nxvxr14/control-celda-fts-mecatronica-UNAB/Electronica/Imagenes/frontalView.png

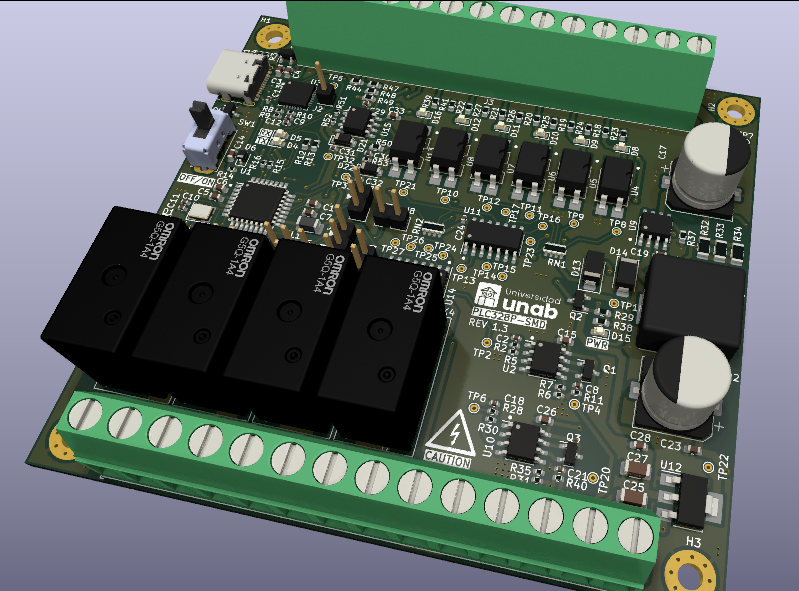
Electronica/Imagenes/frontalView.png
