nxvxr14/control-celda-fts-mecatronica-UNAB/Electronica/README.txt

*3D: Archivos .STL de componentes electrónicos no incluidos en las librerías de KiCad.
*Datasheets: Documentos en formato .pdf de las especificaciones de los distintos componentes utilizados en las tarjetas.
*Esquemáticos de referencia: Documentos .pdf con los esquemáticos de algunas tarjetas Arduino.
*Esquemáticos finales PDF: Documentos .pdf con los esquemáticos definitivos de las tarjetas del proyecto.
*Huellas y símbolos: Archivos de componentes necesarios que no se encuentran en las librerías nativas de KiCad.
*Imágenes: Archivos .PNG con las vistas 3D de las tarjetas.
*PCB Designs: Incluye los cuatro diseños electrónicos, con sus respectivos esquemáticos, símbolos, ruteados y referencias de componentes para su fabricación en JLCPCB, se abre con Kicad 7.0 o más:

-schematicFisher: Tarjeta para la adecuación de señales, convirtiendo voltajes de 9V a 24V y viceversa.
-schematicPLC: Tarjeta principal del PLC.
-schematicPowerSourcePLC: Tarjeta de alimentación para el PLC, con las fuentes de voltaje necesarias.
-schematicShieldPLC: Tarjeta diseñada para conectar un Arduino Mega al PLC.

*plcIMG.pretty: Archivo generado automáticamente por KiCad.
*Recortes de placa: No utilizado en el proyecto.
*Simulaciones: Simulaciones de los distintos circuitos implementados, realizadas en Proteus.
