nxvxr14/control-celda-fts-mecatronica-UNAB/Laboratorios/LAB1_INTRODUCCION_ILYZAELLE_CASTRO_DELGADO.pdf

Laboratorio 1: Introducción a Ilyzaelle

### LABORATORIO 1: INTRODUCCIÓN A ILYZAELLE

### 1. Introducción:

En este laboratorio, se aprenderá a configurar y emplear la plataforma Ilyzaelle. A lo largo de las actividades, se familiariza al estudiante con su entorno y sus funcionalidades, y se llevarán a cabo ejemplos prácticos en los que se conectarán dos placas Arduino para establecer una comunicación efectiva entre ellas.

### 2. Objetivos:

1. Instalar y configurar la plataforma Ilyzaelle en un entorno de desarrollo local.
2. Crear un proyecto en la plataforma Ilyzaelle y asociar los controladores.
3. Verificar la comunicación bidireccional entre los Arduinos y la plataforma a través del Gateway.
4. Elaborar la topología de red que describa la interacción entre la plataforma, el Gateway y los controladores.

### 3. Requisitos

### 3.1 Requisitos Software:

1. Node.js (versión 20.x.x)
2. Arduino IDE (versión 1.18.x.x)
3. Python (versión 3.10.x.x)
4. Microsoft C++ Build Tools
5. ilyzaelleGatewayManager_0.1.bat

### 3.2 Requisitos Hardware:

1. 2x Arduino Uno/MEGA

2. 1x Computadora Windows 11

### 4. Marco Teorico:

### 4.1 Definiciones claves:

Gateway IoT: Dispositivo o software que actúa como intermediario entre los nodos finales (sensores y actuadores) y la nube, gestionando protocolos, seguridad y enrutamiento de datos para garantizar la comunicación eficiente en sistemas de Internet de las Cosas (Stallings, 2013).

Plataforma IoT: Entorno integrado de hardware, software y servicios en la nube que permite el registro, la gestión, el almacenamiento y el análisis de datos generados por dispositivos conectados, facilitando la creación y el despliegue de aplicaciones IoT (Greengard, 2015).

Protocolo de comunicación: Conjunto de reglas y convenciones que definen el formato, la secuencia y la semántica de los mensajes intercambiados entre dos o más entidades de red, asegurando interoperabilidad y fiabilidad en la transmisión de información. (Tanenbaum & Wetherall, 2011).

JavaScript: Lenguaje de programación interpretado, orientado a eventos y de un solo hilo, que se ejecuta en el motor de JavaScript del entorno (por ejemplo, en el navegador o en Node.js). A diferencia de Arduino, donde el programa se basa en un bucle infinito loop(), JavaScript emplea un event loop que gestiona una cola de eventos y callbacks, procesando cada uno de manera asíncrona según la disponibilidad de recursos y las operaciones de E/S (Flanagan, 2011).

Socket-IO: Biblioteca de JavaScript que facilita la creación de aplicaciones web en tiempo real mediante una comunicación bidireccional basada en eventos entre el cliente y el servidor. Utiliza WebSocket cuando está disponible y, de forma transparente, recurre a otras tecnologías como polling largo o Flash Sockets en navegadores que no lo soportan (Buna, 2012).

### 4.2 Preguntas claves:

¿Qué es Node.js y para qué se utiliza en este contexto?
Node.js es un entorno de ejecución de JavaScript que posibilita la ejecución de código en el servidor. En este laboratorio, se emplea para gestionar el gateway y programar las placas Arduino sin recurrir al Arduino IDE.

¿Cómo se comunican las placas Arduino entre sí y con la plataforma Ilyzaelle?
Las placas Arduino se comunican a través de puertos USB con el ordenador donde está instalado el gateway. Este gateway, a su vez, se conecta con la plataforma Ilyzaelle a través de sockets-io.

¿Qué protocolo de comunicación emplean las placas Arduino para conectarse con el Gateway?
Resulta fundamental comprender que tanto el gateway como los controladores se apoyan en un protocolo propietario —ya sea a través de USB o por Wi‑Fi— para definir, entre otros aspectos, el formato de los mensajes intercambiados, la velocidad de transmisión y los mecanismos de detección de errores. Este esquema uniforme garantiza una conexión fiable y facilita la sincronización de datos entre las distintas unidades.

### 5. Procedimiento:

### 1. Configuración de la plataforma Ilyzaelle:

Paso 1: Abrir el programa IlyzaelleGatewayManager_0.1.

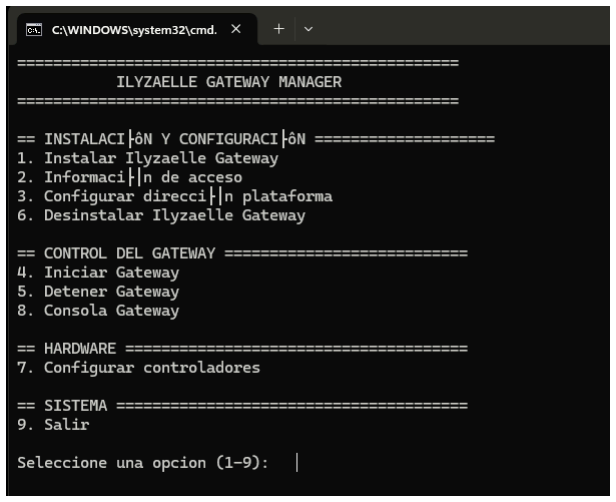
[picture p2: figure]

Paso 2: Instalar el programa. Para ello, escribe el número 1 y presiona Enter. Luego, espera a que el instalador termine el proceso de instalación.

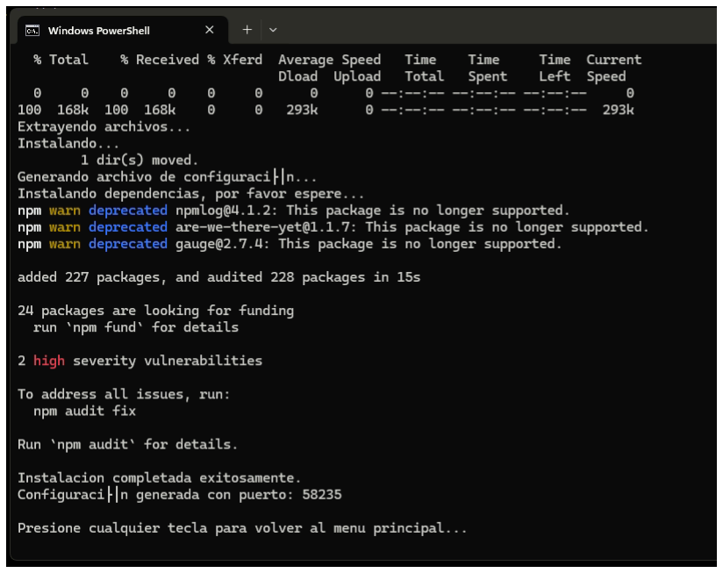
[picture p3: figure]

Paso 3: Configurar los Arduinos.
Una vez que el Gateway está instalado en el computador, procedemos a configurar los controladores. En este caso, utilizaremos dos Arduinos: un Arduino Uno y un Arduino Mega, ambos conectados por USB.
- Conecta ambos Arduinos a sus respectivos puertos USB.
- En el programa IlyzaelleGatewayManager, selecciona la opción 7: Configurar Controladores.
- Luego, selecciona la opción 1: Arduino Uno para configurar el primer Arduino.

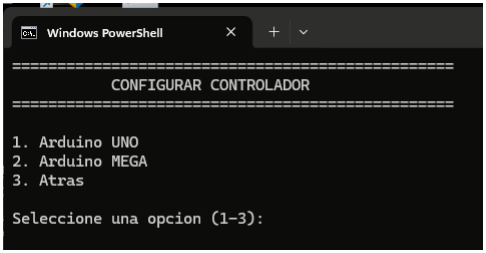
[picture p4: figure]

Una vez realizada la selección, aparecerá una ventana que mostrará cómo está conectado el Arduino. En este caso, selecciona la opción 1: Uno USB para confirmar la conexión del Arduino Uno.

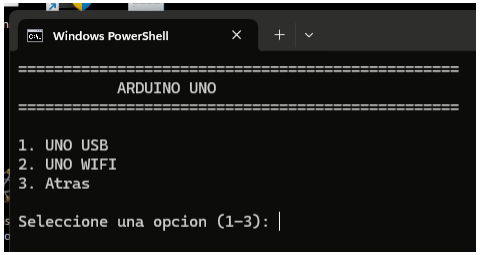
[picture p5: figure]

Aparecerá una ventana que muestra los dispositivos conectados a los puertos COM. Escribe el número del puerto COM al que está conectado tu Arduino y presiona Enter. Por ejemplo: COM6.

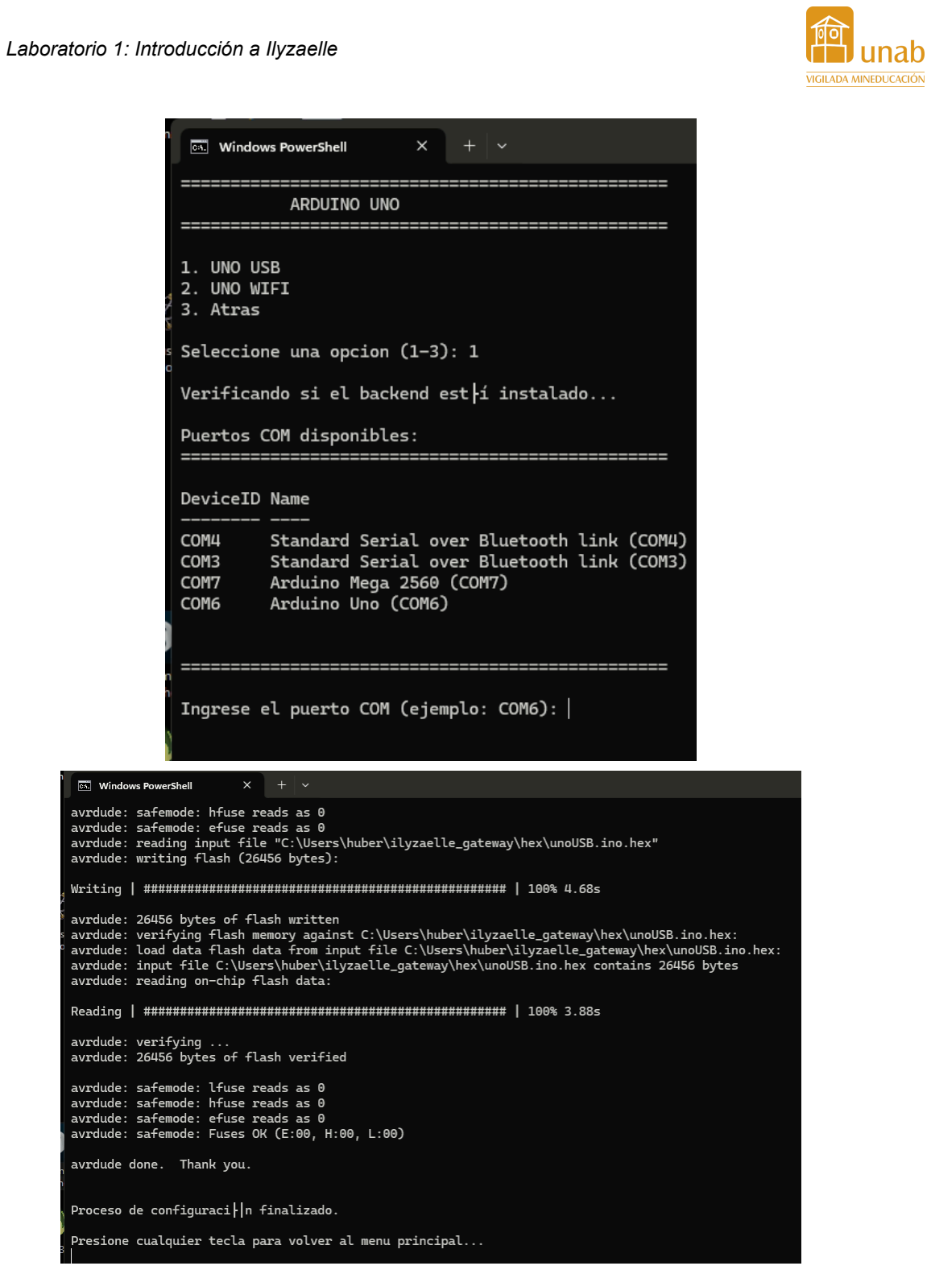
[picture p6: page 6]

Repetimos lo mismo para el mega

Paso 4: Configurar dirección IP de la plataforma

En el menú principal, selecciona la opción 3: Configuración dirección plataforma. Aparecerá la dirección IP actual configurada. Si coincide con la dirección IP de la plataforma, puedes continuar. Si no es la misma, ingresa la nueva dirección IP correspondiente y presiona Enter

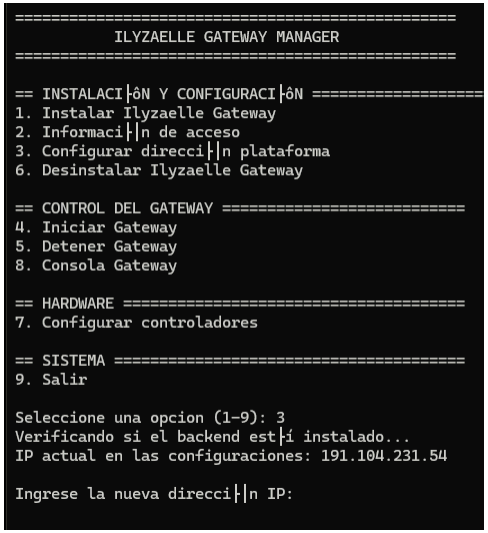
[picture p7: figure]

Nota: La plataforma está alojada en un servidor con IP dinámica, lo que implica cambios periódicos en su dirección. Para garantizar un funcionamiento correcto, es necesario sincronizar la IP del Gateway con la de la plataforma.

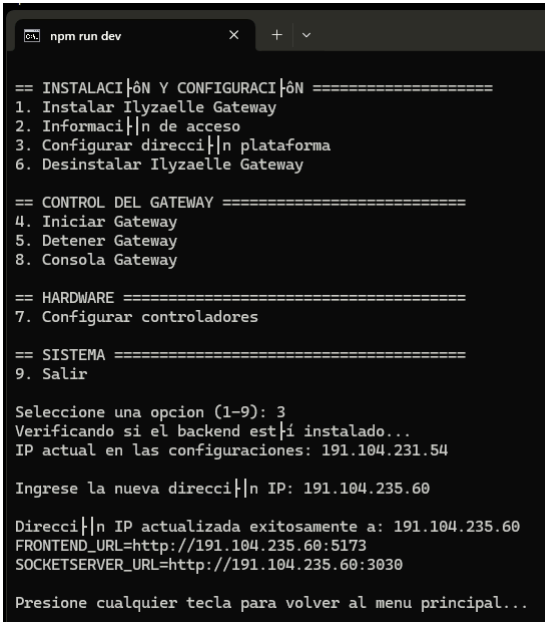
[picture p8: figure]

### 2. Creación proyecto

Paso 1: Accede a la plataforma Ilyzaelle desde tu navegador web.

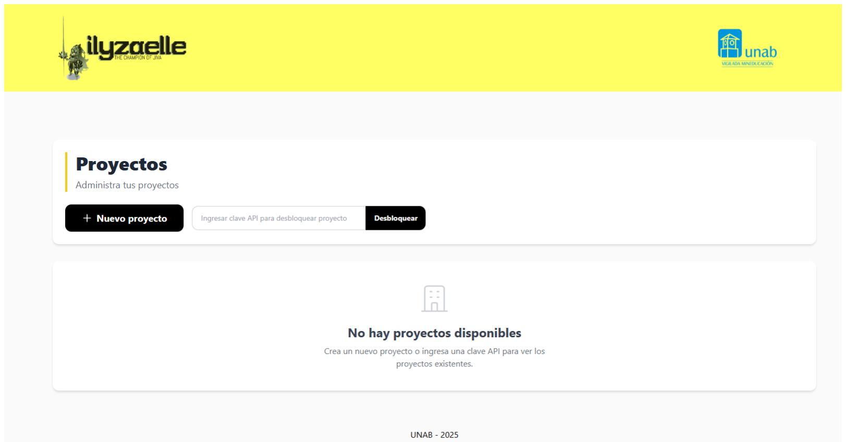
[picture p9: figure]

Paso 2: Selecciona + Nuevo Proyecto. Se abrirá un menú donde crearás un proyecto para trabajar. En este menú, deberás completar los siguientes campos:

- Nombre del proyecto: Puedes poner el nombre que desees.
- Descripción: También es a elección del usuario.
- Gateway: Este dato lo obtendrás del Ilyzaelle Gateway Manager, en la opción 2.
- Gateway API: También se obtiene en la opción 2 del Ilyzaelle Gateway Manager.

Es importante llenar toda la información. Ten especial cuidado de no dejar espacios en blanco, ya que esto puede causar errores en la configuración.

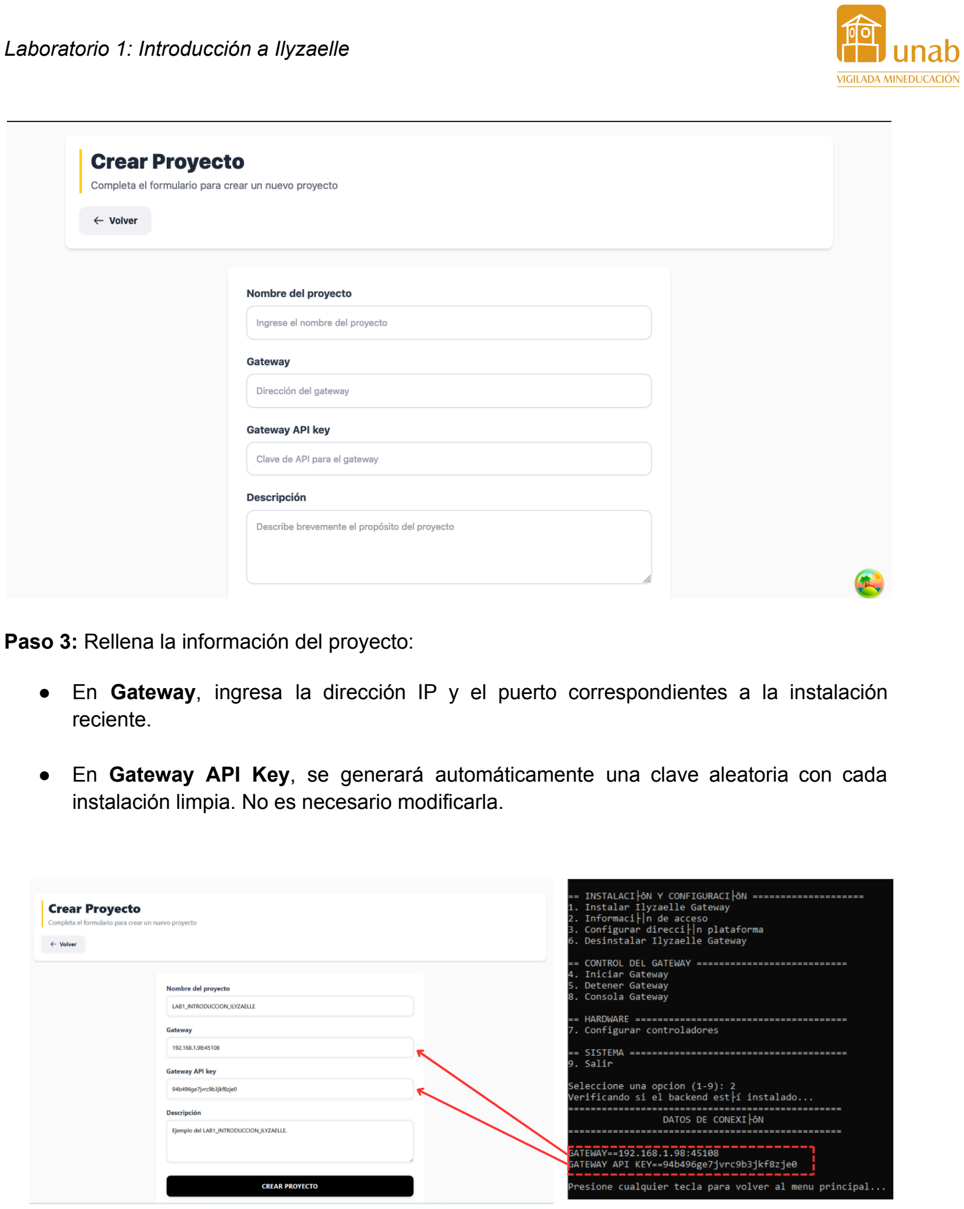
[picture p10: page 10]

Paso 3: Rellena la información del proyecto:

- En Gateway, ingresa la dirección IP y el puerto correspondientes a la instalación reciente.
- En Gateway API Key, se generará automáticamente una clave aleatoria con cada instalación limpia. No es necesario modificarla.

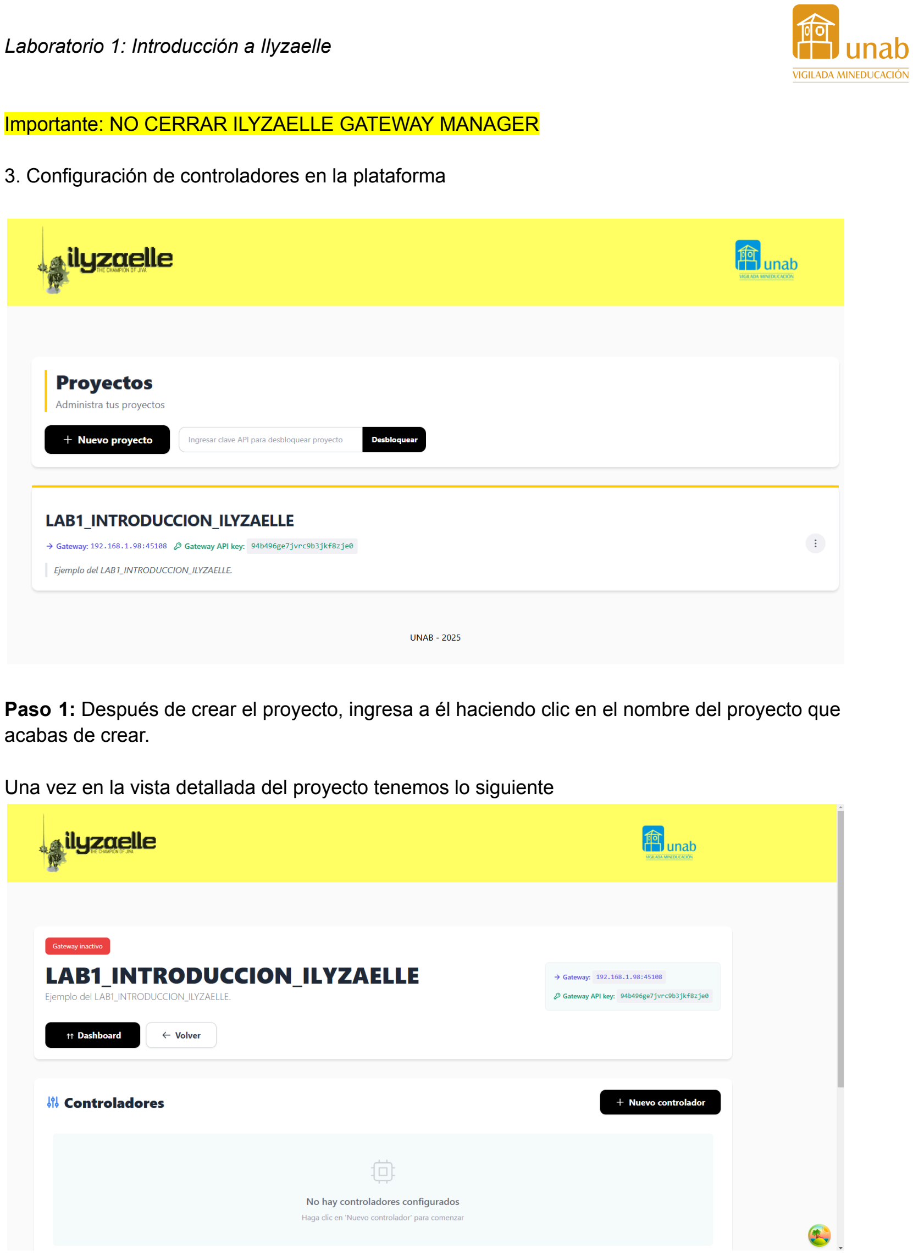
[picture p11: page 11]

Importante: NO CERRAR ILYZAELLE GATEWAY MANAGER

3. Configuración de controladores en la plataforma

Paso 1: Después de crear el proyecto, ingresa a él haciendo clic en el nombre del proyecto que acabas de crear.

Una vez en la vista detallada del proyecto tenemos lo siguiente

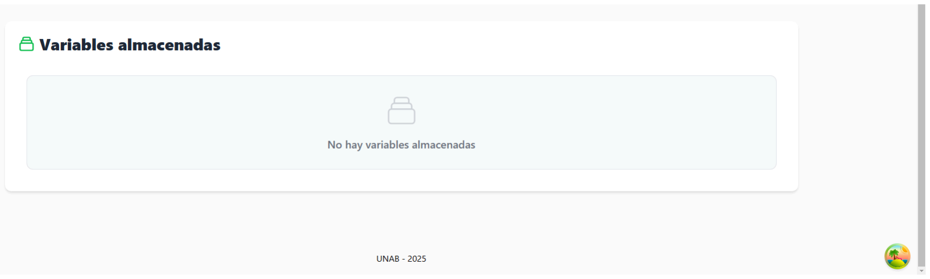
[picture p12: figure]

Gateway inactivo: Indica el estado del gateway.

Dashboard: Aquí podrás visualizar y controlar los datos en tiempo real que se están generando en la plataforma.

Controladores: Esta sección te permite gestionar los controladores, desde su creación y configuración hasta la programación.

Variables almacenadas: Aquí se almacenan los datos históricos que provienen del Dashboard para su posterior consulta o análisis.

Paso 2: Haz clic en + Nuevo Controlador, ubicado en el apartado de Controladores. Esto abrirá un menú que te permitirá configurar el Arduino que vas a utilizar. El menú contiene los siguientes campos:

- Nombre: A elección del usuario (por ejemplo, "Uno Prueba").
- Tipo: Selecciona el tipo de controlador vamos a utilizar. En nuestro caso, seleccionamos Arduino.
- Tipo de conexión: Elige el tipo de conexión que estás utilizando. En este caso, seleccionamos USB.
- Datos de conexión: Aquí deberás ingresar la información correspondiente al puerto de conexión. Para este ejemplo, si estás utilizando un Arduino Uno, solo deberás ingresar el número de puerto (por ejemplo, COM4).

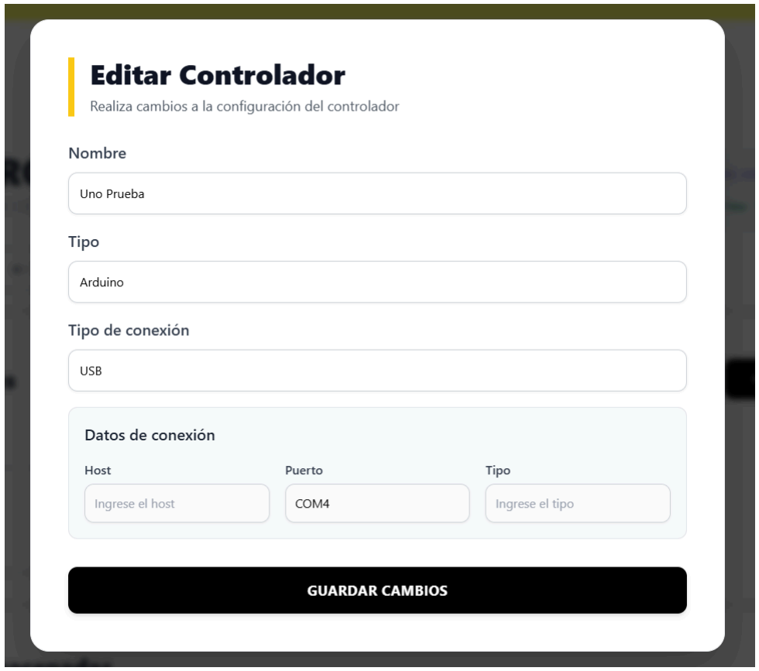
[picture p13: figure]

Realizar el mismo procedimiento con el otro arduino.

Una vez agregados ambos controladores veremos algo así:

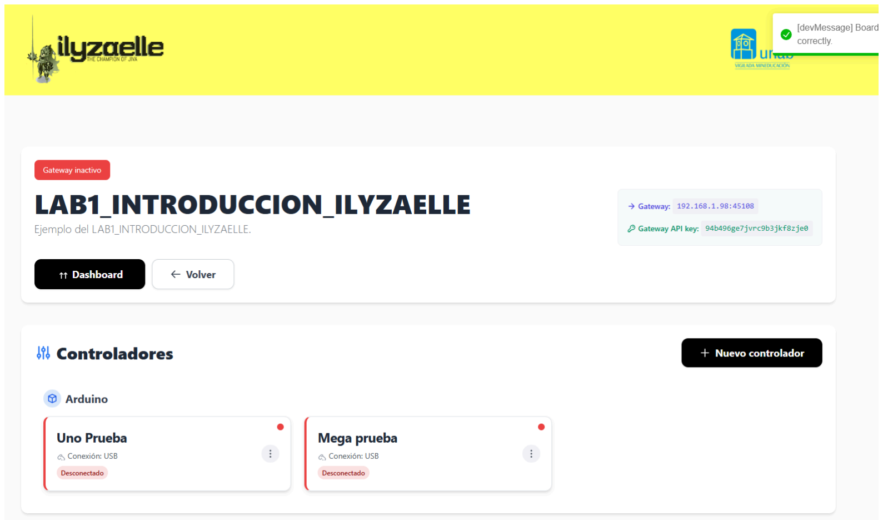
[picture p14: figure]

### 4. Iniciar Gateway

Paso 1: Ahora regresa al Ilyzaelle Gateway Manager y selecciona la opción 4: Iniciar Gateway. Una vez iniciado correctamente, verás cómo el estado del gateway en la plataforma se pone en verde.

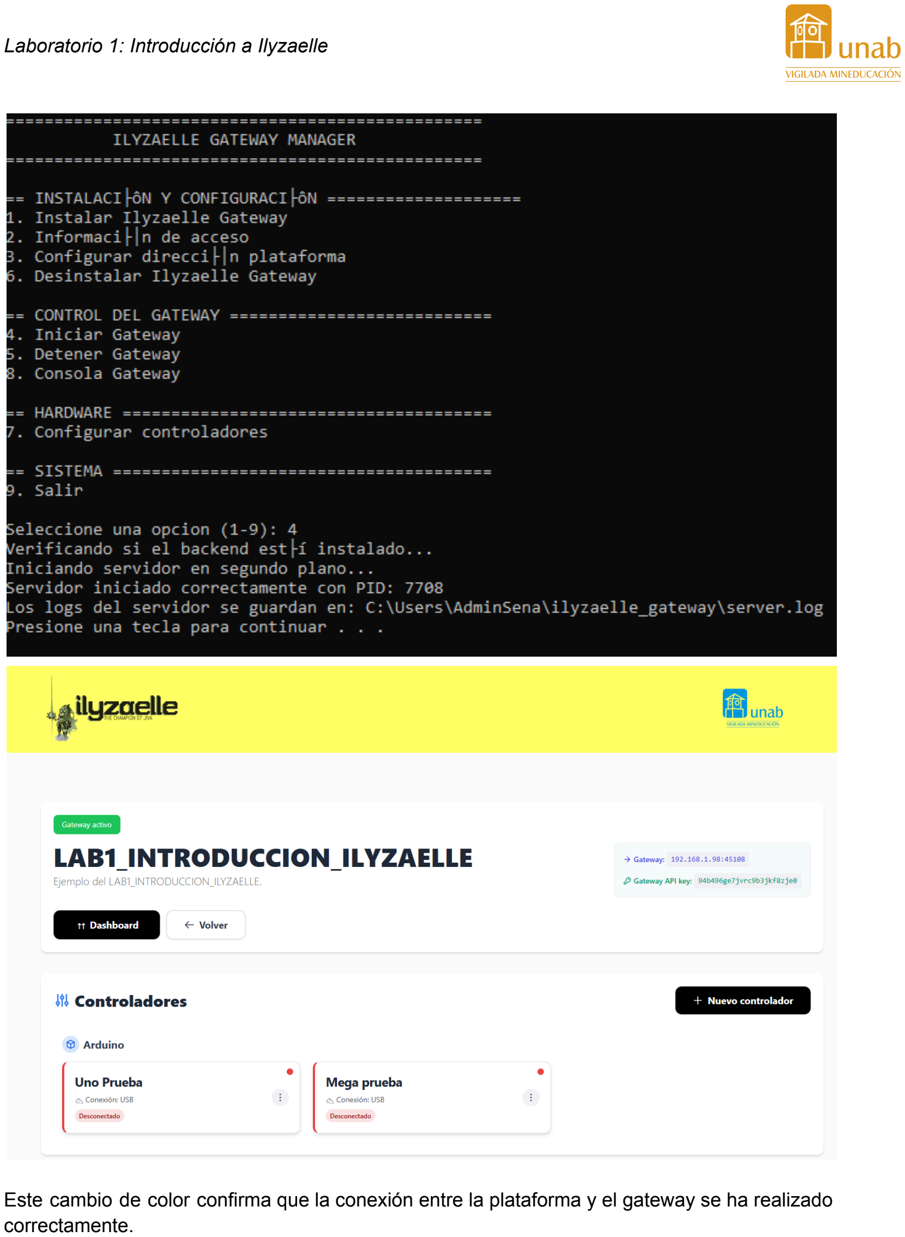
[picture p15: page 15]

Este cambio de color confirma que la conexión entre la plataforma y el gateway se ha realizado correctamente.

### 6. Actividad:

- Crear un diagrama gráfico que ilustre la topología de red. El esquema debe mostrar, para cada dispositivo, los puertos COM o las direcciones IP utilizadas y cómo se interconectan entre sí. Como mínimo, debe incluirse el gateway, los controladores y la plataforma IoT.

### 7. Bibliografía:

- Flanagan, D. (2011). JavaScript: The Definitive Guide (6th ed.). O'Reilly Media.
- Greengard, S. (2015). The Internet of Things. MIT Press.
- Stallings, W. (2013). Data and Computer Communications (10th ed.). Pearson.
- Tanenbaum, A. S., & Wetherall, D. J. (2011). Computer Networks (5th ed.). Prentice Hall.
- Buna, S. (2012). Socket.IO Real-time Web Application Development. Packt Publishing.
