nxvxr14/control-celda-fts-mecatronica-UNAB/Laboratorios/LAB3_PROGRAMACION_CELDAS_FISCHERTECHNIK_CASTRO_DELGADO.pdf

Laboratorio 3: Programación en Ilyzaelle

### LABORATORIO 3: PROGRAMACIÓN DE CELDAS MECATRÓNICAS FISCHERTECHNIK CON LA PLATAFORMA ILYZAELLE

### 1. Introducción:

En el presente laboratorio se abordará la programación y puesta en marcha de dos celdas mecatrónicas de Fischertechnik. La primera celda está diseñada para la clasificación de piezas según su color, empleando sensores ópticos que permiten identificar y dirigir cada objeto al contenedor correspondiente. La segunda celda realiza el transporte de piezas mediante un brazo accionado neumáticamente, lo cual implica el control de actuadores y electroválvulas.

### 2. Objetivos:

1. Aprender a programar en Izyaelle usando JavaScript.
2. Conectar las dos celdas con los controladores Xelorium.
3. Implementar la operación conjunta y sincronizada de ambas celdas de forma automática.

### 3. Requisitos

### 3.1 Requisitos Software:

1. Node.js (versión 20.x.x)
2. Arduino IDE (versión 1.18.x.x)
3. Python (versión 3.10.x.x)
4. Microsoft C++ Build Tools
5. ilyzaelleGatewayManager_0.1.bat

### 3.2 Requisitos Hardware:

1. 2x Controladores Xelorium
2. 1x Computadora Windows 11
3. 2x Celdas mecatrónicas Fischertechnik (clasificación por color y brazo neumático)

### 4. Marco Teorico:

### 4.1 Definiciones claves:

Celdas mecatrónicas didácticas:
Estaciones modulares utilizadas en la enseñanza técnica que simulan procesos industriales reales, permitiendo experimentar con sensores, actuadores y sistemas de control (Groover, 2007).

Controlador Xelorium:
Es un Arduino PLC educativo desarrollado para este proyecto, que permite la integración y control de sensores y actuadores. Está diseñado para facilitar la programación y monitoreo del sistema mediante entradas y salidas digitales/analógicas, y permite la comunicación entre distintas celdas del proceso automatizado.

JavaScript aplicado a automatización:
Lenguaje de programación flexible y dinámico que puede ser usado en entornos no web, como en sistemas educativos y de automatización, para manejar eventos, condiciones y flujos lógicos (Flanagan, 2020).

Plataforma Ilyzaelle:
Entorno de desarrollo creado para el presente proyecto, orientado al aprendizaje de la automatización mediante la programación de celdas mecatrónicas. Permite trabajar con lógica programada en JavaScript y conectarse a controladores como Xelorium.

### 4.2 Preguntas claves:

¿Qué es una celda mecatrónica y para qué sirve? Es una estación modular que simula un proceso industrial (como clasificar o mover piezas). Sirve para aprender control y automatización de forma práctica (Groover, 2007).

### 5. Procedimiento:

### 5.1. Configuración de la plataforma Ilyzaelle:

Para establecer la conexión entre los dos controladores, se sigue el mismo procedimiento utilizado en el Laboratorio 1: Introducción a Ilyzaelle. En esta etapa se configura tanto la plataforma como los dos controladores Xelorium que se emplearán en la práctica.

5.2. Programación de las celdas mecatronicas.

5.2.1 Declaración de Variables.

En la plataforma Ilyzaelle existen dos tipos de variables que se pueden crear:

- Variables globales: Son compartidas por todo el proyecto y pueden ser accedidas desde cualquier controlador conectado.

Donde:

- gVar["project"] indica que la variable será global en todo el proyecto.
- fototransistor es el nombre de la variable.
- = 0 establece su valor inicial.
- Variables locales: Sólo existen dentro del controlador donde fueron creadas y no pueden ser accedidas desde otros dispositivos.
- let: Palabra clave que se usa para declarar una variable con un alcance (scope) local dentro del bloque donde se define. Permite que el valor de la variable pueda cambiar durante la ejecución del programa.
- voltage: Nombre de la variable que identifica el dato que se va a almacenar. En este caso, representa un valor de voltaje.

- 0: Valor inicial que se asigna a la variable voltage. Aquí se inicia en cero.

5.2.2 Declaración de pines de Arduino

Para usar sensores y actuadores con Arduino, es importante saber en qué pin físico están conectados en la placa. Esto permite al programa identificar y controlar cada dispositivo correctamente.

- const: Palabra clave que declara una constante, es decir, un valor que no cambiará durante la ejecución del programa.
- fototransistor: Nombre que damos al pin donde está conectado el sensor, para poder referirnos a él fácilmente en el código.
- = 30: Asignación del número del pin físico (en este caso, el pin número 30) al nombre fototransistor.

2.3 Declaración tipo de pin

En este apartado declaramos el tipo de pin, que puede ser entrada o salida digital, entrada analógica o salida analógica (que en Arduino se implementa como PWM).

Dependiendo el tipo se declara:

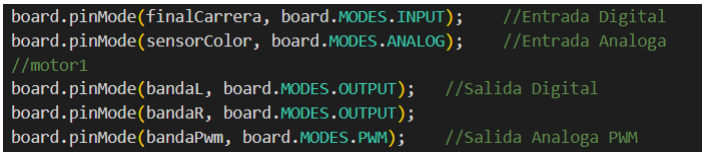
[picture p16: figure]

Procedimiento.

Para leer el estado de un sensor digital (como un final de carrera), se usa la función digitalRead de la siguiente forma:

Pegar el código CODIGOLECTURADIGITAL.txt en el controlador de la Banda Transportadora.

Ir al Dashboard y ver las variables globales.

Explicación del código:

- board.digitalRead(...) Esta función lee el valor (0 o 1) del pin definido como finalCarrera. Se ejecuta cada vez que el pin cambia su estado.
- (value) => { ... } Es una función flecha que se ejecuta automáticamente cuando se detecta un cambio en el pin. El valor leído (0 o 1) se recibe como value.
- gVar["project"].finalCarrera = value; Guarda el valor leído en una variable global llamada finalCarrera, para que pueda ser usada en cualquier parte del proyecto.

Para leer un valor analógico desde un sensor (como un sensor de color), se utiliza la función analogRead de la siguiente forma:

Pegar el código CODIGOLECTURAANALOGO.txt en el controlador de la Banda Transportadora.

Ir al Dashboard y ver las variables globales.

Explicación del código:

- board.analogRead(...):
Lee un valor analógico desde el pin conectado al sensor. Este valor varía entre 0 y 1023 dependiendo de la señal analógica que reciba (por ejemplo, de un sensor de color o luz).
- sensorColor:
Es el nombre de la constante que representa el pin donde está conectado el sensor.
- (value) => { ... }:
Función flecha que recibe el valor leído y realiza operaciones con él.
- value.toFixed(2):
Redondea el valor leído a dos decimales para mayor precisión en la conversión. ●
(value / 1023) * 10:
Convierte el valor leído al rango de voltaje (0–5 V), ajustado al factor de escala usado en el proyecto. (Nota: comúnmente sería * 5, pero si estás usando * 10, asegúrate de que sea por diseño de tu sistema).
- gVar["project"].sensorColor = voltage;:
Guarda el valor del voltaje en una variable global, para que se pueda usar en cualquier parte del programa.

Cuando se desea mover un motor, se pueden usar tres pines conectados a un puente H: dos pines digitales para controlar el sentido de giro, y un pin PWM (salida analógica) para regular la velocidad.

Copiar el código del puente h CODIGOPUENTEH.txt en el controlador de la BandaTransportadora.

Desde el panel del Dashboard, se deben agregar al HMI las variables globales necesarias. En este caso, se inserta un input para la variable bandaVelocidad, que permitirá modificar la velocidad de la banda transportadora, y un toggle para la variable barreraPrueba, que habilita activar o desactivar la barrera según se requiera.

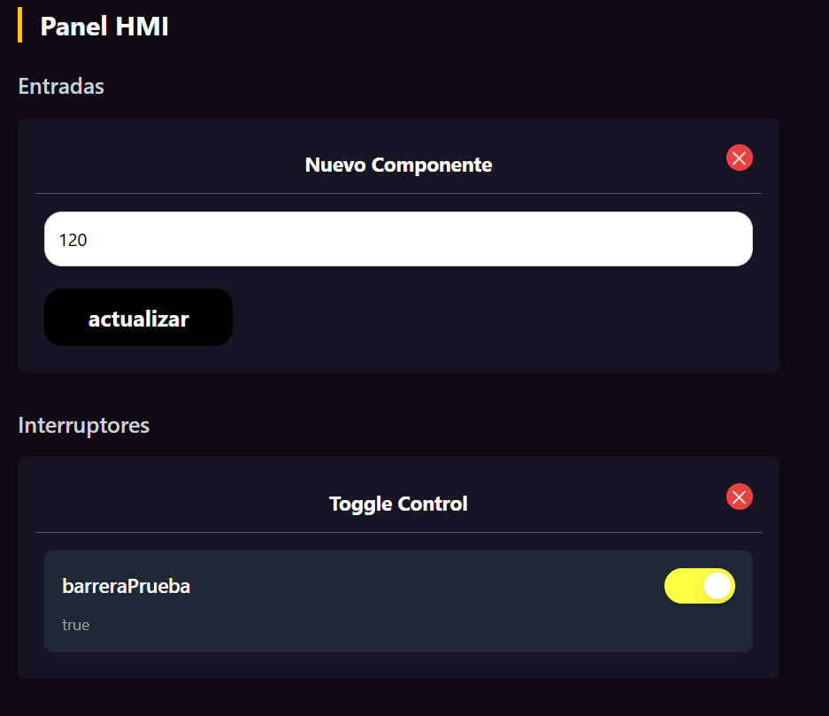
[picture p17: figure]

Explicación:

- bandaL y bandaR: Son los pines digitales que controlan la dirección del motor.
- bpwm: Es el valor PWM (de 0 a 255) que define la velocidad del motor.
- digitalWrite(pin, valor): Escribe un 0 (apagado) o 1 (encendido) en un pin digital.
- analogWrite(pin, valor): Envía una señal PWM al pin correspondiente, lo que permite regular la potencia (velocidad del motor).

Importante:

Nunca se deben activar ambos pines digitales (bandaL y bandaR) al mismo tiempo con valor 1. Esto podría generar un cortocircuito en el puente H y dañar el componente o el microcontrolador.

Para controlar un relé, se utiliza la función de escritura digital en el pin al que está conectado. Esta escritura define si el relé permite o no el paso de corriente:

Pegar Código de Relés CODIGORELES.txt en el controlador del Brazo Neumático.

Desde el Dashboard, se deben incorporar al HMI las variables globales correspondientes a los tres relés del sistema, utilizando el componente toggle para cada uno.

La activación o desactivación de estos toggles permitirá controlar directamente las electroválvulas asociadas, permitiendo así gestionar el funcionamiento neumático del sistema según las necesidades del proceso.

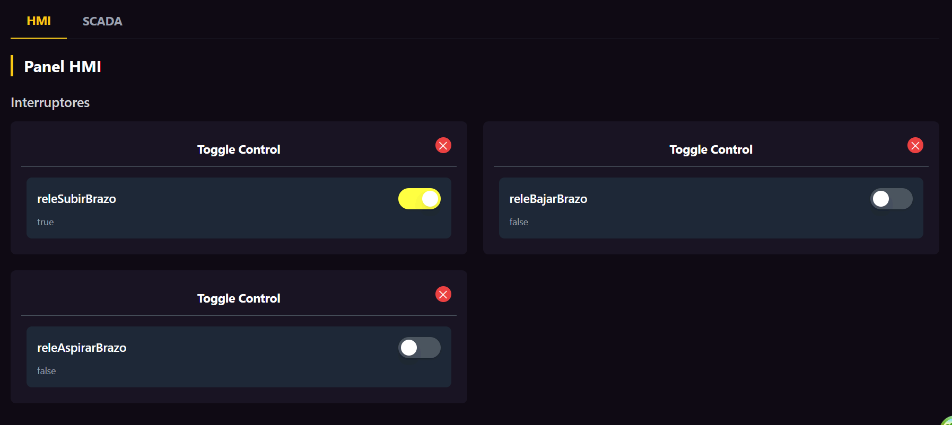
[picture p18: figure]

Explicación:

- Un valor 1 en el pin digital activa el relé y permite que el voltaje pase.
- Un valor 0 desactiva el relé y corta el paso del voltaje.

Importante:

No debes activar continuamente el relé si ya está encendido. Repetir la activación innecesariamente puede causar desgaste prematuro del componente o errores en el sistema.

Proceso General de las celdas Mecatrónica FischerTechnik.

Proceso General Banda Transportadora.

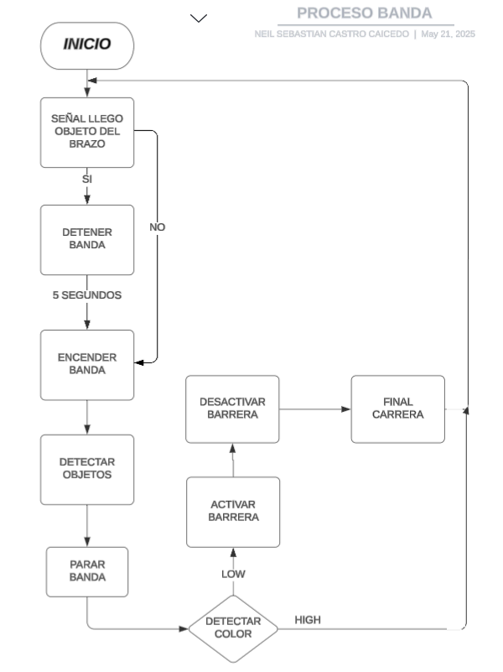
[picture p19: figure]

Explicación del código general de la banda transportadora.

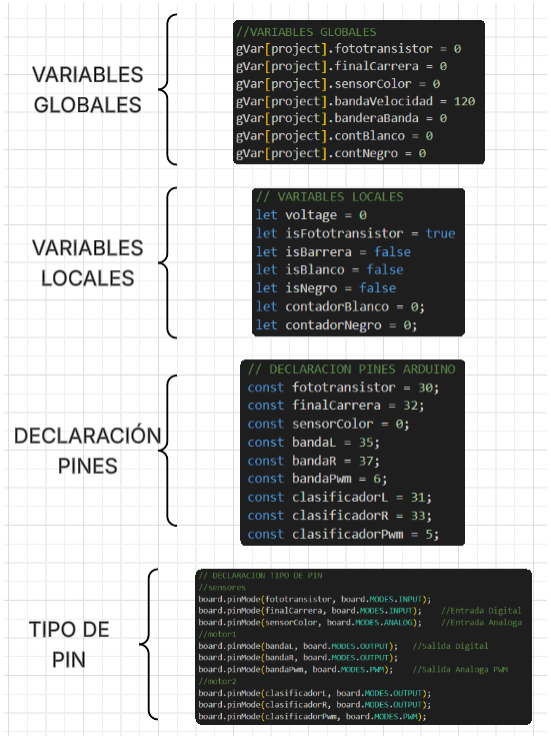
[picture p20: figure]

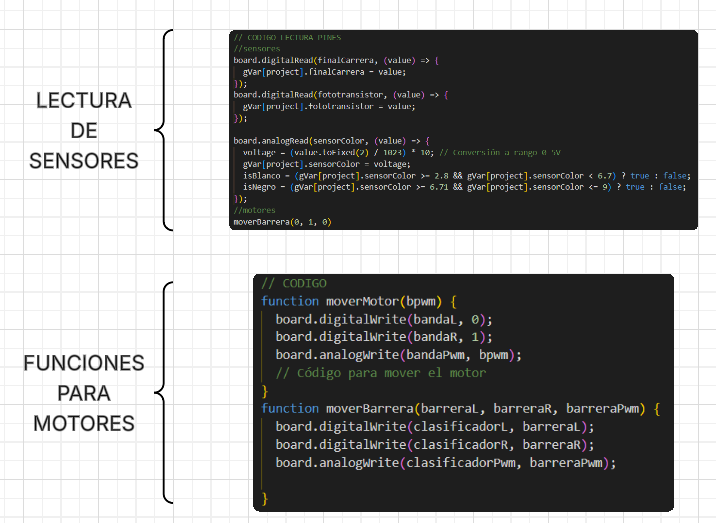
[picture p21: figure]
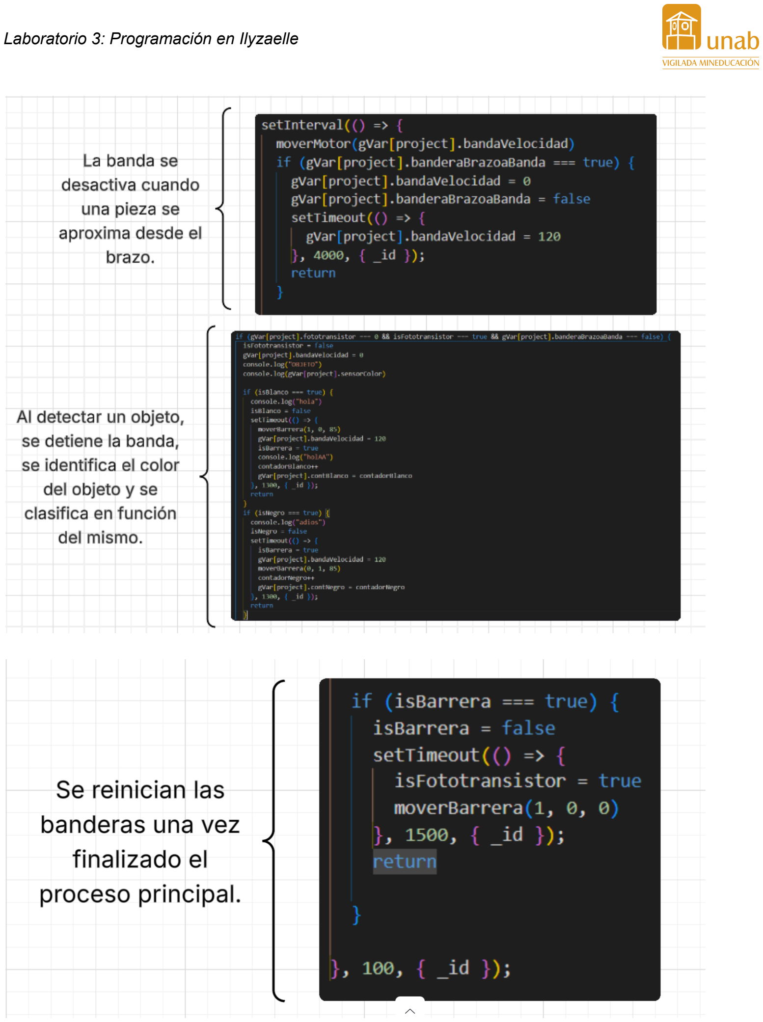
[picture p22: page 11]

Copiar código del CODIGOBANDA.txt y pegar en el controlador de la banda transportadora.

Proceso General Brazo Neumático.

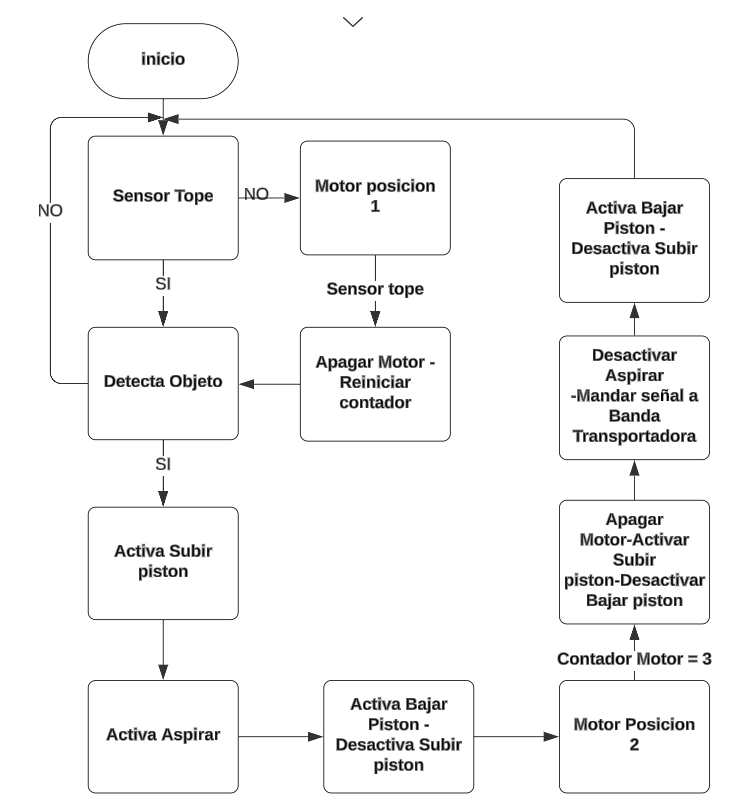
[picture p23: figure]

Explicación del código general de la banda transportadora.

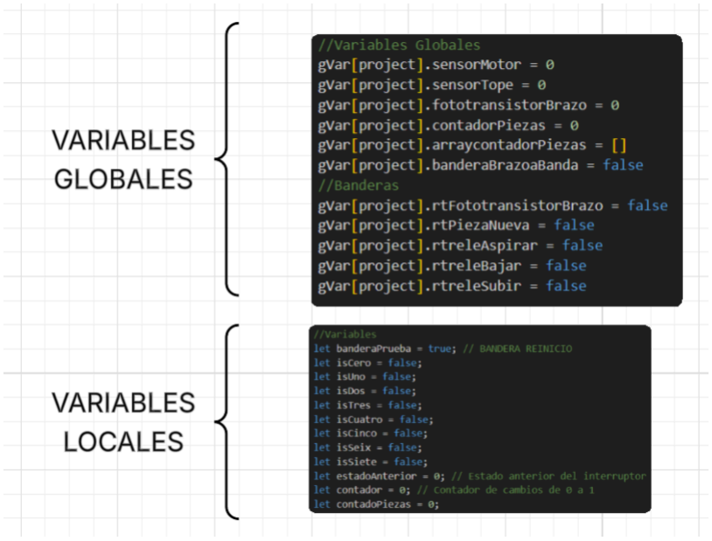
[picture p24: figure]

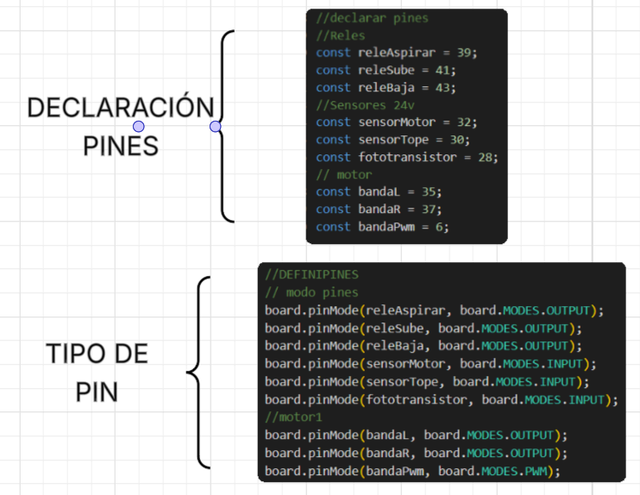
[picture p25: figure]

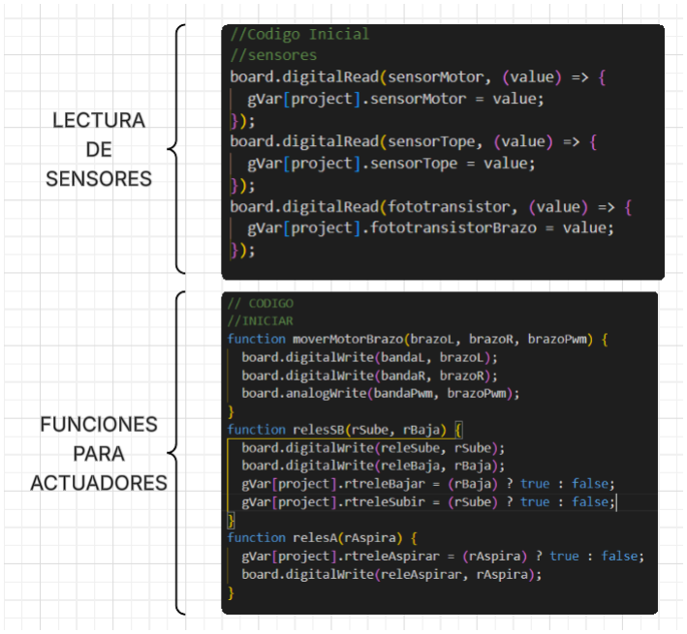
[picture p26: figure]
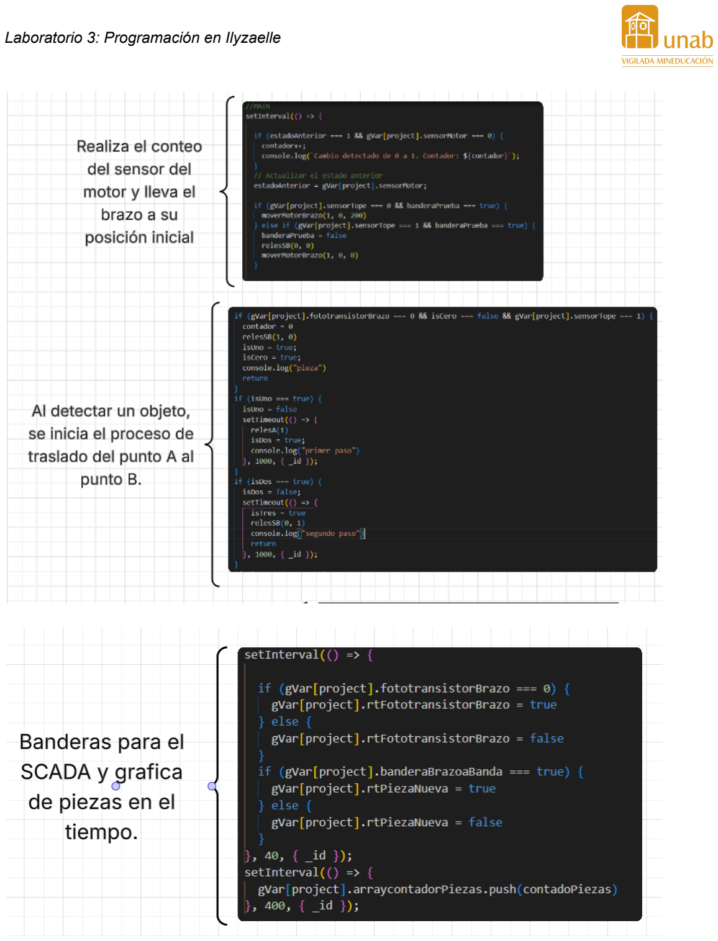
[picture p27: page 16]

Copiar código de CODIGOBRAZOTRANSPORTADOR.txt y pegar en el controlador del Brazo Neumático.

SCADA DEL PROCESO

Para monitorear en tiempo real los sensores y actuadores, se decidió implementar un sistema SCADA que represente el proceso general. Este sistema abarca tanto el transporte como la clasificación de piezas. Para lograr un seguimiento adecuado de cada etapa del proceso, se utilizaron variables que actúan como banderas, permitiendo identificar el estado de cada parte del sistema.

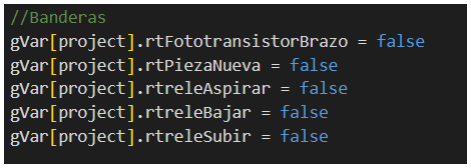
[picture p28: figure]

Para cargar una imagen en el SCADA, ubicado en el panel del Dashboard, es necesario copiar la dirección (URL) de la imagen. En este caso, se insertará la imagen del proceso general. Luego, se hace clic en Aplicar para guardar los cambios, como se muestra en la siguiente imagen:

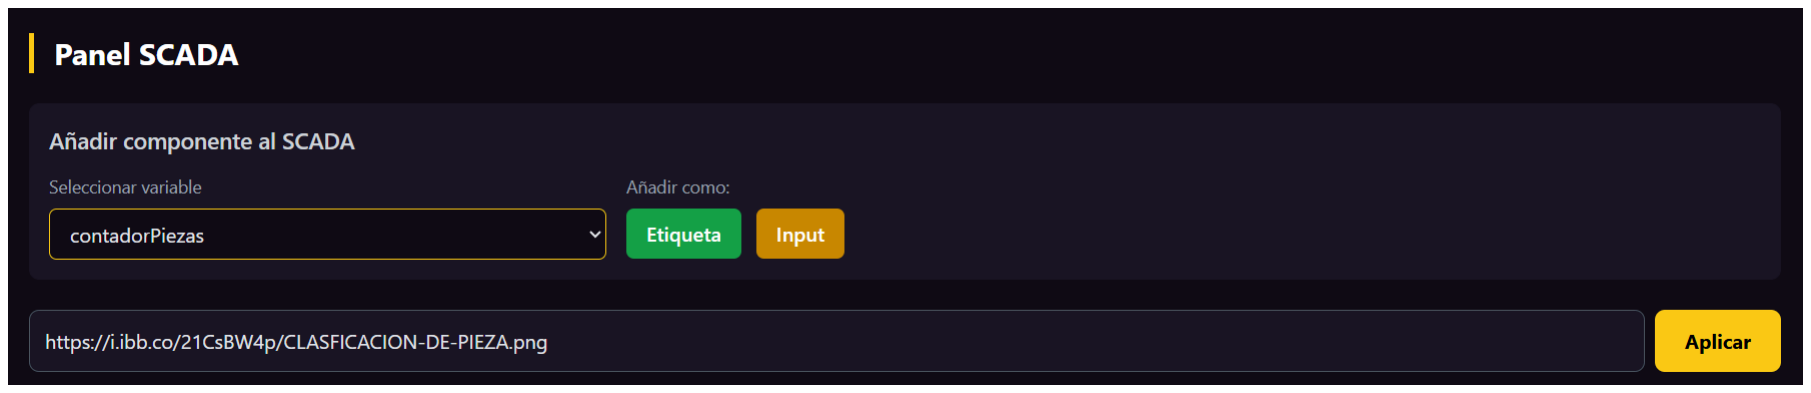
[picture p29: figure]

Para configurar la visualización en el sistema SCADA, nos dirigimos al panel ubicado en el Dashboard. Allí seleccionamos las variables que deseamos mostrar; en este caso, se eligió la variable rtReleAspirar, la cual indica el estado del relé encargado del sistema de aspiración.

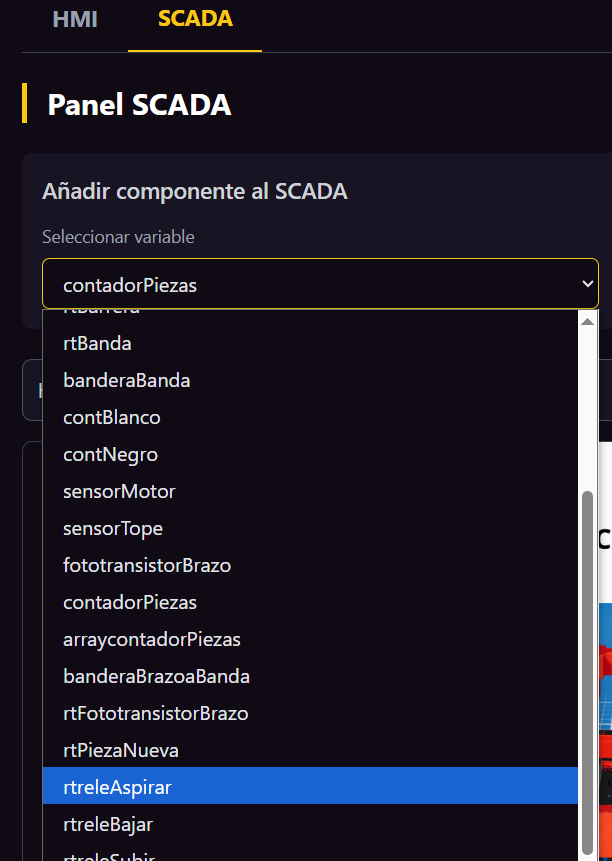
[picture p30: figure]

Dependiendo del tipo de variable seleccionada, aparecerán diferentes opciones para añadirla al SCADA. En este caso, utilizaremos la opción "Añadir como Toggle", que permite ver si esta activa o desactiva una variable.

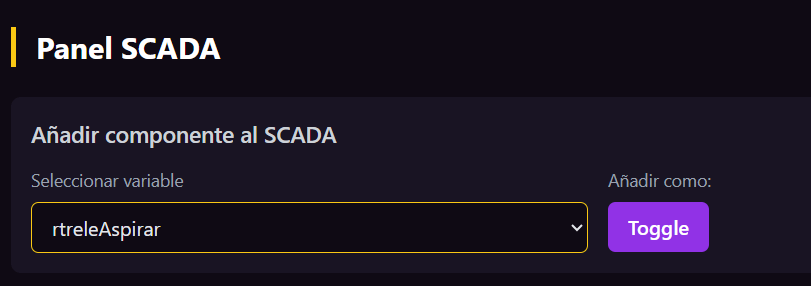
[picture p31: figure]

Al añadirlo como Toggle, este aparecerá en el panel del SCADA, donde podremos ajustar su tamaño, moverlo libremente o eliminarlo según sea necesario para organizar la interfaz de manera clara y funcional.

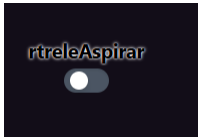
[picture p32: figure]

Lo siguiente es arrastrarlo hasta la ubicación correspondiente dentro del proceso. En este caso, se optó por colocarlo directamente sobre el componente que representa, facilitando así la visualización y el control del sistema en tiempo real.

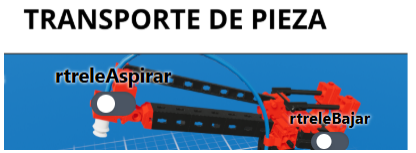
[picture p33: figure]

Se realizó un ejemplo utilizando el apartado de transporte de piezas, donde es posible observar el funcionamiento de los sensores y actuadores principales. Además, se implementó un contador llamado contadorPiezas, el cual incrementa su valor cada vez que una pieza es transportada exitosamente, permitiendo así un seguimiento en tiempo real del proceso.

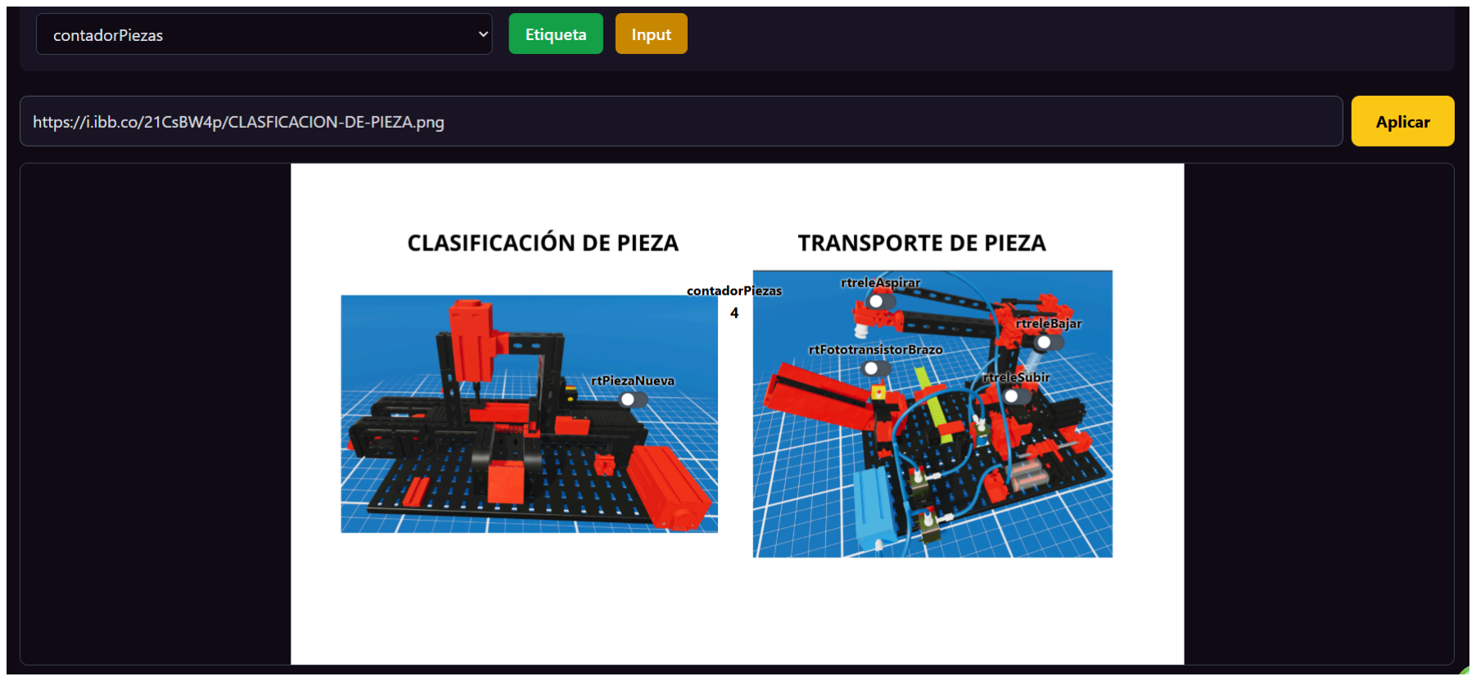
[picture p34: figure]

### 6. Actividad:

- Usando la función SCADA de la plataforma, implementa un panel que utilice las banderas y contadores necesarios para supervisar el correcto funcionamiento de la banda transportadora. El resultado debe ser similar al ejemplo presentado durante el desarrollo del laboratorio. Usa como fondo la imagen del proceso general disponible en el siguiente enlace: https://i.ibb.co/21CsBW4p/CLASFICACION-DE-PIEZA.png

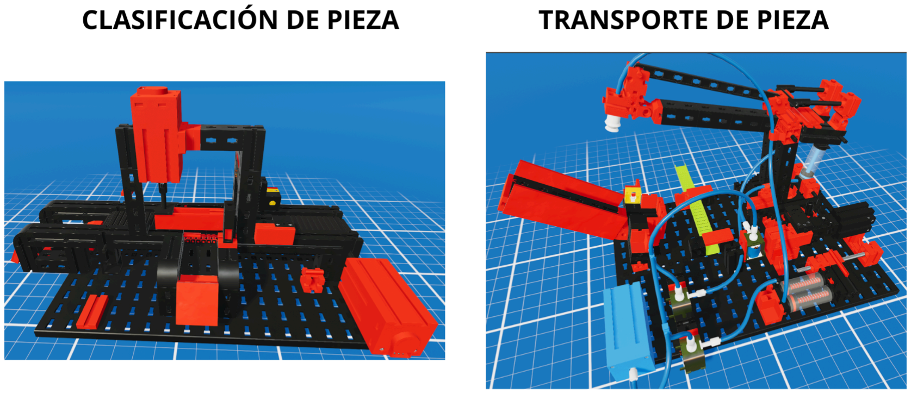
[picture p35: figure]

### 7. Bibliografía:

- Bolton, W. (2015). Mecatrónica: sistemas de control electrónico en la ingeniería mecánica (5.ª ed.). Pearson Educación.
- Groover, M. P. (2007). Automatización, producción y manufactura (3.ª ed.). Pearson Educación.
- Flanagan, D. (2020). JavaScript: The Definitive Guide (7.ª ed.). O'Reilly Media.
- Nise, N. S. (2015). Control Systems Engineering (7.ª ed.). Wiley.
