nxvxr14/control-celda-fts-mecatronica-UNAB/Electronica/3D/Omron G5Q-1A4.step

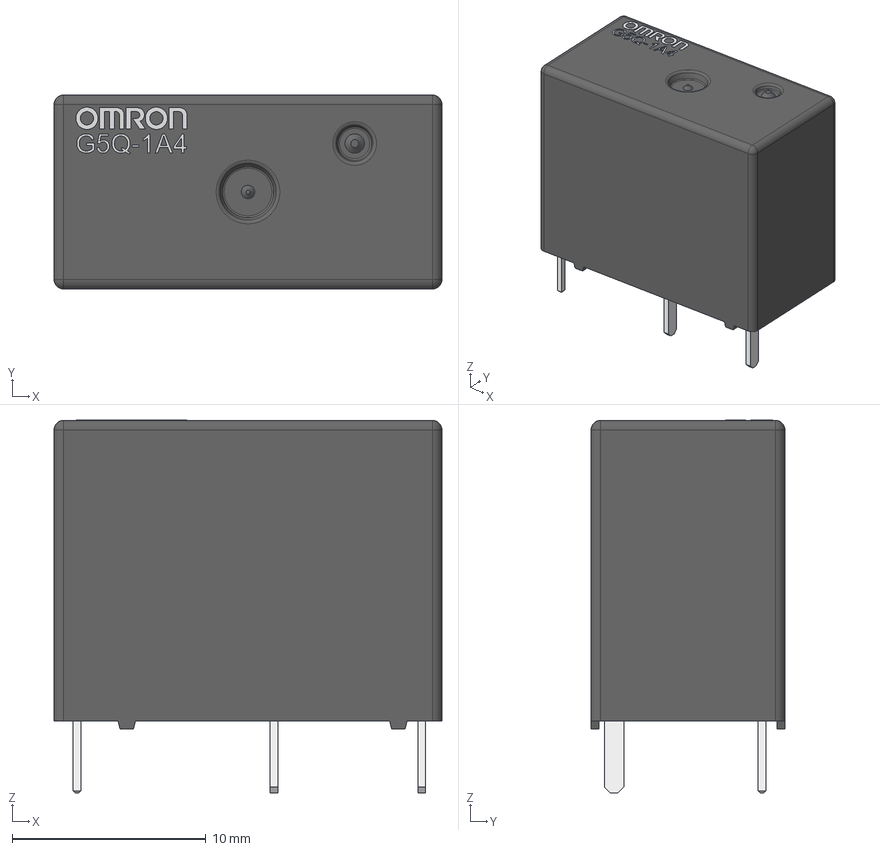
[picture p58: CAD file, 2025-11-04]
Electronica/3D/Omron G5Q-1A4.step
20.0 x 10.0 x 19.2 mm
BaseBody
ResinBody
Pin1Body
Pin2Body
Pin3Body
Pin5Body
O1StringBody
MStringBody
RStringBody
O2StringBody
NStringBody
GShapeStringBody
5ShapeStringBody
QShapeStringBody
-ShapeStringBody
1ShapeStringBody
AShapeStringBody
4ShapeStringBody
