nxvxr14/control-celda-fts-mecatronica-UNAB/Electronica/PCB Desings/schematicPowerSourcePLC_V0.1/schematicPowerSourcePLC_V0.1.step

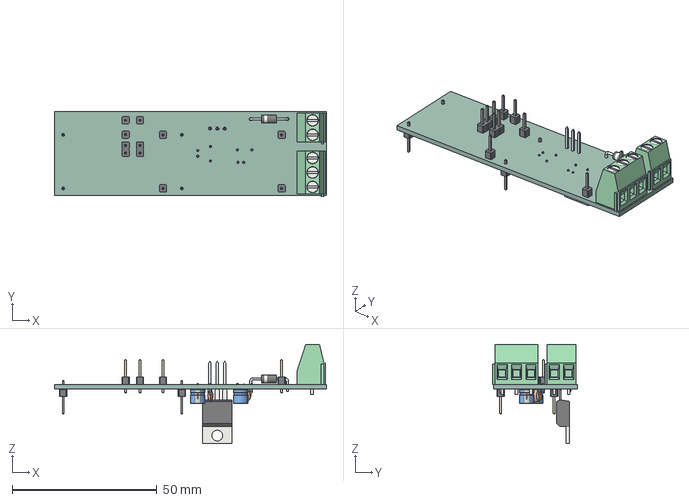
[picture p59: CAD file, 2025-11-04]
Electronica/PCB Desings/schematicPowerSourcePLC_V0.1/schematicPowerSourcePLC_V0.1.step
94.0 x 29.2 x 34.3 mm
schematicPowerSourcePLC_V0.1 PCB
