nxvxr14/control-celda-fts-mecatronica-UNAB/Electronica/Recortes de la placa/box_92x86_Su.dxf

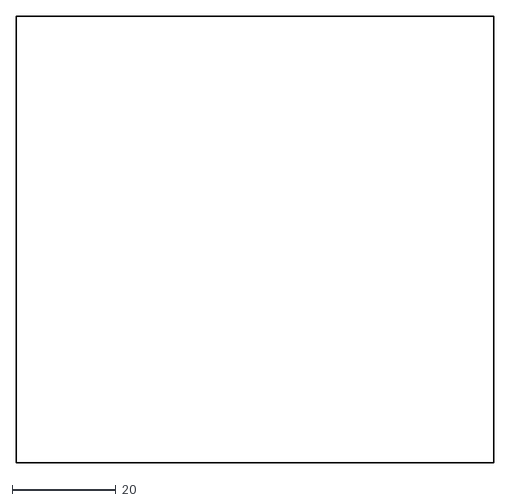
[picture p60: CAD file, 2025-11-04]
Electronica/Recortes de la placa/box_92x86_Su.dxf
92.0 x 86.0
