nxvxr14/control-celda-fts-mecatronica-UNAB/Modelos 3D/Carcasa/Editables/Bisagras34.SLDPRT

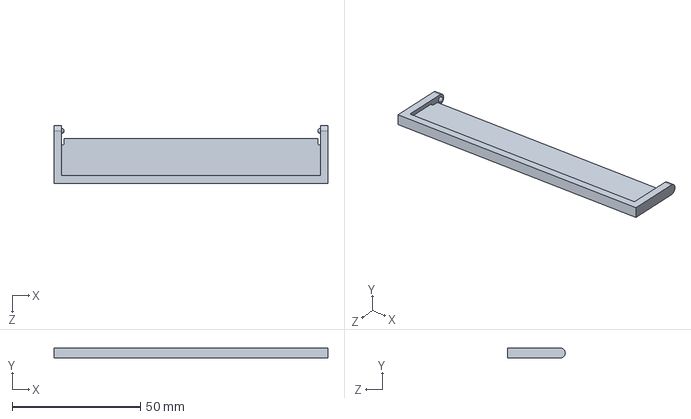
[picture p61: CAD file, 2025-11-04]
Modelos 3D/Carcasa/Editables/Bisagras34.SLDPRT
107.0 x 4.00 x 22.5 mm
