nxvxr14/control-celda-fts-mecatronica-UNAB/Modelos 3D/Carcasa/Editables/ParteInferiorCarcasa.SLDPRT

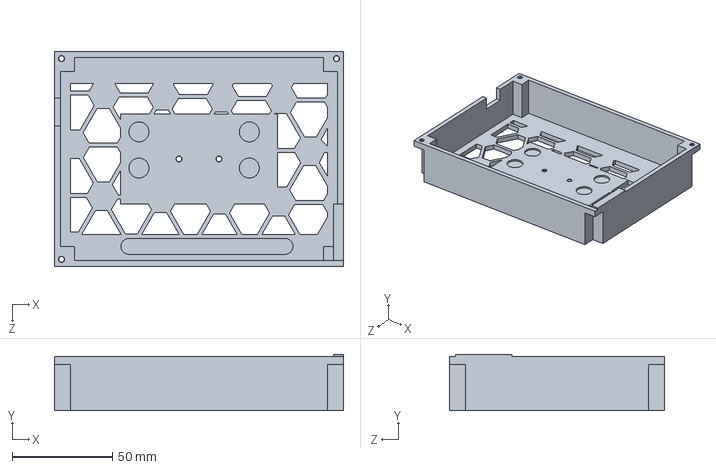
[picture p62: CAD file, 2025-11-04]
Modelos 3D/Carcasa/Editables/ParteInferiorCarcasa.SLDPRT
144.0 x 28.0 x 107.0 mm
