nxvxr14/control-celda-fts-mecatronica-UNAB/Modelos 3D/Carcasa/Editables/Bisagras33.SLDPRT

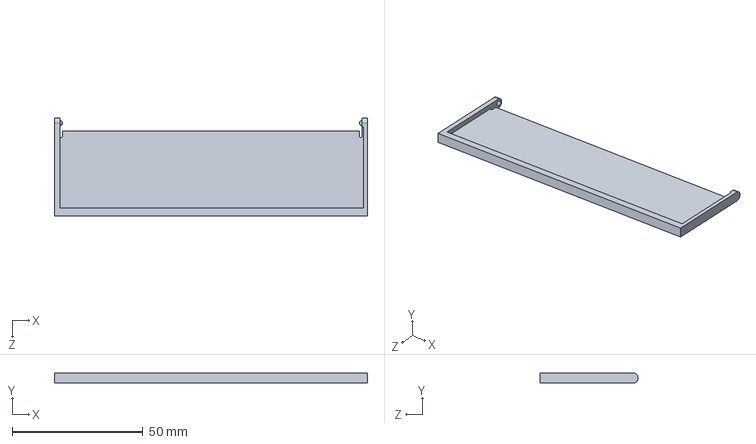
[picture p63: CAD file, 2025-11-04]
Modelos 3D/Carcasa/Editables/Bisagras33.SLDPRT
119.6 x 4.00 x 37.5 mm
