nxvxr14/control-celda-fts-mecatronica-UNAB/Modelos 3D/Carcasa/Editables/ParteSuperiorCarcasa.SLDPRT

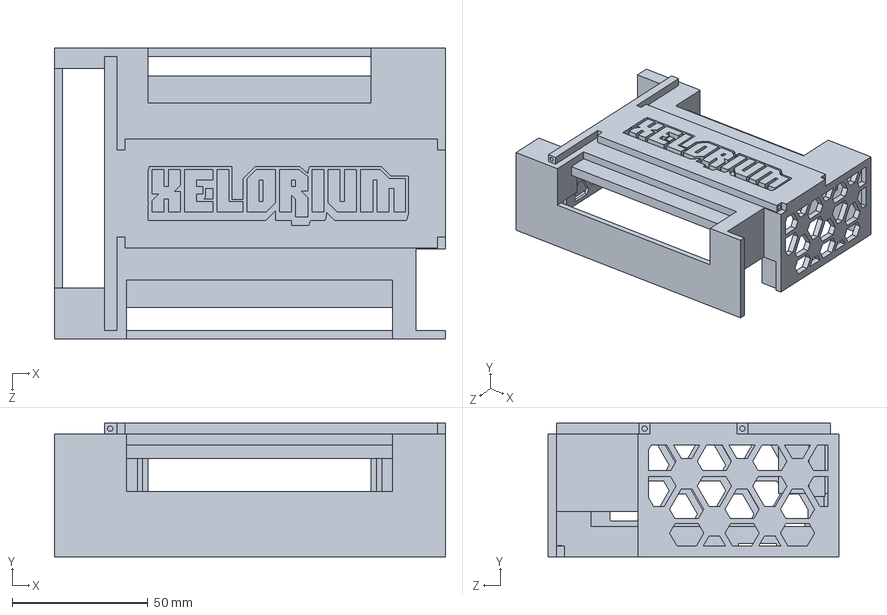
[picture p64: CAD file, 2025-11-04]
Modelos 3D/Carcasa/Editables/ParteSuperiorCarcasa.SLDPRT
144.0 x 49.2 x 107.0 mm
