nxvxr14/control-celda-fts-mecatronica-UNAB/Electronica/3D/OS102011MS2QN1.STEP

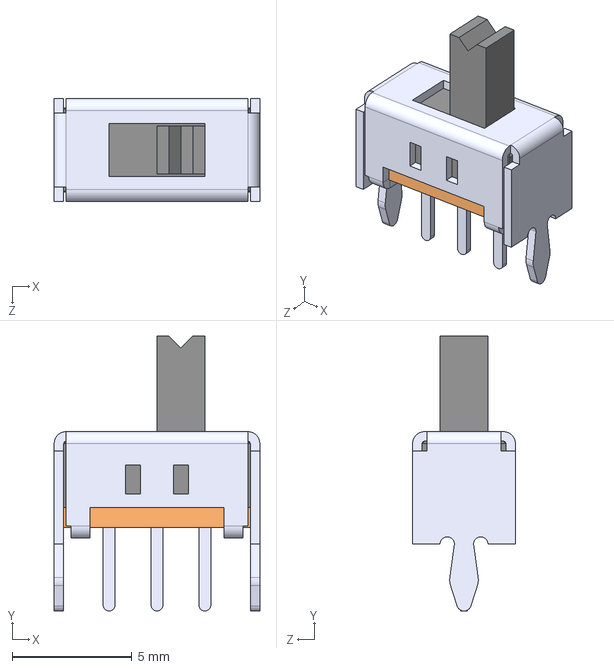
[picture p65: CAD file, 2025-11-04]
Electronica/3D/OS102011MS2QN1.STEP
8.60 x 11.5 x 4.30 mm
