nxvxr14/control-celda-fts-mecatronica-UNAB/(list of files, cad)

Other CAD files:
Electronica/3D/Omron G5Q-1A4-EL.step
Modelos 3D/Carcasa/Editables/schematicPowerSourcePLC_V0.1IFINAL.SLDPRT
