nxvxr14/control-celda-fts-mecatronica-UNAB/Manuales/MANUAL_PROGRAMACION_CASTRO_DELGADO.pdf

# Manual de Programación

Trabajo de Tesis – Ingeniería Mecatrónica

Autores: Neil Sebastian Castro Caicedo – Hubert Armando Delgado Maestre

### 1. Introducción

En este manual se describe el procedimiento básico, paso a paso, para desarrollar un programa exitoso utilizando la plataforma Ilyzaelle. Además, se presentan ejemplos de códigos fundamentales para gestionar diferentes entradas y salidas del controlador Xelorium, aplicados a pequeños ejemplos.

2. Configurar paso a paso con Xelorium.

Lo primero que tenemos que tener en cuenta es que el controlador xelorium, tiene salidas y entradas.

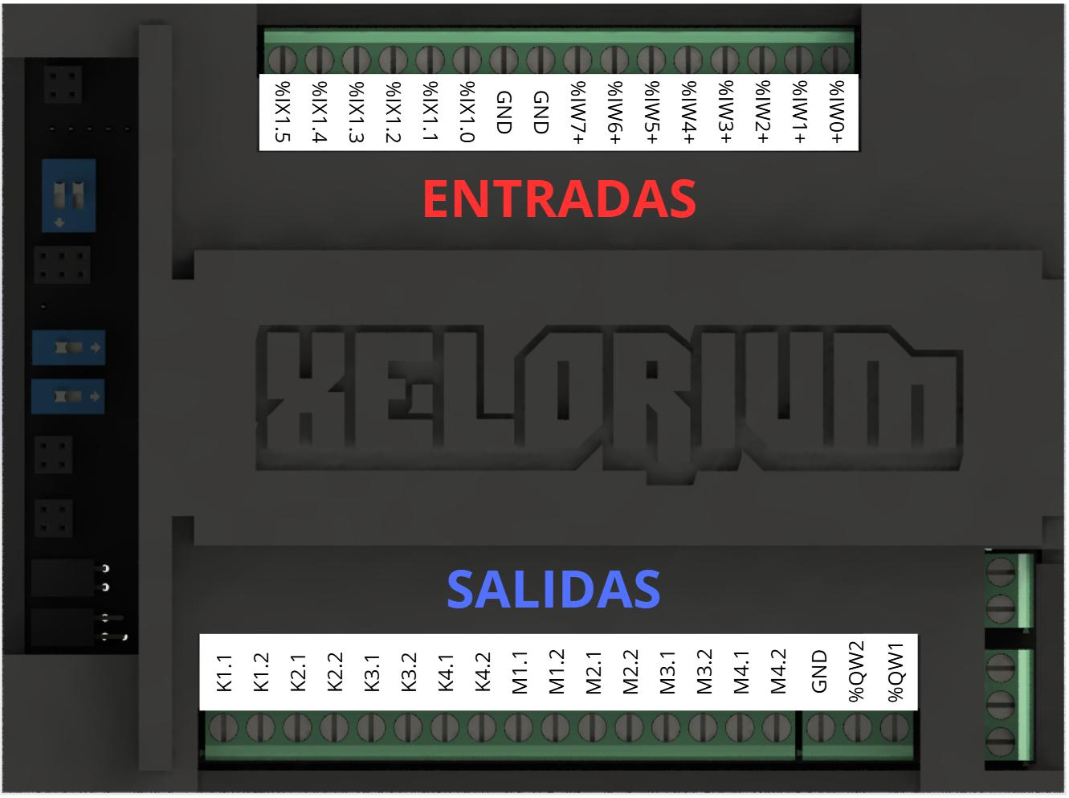
[picture p74: figure]

Al estar basado en Arduino, las diferentes salidas y entradas, están relacionadas a un pin del Arduino mega, para esto dependiendo al entrada o salida, que se usara se debe relacionar con los pines de la tabla:

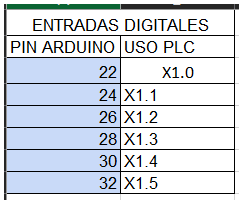
[picture p75: figure]
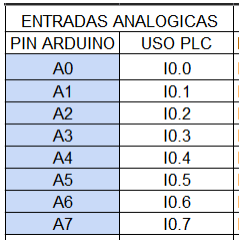
[picture p76: figure]
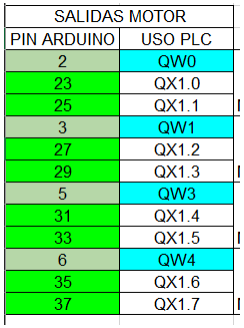
[picture p77: figure]

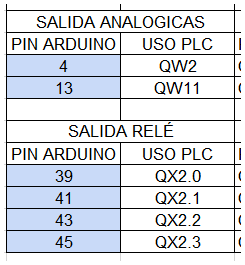
[picture p78: figure]

### 3. Programación Básica:

### Entrada digital

Montaje y configuración:

Decidimos que entrada digital usaremos, en este caso X1.1 buscamos por medio de la tabla su igual en el pin Arduino.

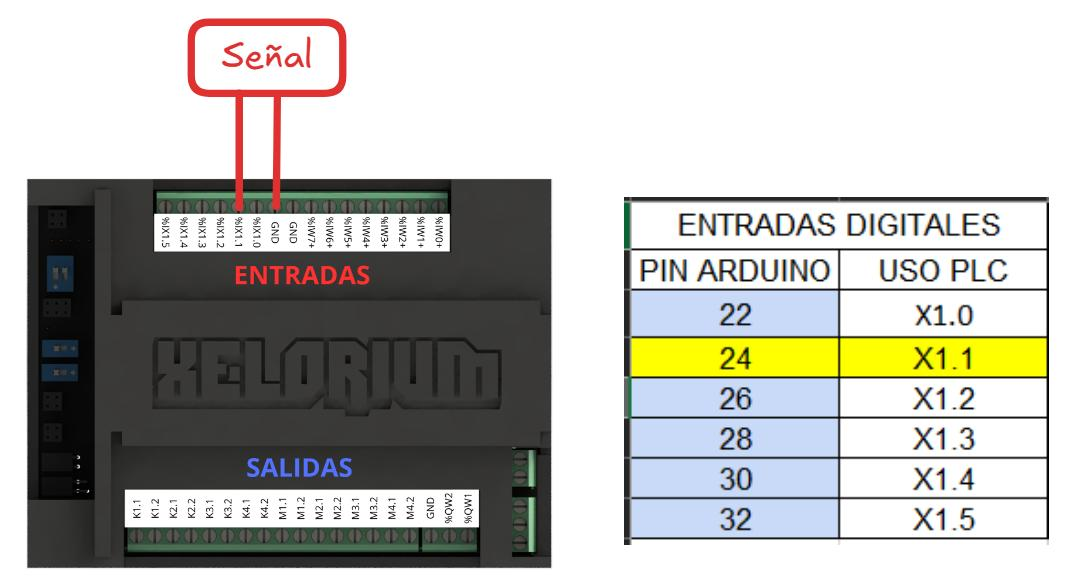
[picture p79: figure]

Código en el editor de la plataforma:

Al tener su igual en el pin Arduino en este caso X1.1 es 24, procedemos a configurarlo en nuestro código.

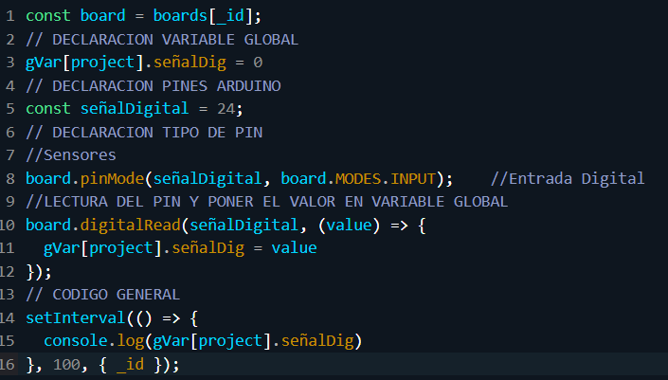
[picture p80: figure]

Resumen:

El código primero selecciona la placa que se va a usar a partir de un identificador único (_id). Luego crea una variable global llamada señalDig dentro del proyecto, inicializada en 0, la cual servirá para guardar el valor leído de un pin. Después se define que el pin digital que se va a usar es el número 24 y se configura como una entrada digital, es decir, solo podrá leer señales externas (0 o 1). A continuación, se establece la lectura del pin con digitalRead: cada vez que el pin cambie de estado, el valor leído se guarda automáticamente en la variable global señalDig (0 si está en bajo o 1 si está en alto). Finalmente, mediante un intervalo de 100 milisegundos, se imprime en la consola el valor de esa variable, lo que permite monitorear en tiempo real el estado del pin 32 desde la aplicación.

Diagrama Flujo:

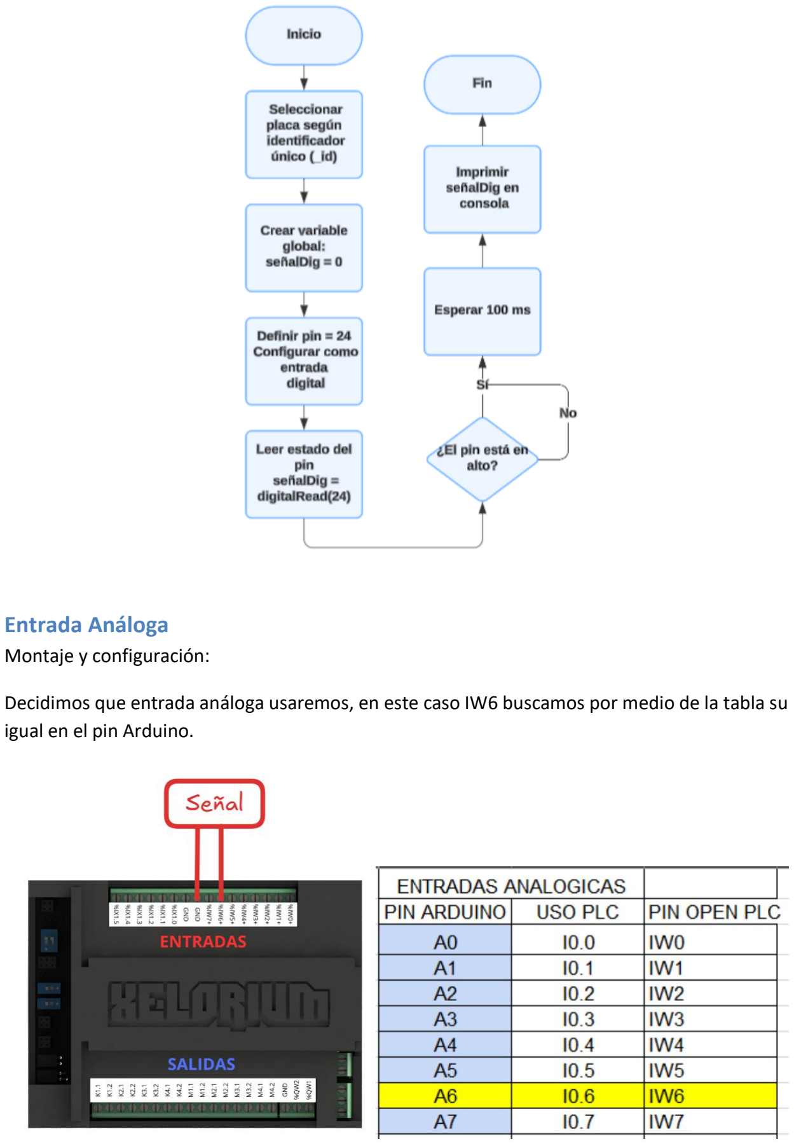
[picture p81: page 6]

### Entrada Análoga

Montaje y configuración:

Decidimos que entrada análoga usaremos, en este caso IW6 buscamos por medio de la tabla su igual en el pin Arduino.

Al tener su igual en el pin Arduino en este caso IW6 es A6, procedemos a configurarlo en nuestro código.

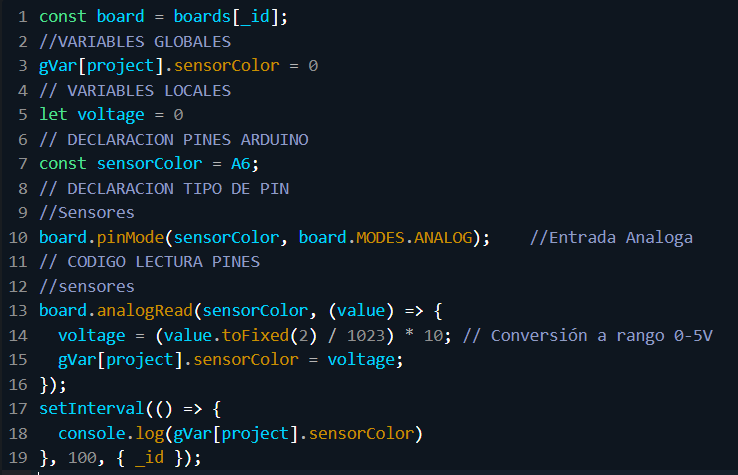
[picture p82: figure]

El código empieza seleccionando la placa correspondiente usando el identificador _id. Luego crea una variable global sensorColor inicializada en 0, que servirá para guardar la lectura de un sensor. También define una variable local llamada voltage, usada para almacenar temporalmente el valor convertido de la señal analógica. A continuación, se declara el pin analógico A6 como el que se va a usar y se configura como entrada analógica, lo que permite leer valores entre 0 y 1023 en lugar de solo 0 o 1. Después, mediante analogRead, cada vez que el pin recibe una lectura, ese valor se convierte a voltaje en un rango aproximado de 0 a 10 V con la fórmula (value.toFixed(2) / 1023) * 10, y el resultado se guarda en la variable global sensorColor. Finalmente, cada 100 ms se imprime en la consola el valor actualizado de esa variable, lo que permite visualizar en tiempo real el voltaje leído del sensor conectado al pin A6.

Diagrama de flujo:

### Salida PWM

Montaje y configuración:

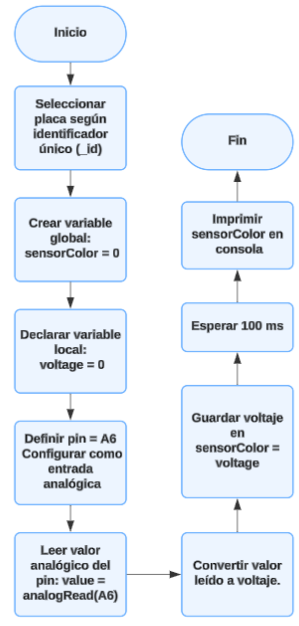
[picture p83: figure]

Decidimos que entrada de motores M usaremos, en este caso M1.1 y M1.2 buscamos por medio de la tabla su igual en el pin Arduino.

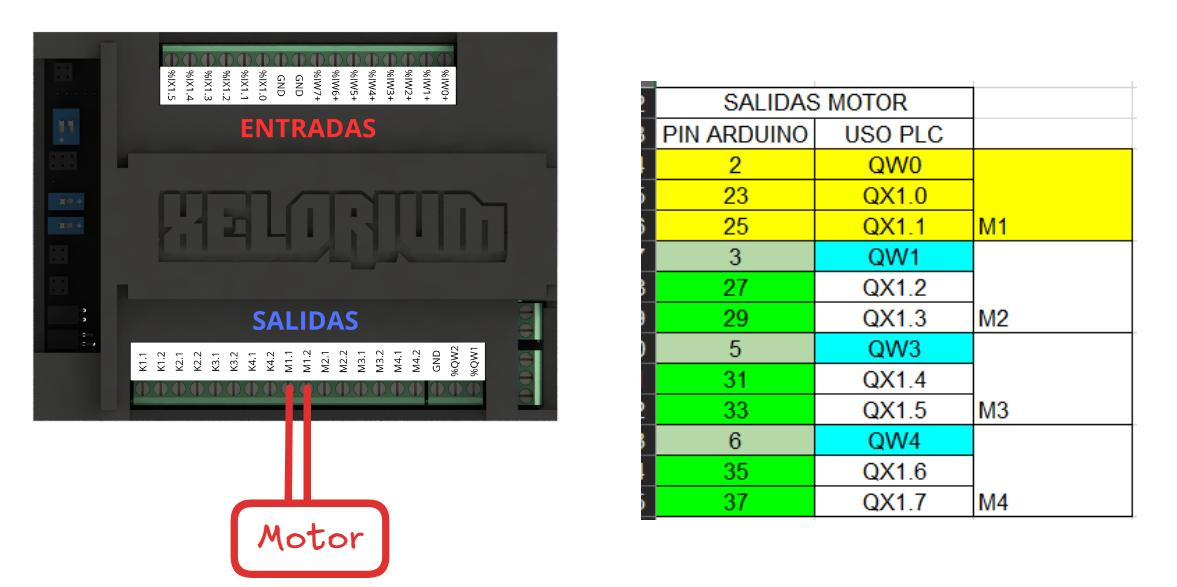
[picture p84: figure]

Al tener su igual en el pin Arduino en este caso M1.1 es 23, M1.2 es 25 y PWM es 2, procedemos a configurarlo en nuestro código.

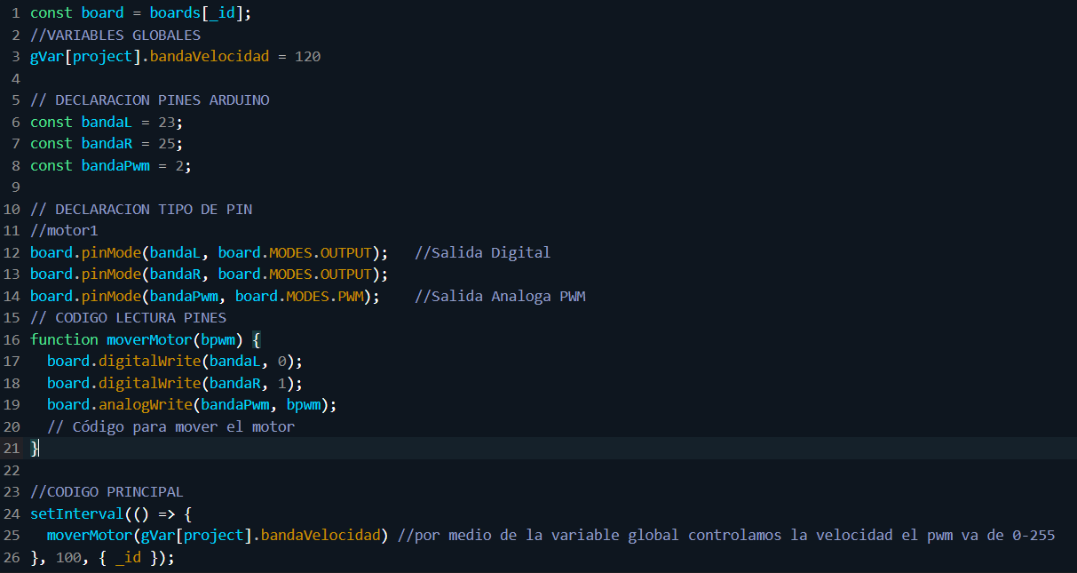
[picture p85: figure]

Resumen:

El código comienza seleccionando la placa Arduino y declarando una variable global llamada bandaVelocidad, inicializada en 120, que controlará la rapidez del motor. Luego se definen tres pines: bandaL (23) y bandaR (25) como salidas digitales para manejar la dirección del motor, y bandaPwm (2) como salida analógica PWM para regular la velocidad. Después se crea la función moverMotor(bpwm), que fija la dirección del motor poniendo bandaL en 0 y bandaR en 1, y al mismo tiempo aplica un valor PWM al pin bandaPwm, lo que determina cuán rápido gira el motor. Finalmente, en el bloque principal, cada 100 ms se llama a moverMotor usando el valor de gVar[project].bandaVelocidad, de manera que modificando esta variable global se puede controlar dinámicamente la velocidad del motor en un rango de 0 a 255.

Diagrama de flujo:

### Salida Análoga

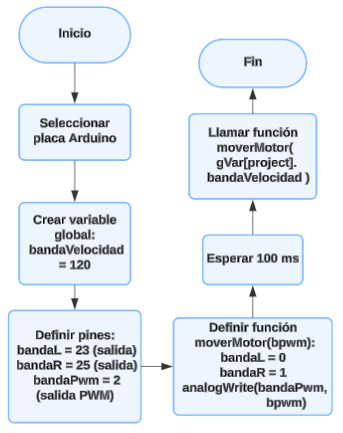
[picture p86: figure]

Montaje y configuración:

Decidimos que salida análoga usaremos, en este caso QW2 buscamos por medio de la tabla su igual en el pin Arduino.

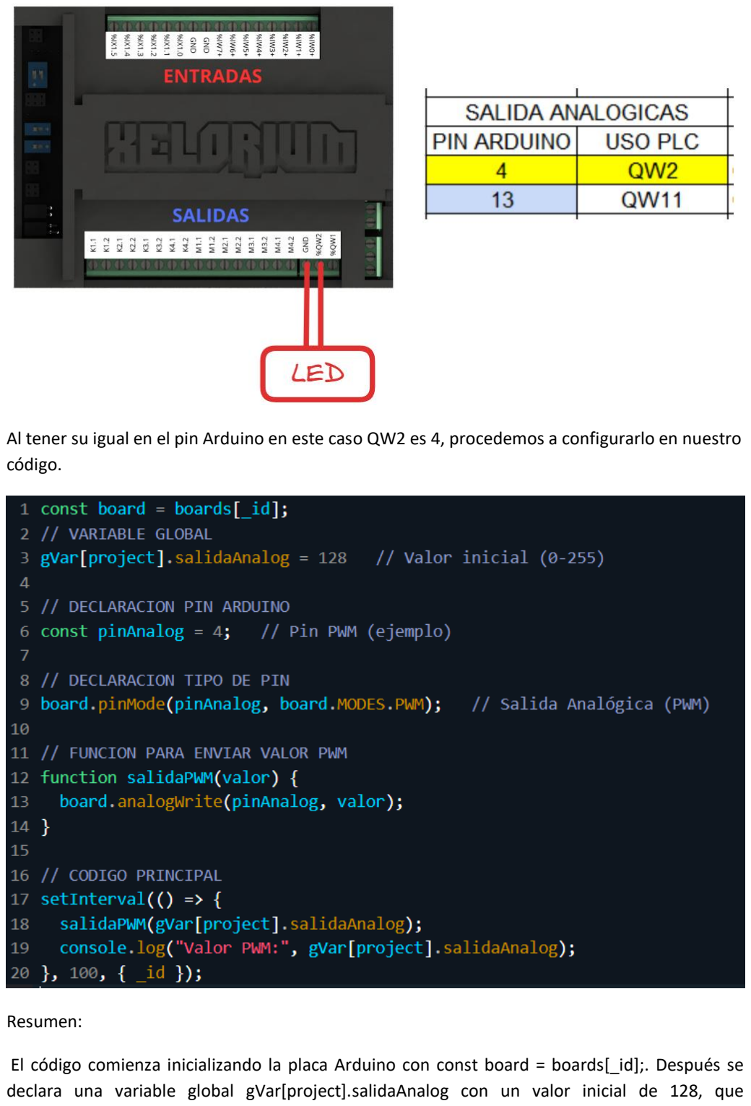
[picture p87: page 11]

Al tener su igual en el pin Arduino en este caso QW2 es 4, procedemos a configurarlo en nuestro código.

Resumen:

El código comienza inicializando la placa Arduino con const board = boards[_id];. Después se declara una variable global gVar[project].salidaAnalog con un valor inicial de 128, que corresponde a la intensidad de la señal PWM en un rango de 0 a 255. Luego se define el pin 4 como la salida analógica (PWM) mediante board.pinMode(pinAnalog, board.MODES.PWM);. A continuación, se crea la función salidaPWM(valor), que se encarga de enviar el valor de PWM al pin configurado. En la parte principal del programa, mediante un setInterval que se ejecuta cada 100 milisegundos, se llama a la función para escribir en el pin el valor guardado en la variable global y, además, se imprime en consola el valor actual de la salida. Con esto, el sistema permite controlar dinámicamente la intensidad de una salida analógica simulada en Arduino (PWM), por ejemplo, para regular la velocidad de un motor o la intensidad de un LED, simplemente modificando el valor de la variable global.

Diagrama de flujo:

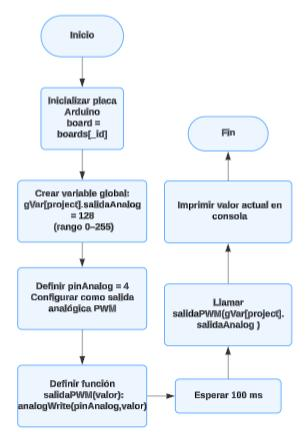
[picture p88: figure]

### Salida Digitales o Relé

Montaje y configuración:

Decidimos que salida digital o relé usaremos, en este caso K2.2 buscamos por medio de la tabla su igual en el pin Arduino.

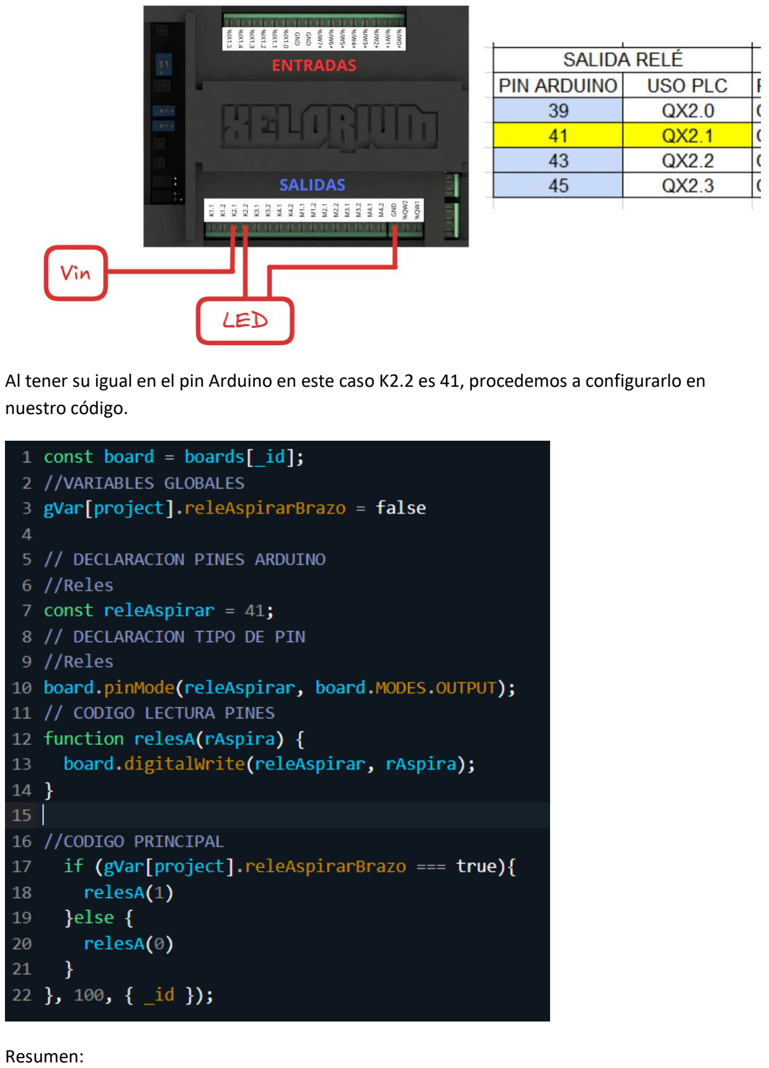
[picture p89: page 13]

Al tener su igual en el pin Arduino en este caso K2.2 es 41, procedemos a configurarlo en nuestro código.

Resumen:

El código empieza inicializando la placa Arduino con const board = boards[_id];. Después se declara una variable global gVar[project].releAspirarBrazo, inicialmente en false, que servirá para controlar el estado de un relé. Luego se define el pin 39 como salida digital mediante board.pinMode(releAspirar, board.MODES.OUTPUT);. A continuación, se crea la función relesA(rAspira), que recibe un valor (0 o 1) y lo envía al pin configurado, activando o desactivando el relé. En la parte principal del código se comprueba el valor de la variable global: si está en true, la función activa el relé (relesA(1)), y si está en false, lo desactiva (relesA(0)). Finalmente, el bloque se ejecuta cada 100 ms gracias al setInterval, permitiendo controlar de forma continua el encendido o apagado del relé en función de la variable global.

Diagrama de flujo:

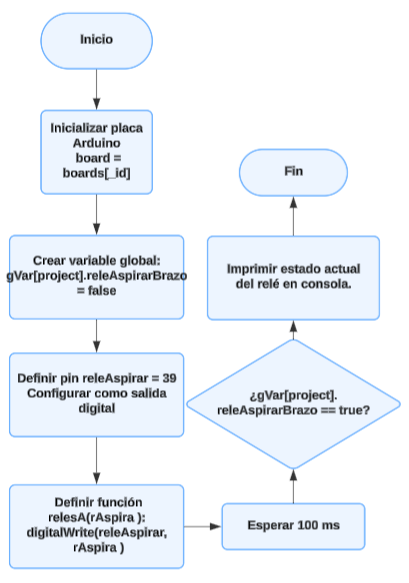
[picture p90: figure]
