nxvxr14/control-celda-fts-mecatronica-UNAB/Manuales/MANUAL_ENSAMBLAJE_BANDA_CASTRO_DELGADO.pdf

# Manual de Ensamblaje de la Banda Transportadora con Fischertechnik

Trabajo de Tesis – Ingeniería Mecatrónica

Autores: Neil Sebastian Castro Caicedo – Hubert Armando Delgado Maestre

### 1. Introducción

Este manual describe el proceso de ensamblaje paso a paso de la banda transportadora realizado con el sistema modular Fischertechnik. El objetivo de este documento es servir como guía clara y detallada para replicar el prototipo como parte del proyecto de tesis.

### 2. Lista de materiales

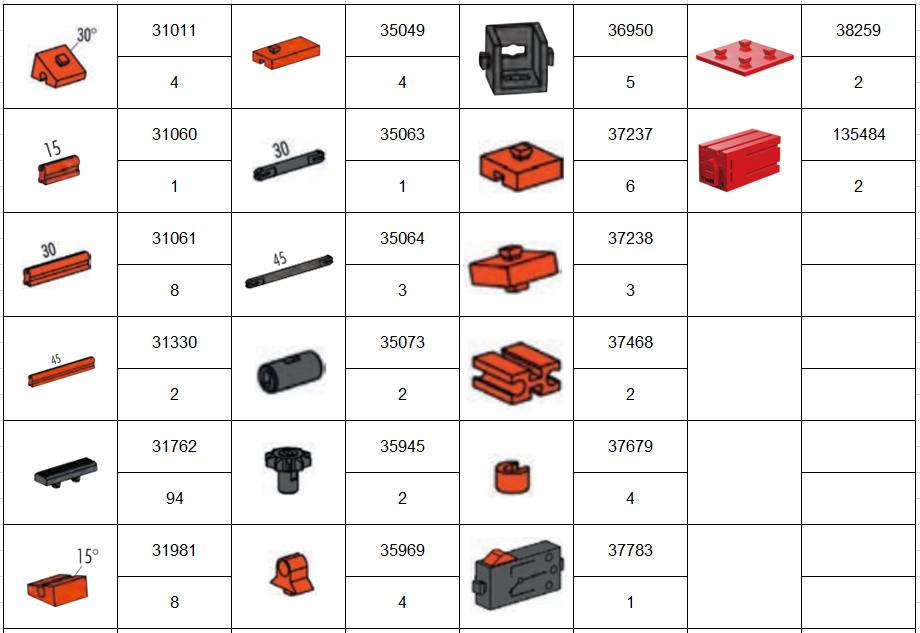
[picture p91: figure]

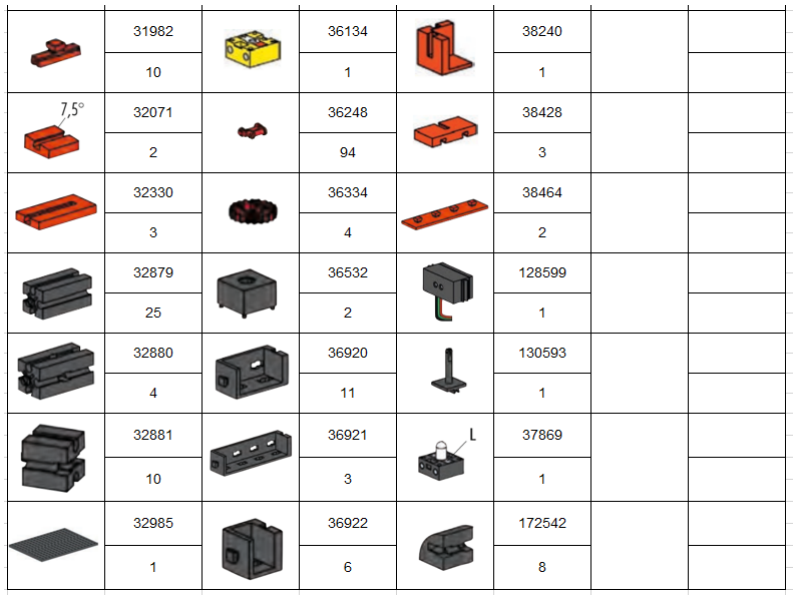
[picture p92: figure]

### 3. Proceso de ensamblaje

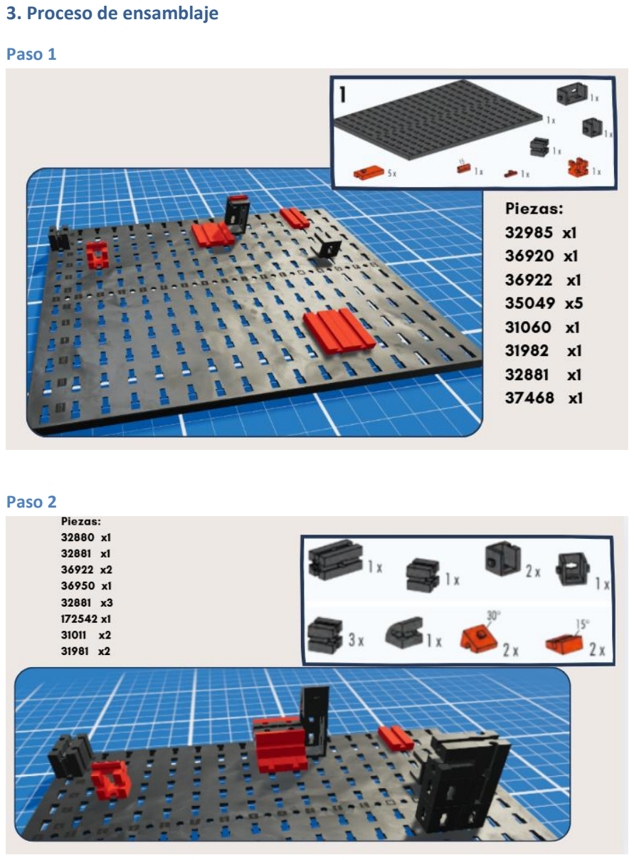
[picture p93: page 4]

### Paso 1

### Paso 2

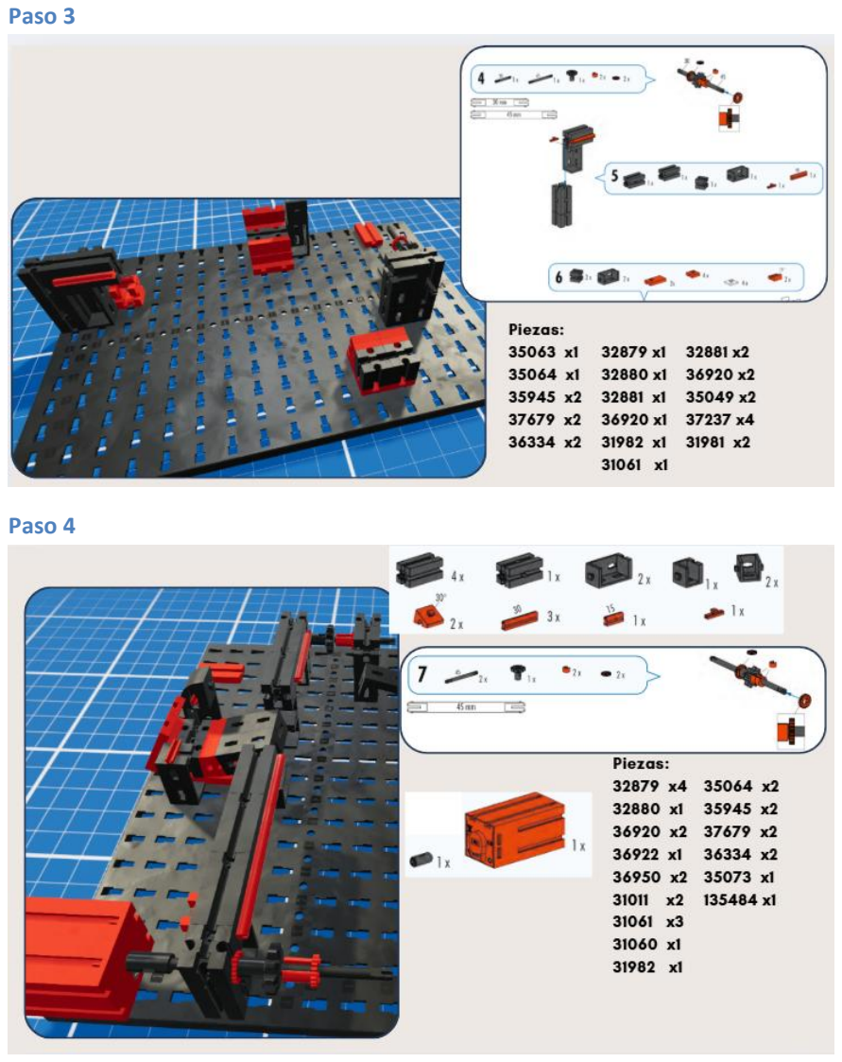
[picture p94: page 5]

### Paso 3

### Paso 4

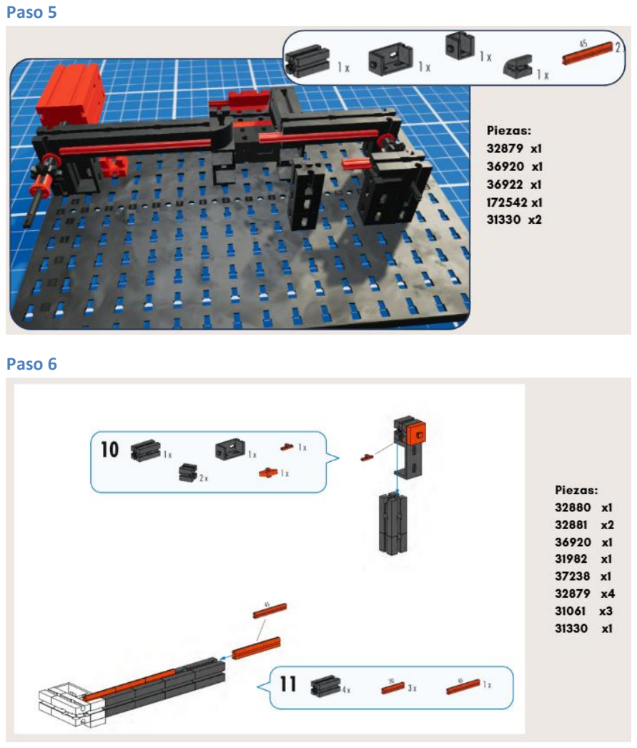
[picture p95: page 6]

### Paso 5

### Paso 6

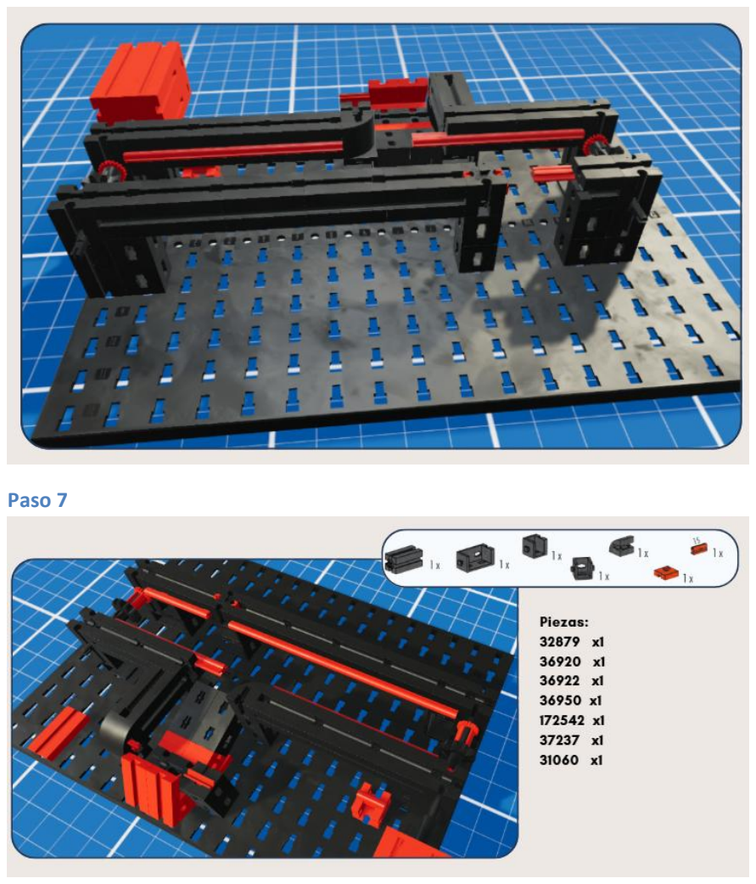
[picture p96: page 7]

### Paso 7

### Paso 8

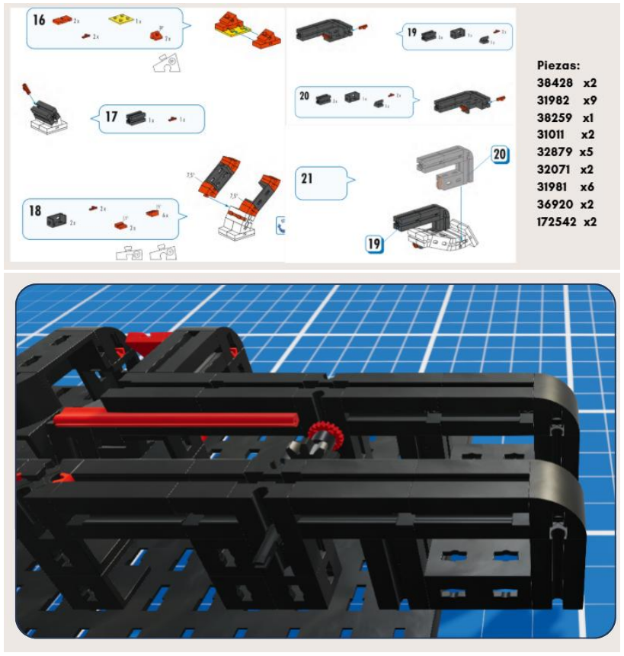
[picture p97: figure]

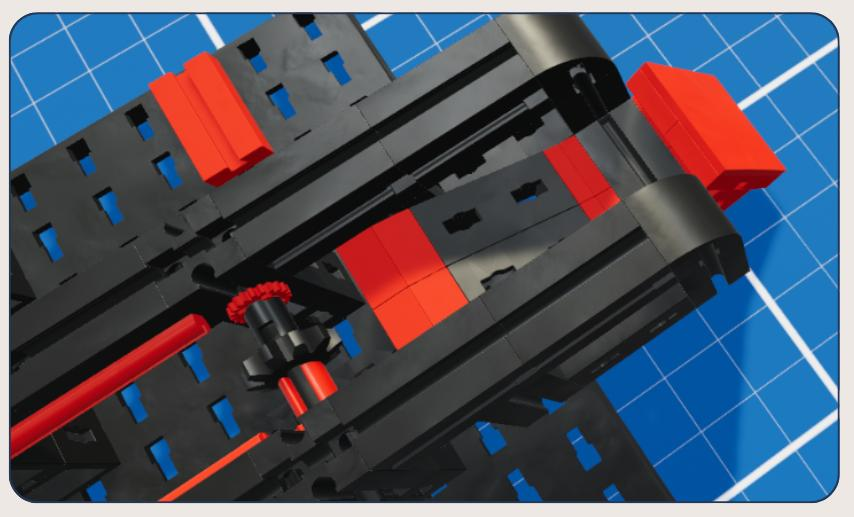
[picture p98: figure]

### Paso 9

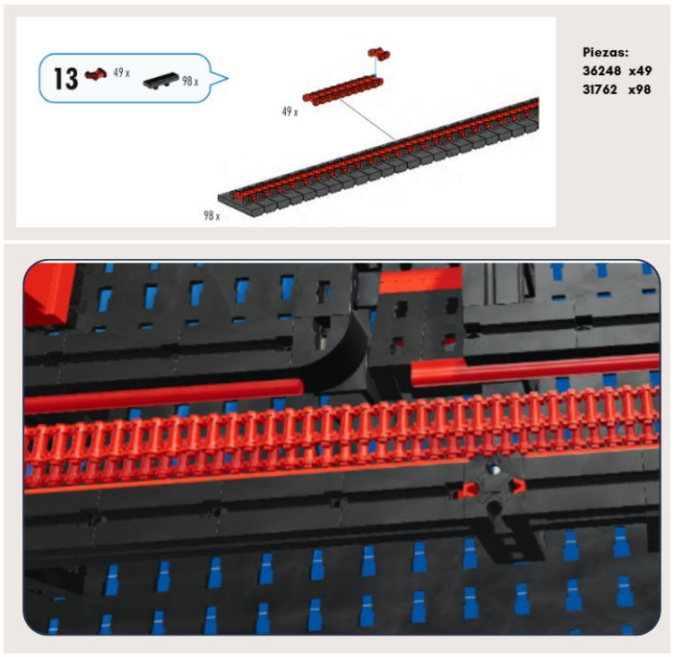
[picture p99: figure]
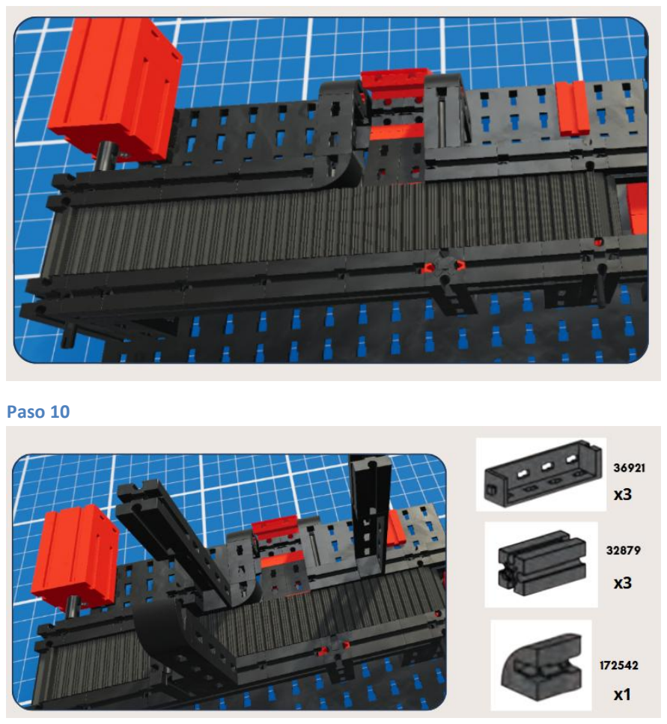
[picture p100: page 11]

### Paso 10

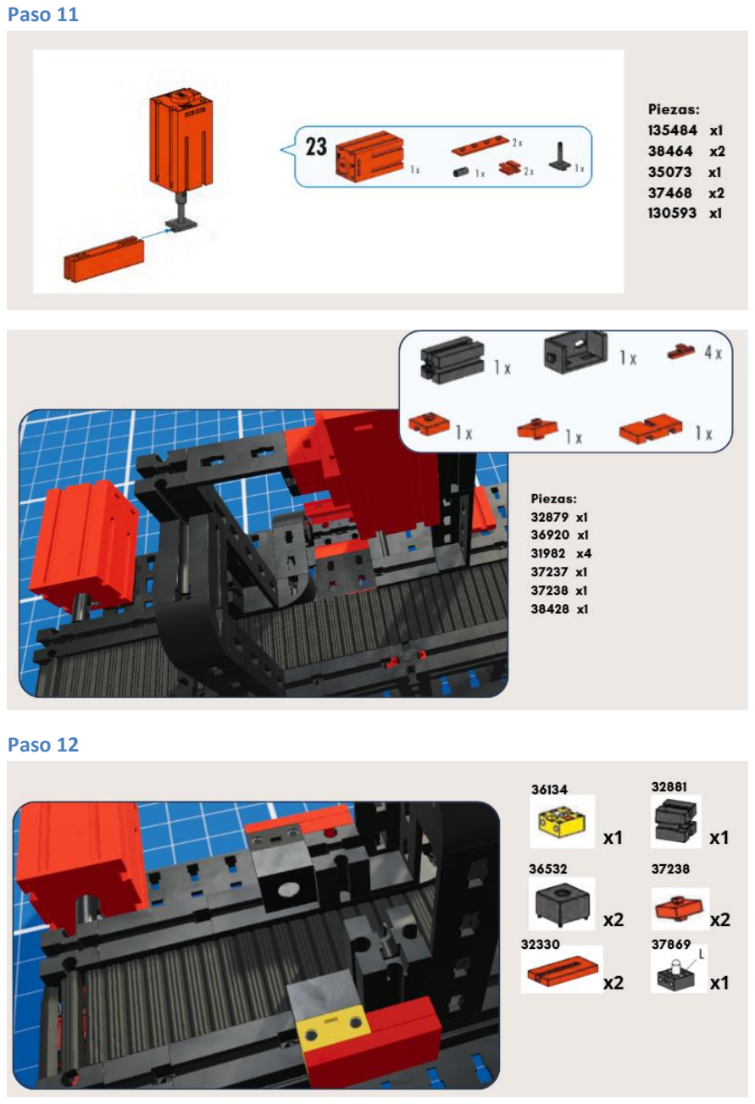
[picture p101: page 12]

### Paso 11

### Paso 12

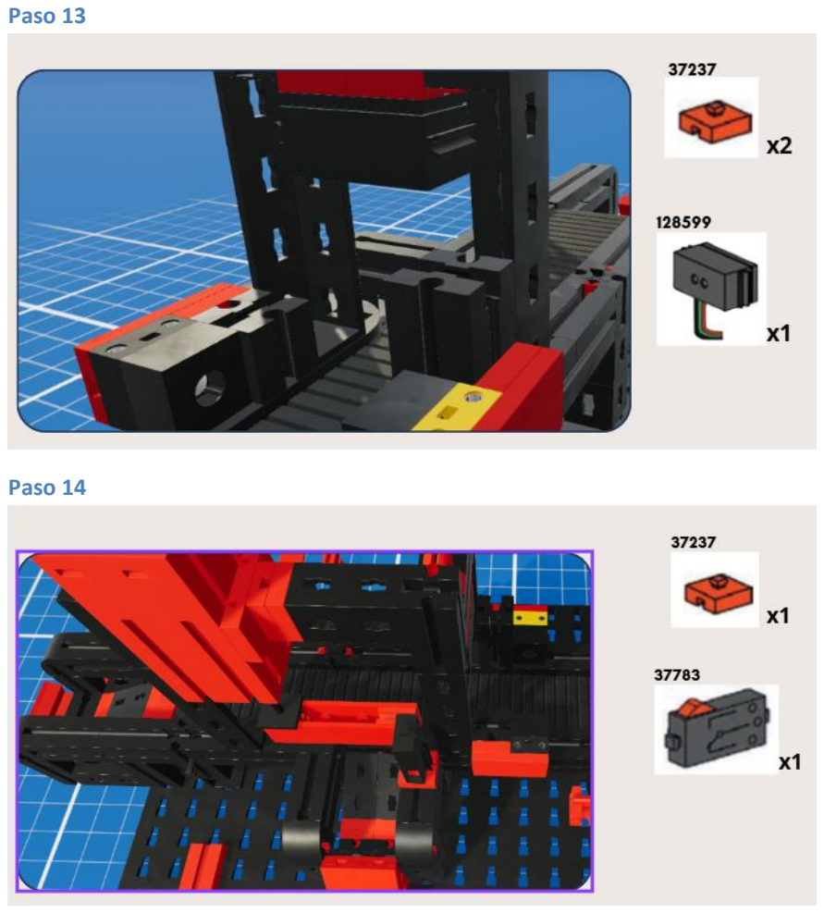
[picture p102: page 13]

### Paso 13

### Paso 14

### FINALIZADO

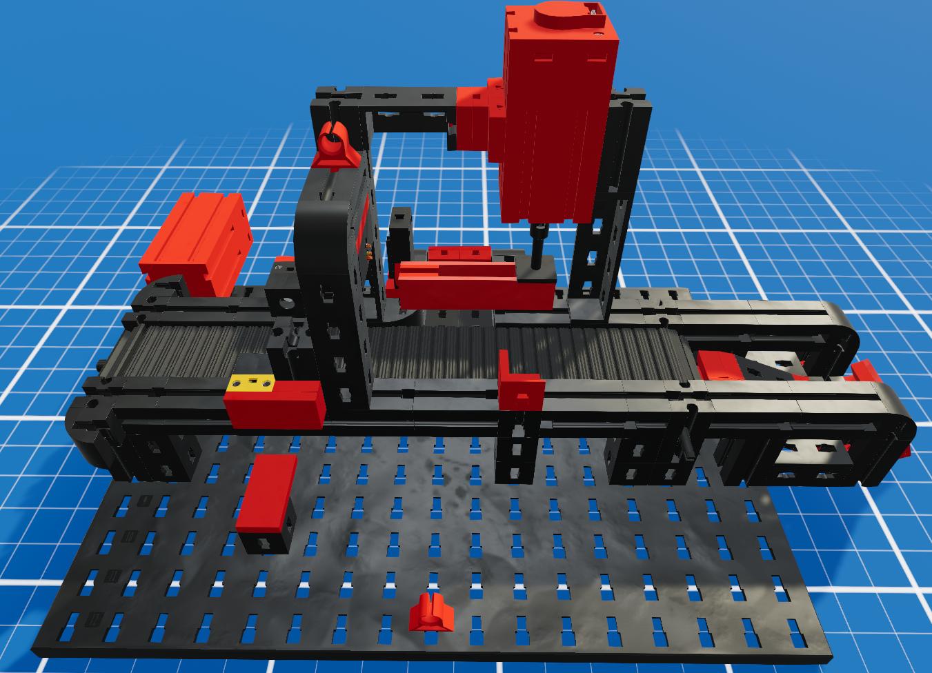
[picture p103: figure]
