nxvxr14/control-celda-fts-mecatronica-UNAB/Manuales/MANUAL_ENSAMBLAJE_BRAZO_CASTRO_DELGADO.pdf

# Manual de Ensamblaje del Brazo Neumático con Fischertechnik

Trabajo de Tesis – Ingeniería Mecatrónica

Autores: Neil Sebastian Castro Caicedo – Hubert Armando Delgado Maestre

### 1. Introducción

Este manual describe el proceso de ensamblaje paso a paso del brazo neumático realizado con el sistema modular Fischertechnik. El objetivo de este documento es servir como guía clara y detallada para replicar el prototipo como parte del proyecto de tesis.

### 2. Lista de materiales

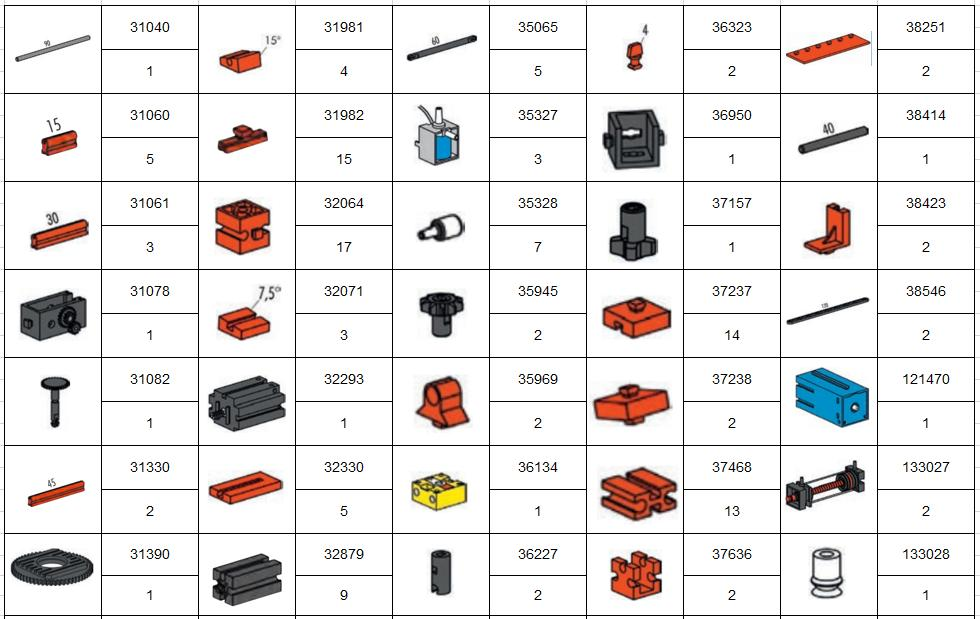
[picture p104: figure]
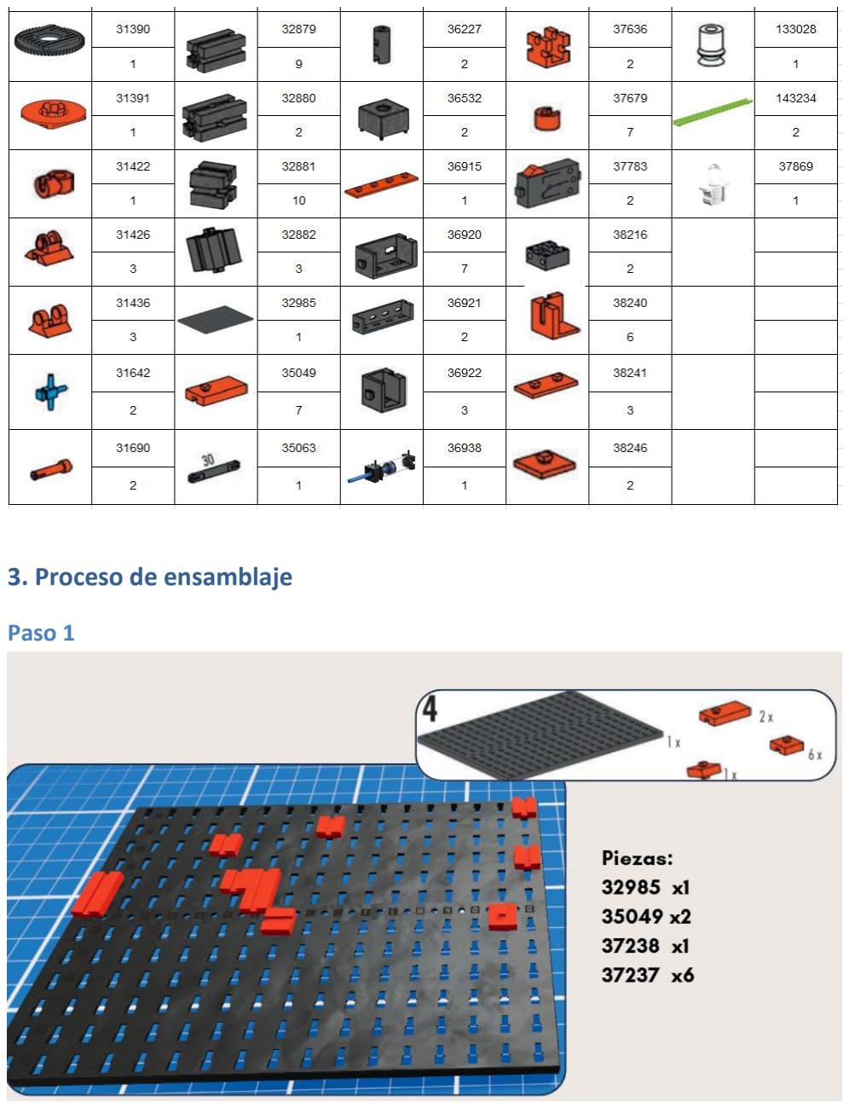
[picture p105: page 3]

### 3. Proceso de ensamblaje

### Paso 1

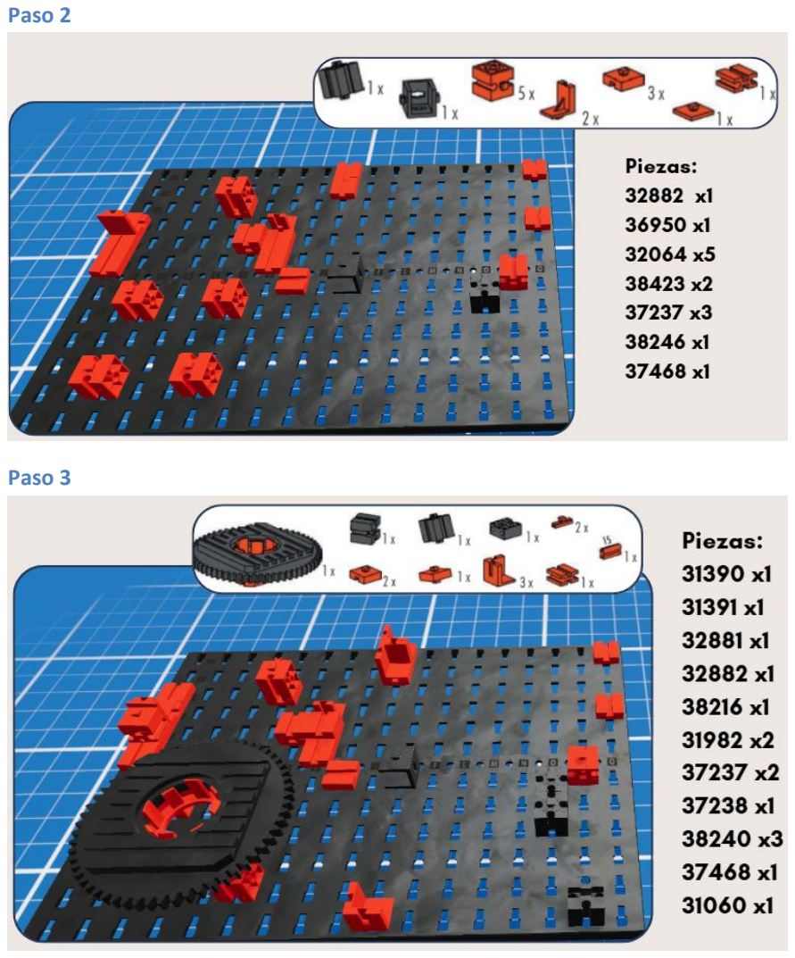
[picture p106: page 4]

### Paso 2

### Paso 3

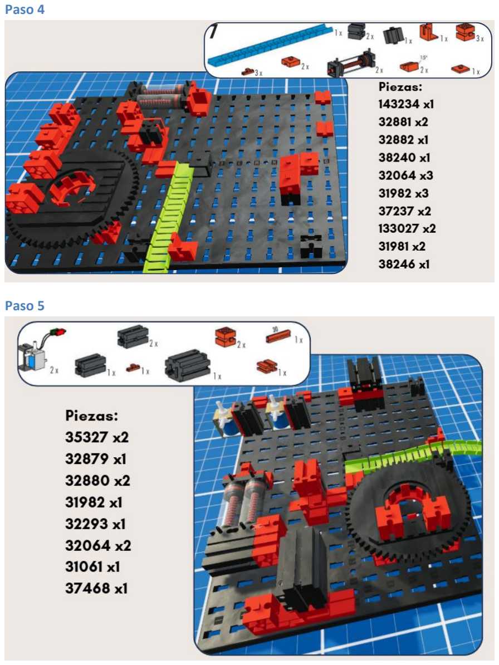
[picture p107: page 5]

### Paso 4

### Paso 5

### Paso 6

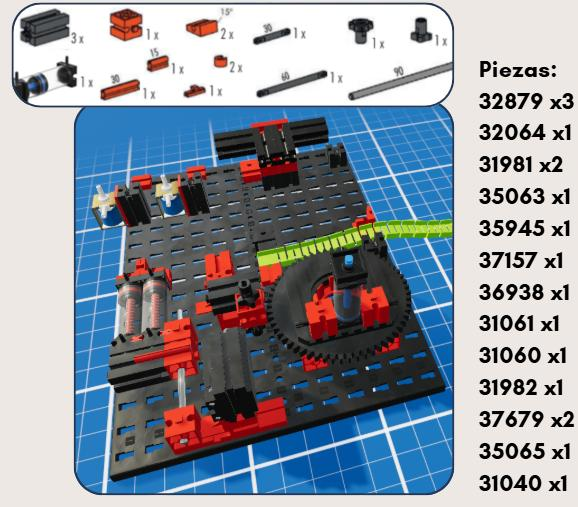
[picture p108: figure]
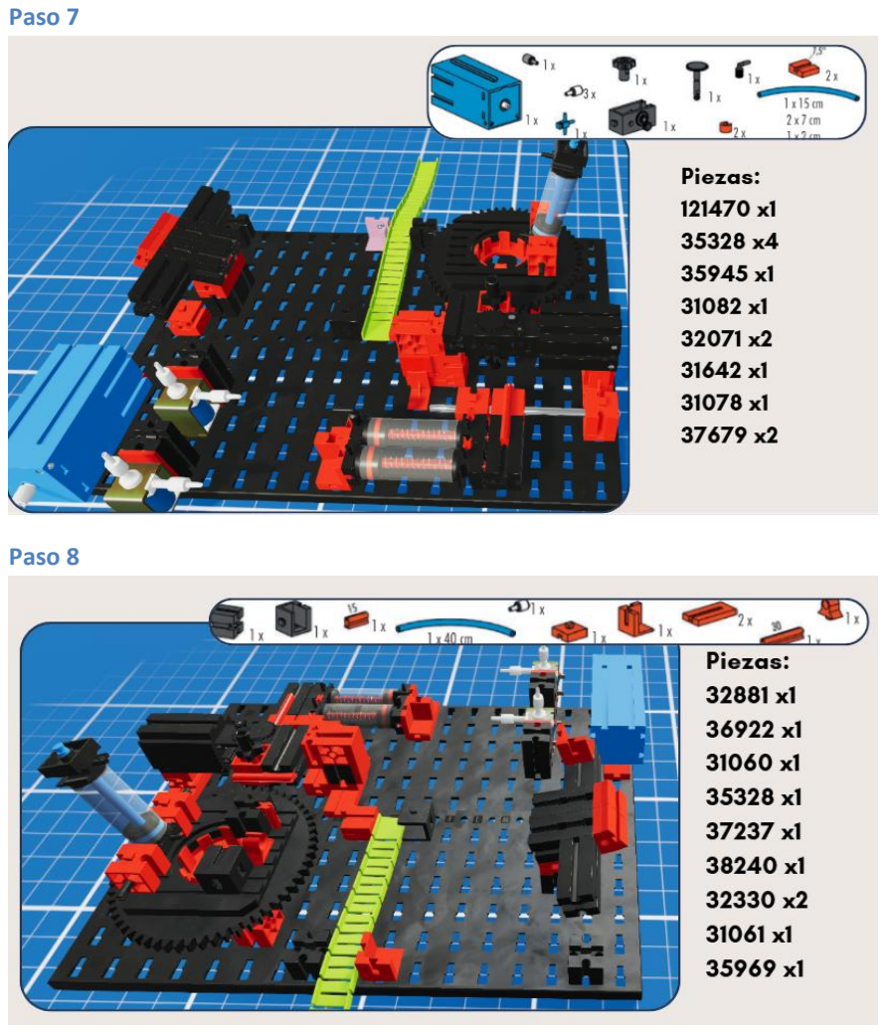
[picture p109: page 7]

### Paso 7

### Paso 8

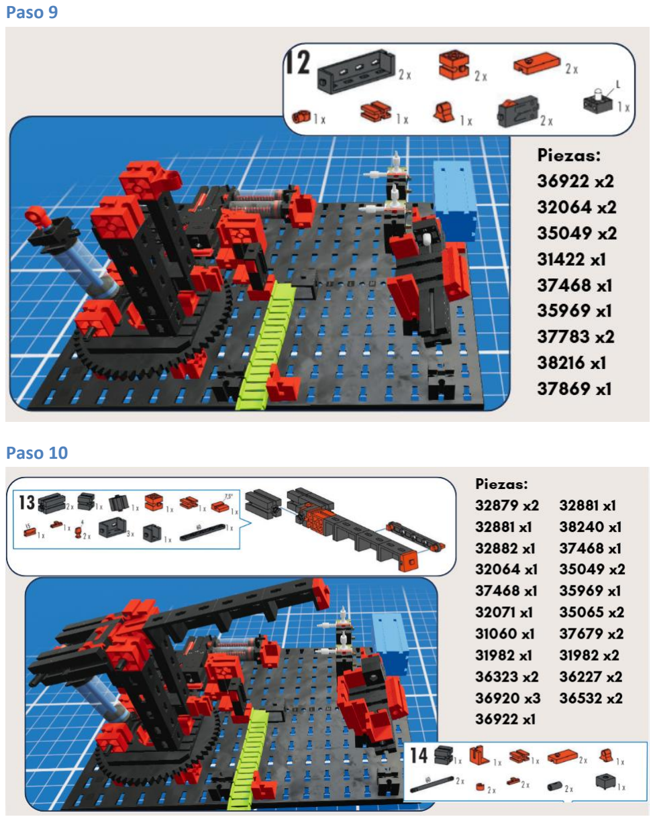
[picture p110: page 8]

### Paso 9

### Paso 10

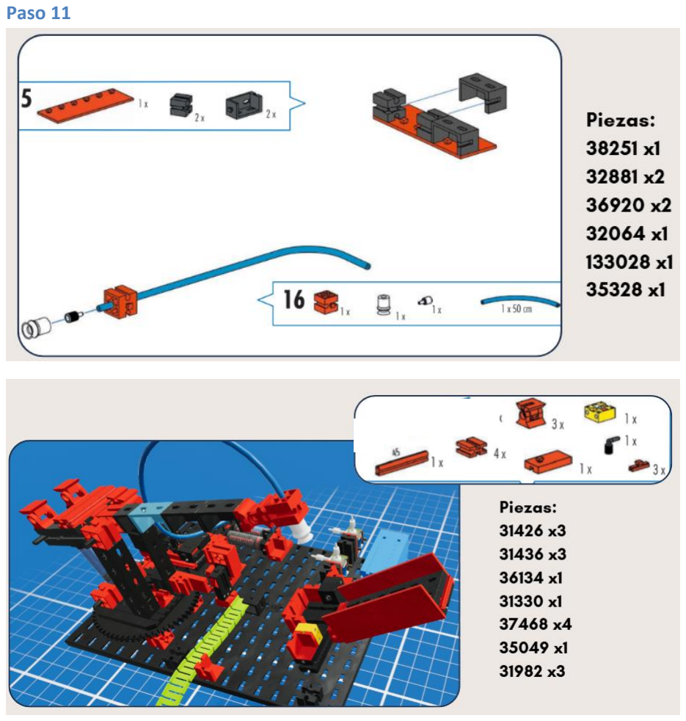
[picture p111: page 9]

### Paso 11

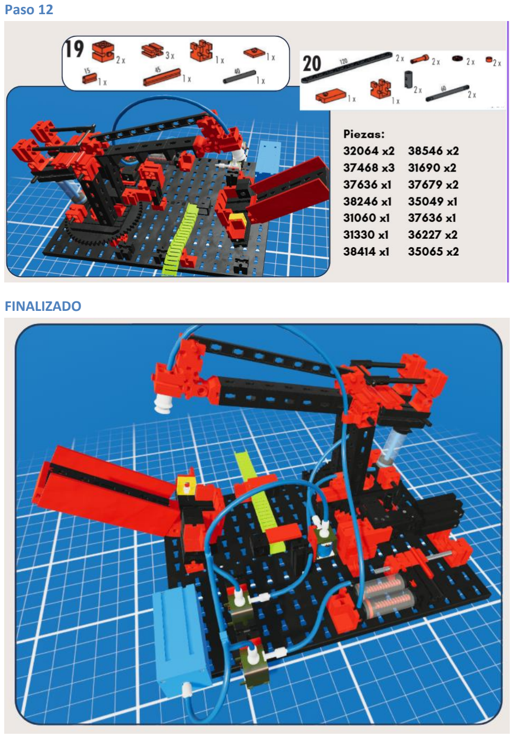
[picture p112: page 10]

### Paso 12

### FINALIZADO
