nxvxr14/control-celda-fts-mecatronica-UNAB/Manuales/MANUAL_PLATAFORMA_CASTRO_DELGADO.pdf

# Manual de uso de la plataforma

Trabajo de Tesis – Ingeniería Mecatrónica

Autores: Neil Sebastian Castro Caicedo – Hubert Armando Delgado Maestre

### 1. Introducción

La plataforma Ilyzaele ha sido desarrollada con el propósito de ofrecer un entorno integral para la programación y gestión de la celda mecatrónica Fischertechnik, en el marco de nuestro proyecto de grado. Esta herramienta, basada en el concepto de IoT (Internet of Things), permite al usuario interactuar de manera sencilla e intuitiva con el controlador Xelorium, facilitando el desarrollo y ejecución de programas de automatización. En este manual se presentará una explicación detallada de cada sección de la plataforma, describiendo sus menús, funciones y utilidades, con el fin de guiar al lector en el uso práctico de sus herramientas para el control y supervisión de la celda mecatrónica.

2. Interfaz plataforma.
Interfaz General.

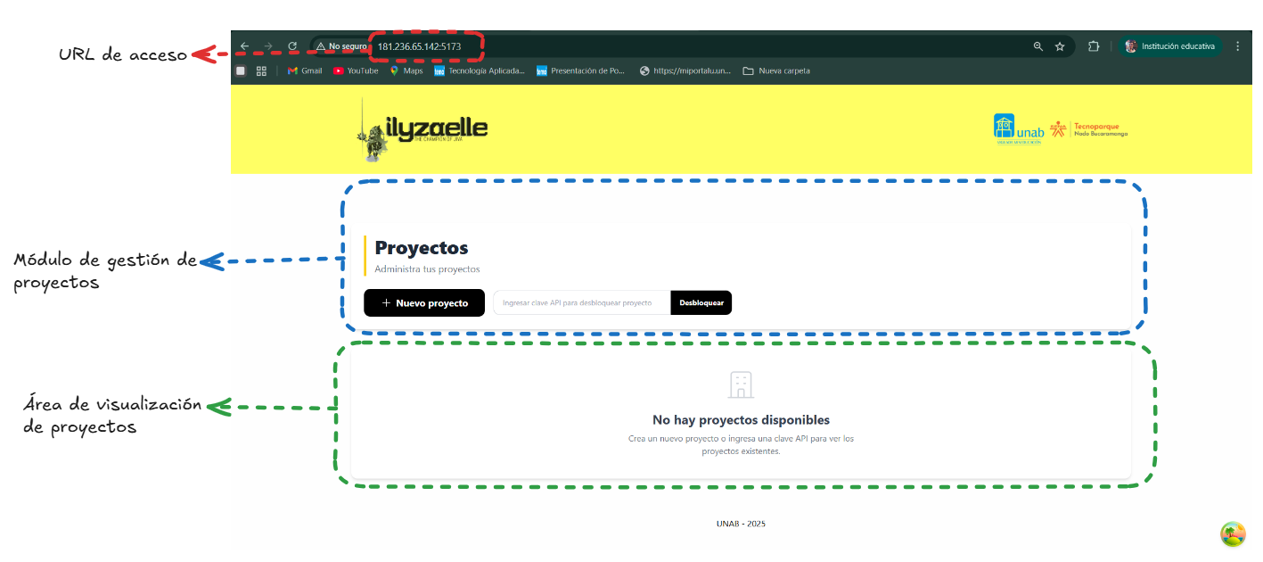
[picture p113: figure]

Selecciona + Nuevo Proyecto. Se abrirá un menú donde crearás un proyecto para trabajar. En este menú, deberás completar los siguientes campos:

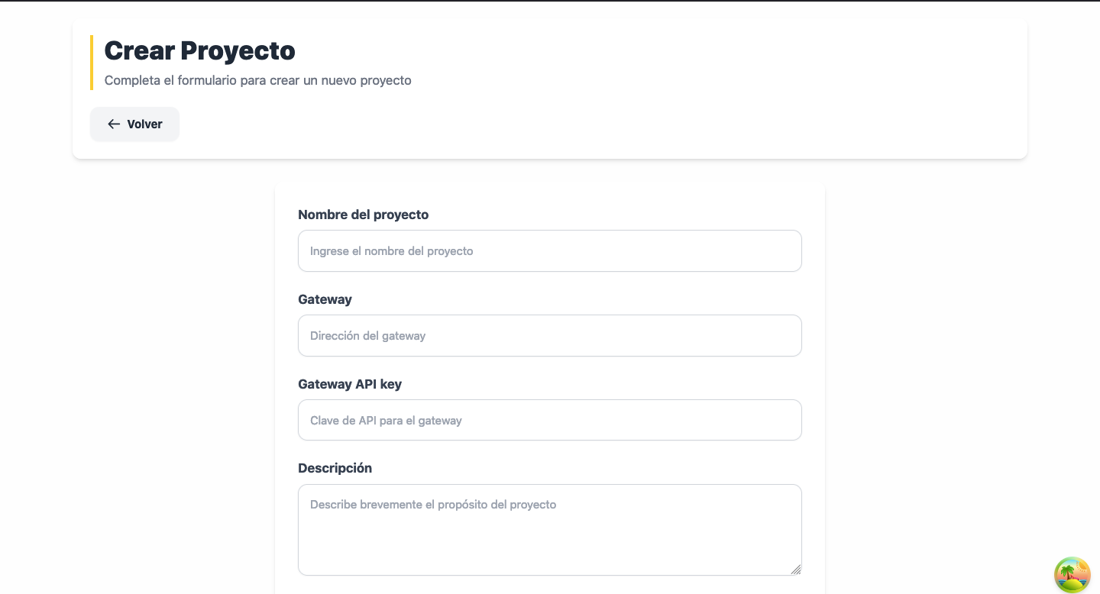
[picture p114: figure]

- Nombre del proyecto: Puedes poner el nombre que desees.
- Descripción: También es a elección del usuario.
- Gateway: Este dato lo obtendrás del Ilyzaelle Gateway Manager, en la opción 2.
- Gateway API: También se obtiene en la opción 2 del Ilyzaelle Gateway Manager.

Al crear un proyecto lo encontraremos en el apartado área de visualización de proyectos, donde tendrá su respectivo, nombre del proyecto, Gateway, API y Descripción.

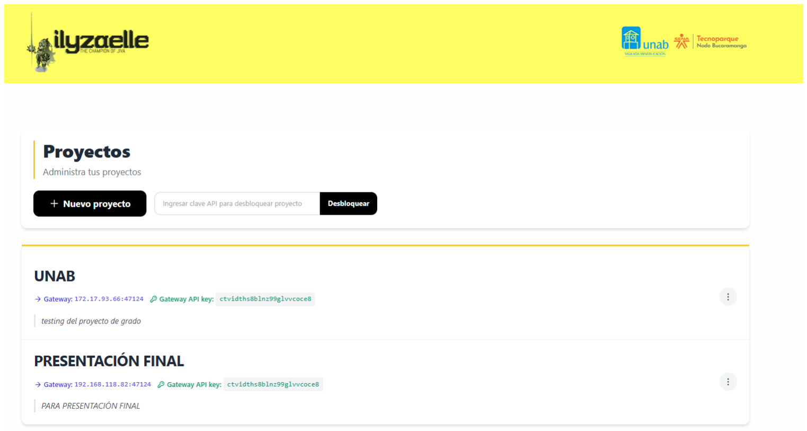
[picture p115: figure]

A su vez estos proyectos presentan un menú, el cual nos permite diferentes acciones con respecto a cada proyecto.

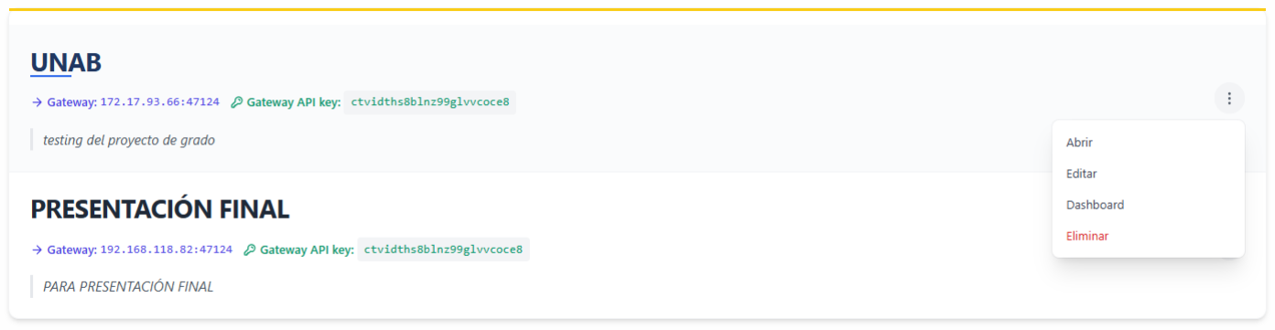
[picture p116: figure]

Entre las opciones disponibles para cada proyecto se encuentran:

- Abrir: permite ingresar al proyecto seleccionado.
- Editar: retorna al menú de creación para modificar la configuración o realizar ajustes en el proyecto.
- Dashboard: dirige directamente a uno de los menús principales dentro del proyecto, donde se visualizan las herramientas de gestión.
- Eliminar: borra de forma permanente el proyecto seleccionado.

Al entrar en un proyecto, entraremos en la interfaz del proyecto:

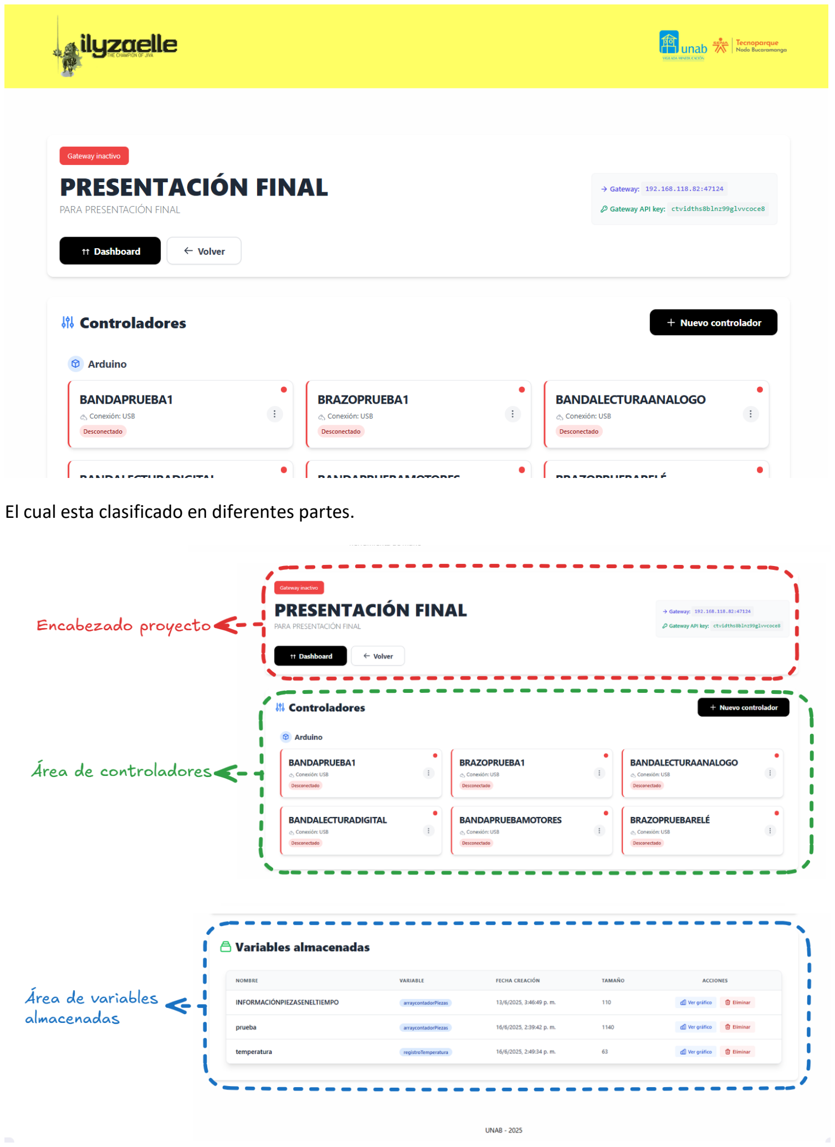
[picture p117: page 5]

El cual esta clasificado en diferentes partes.

En el Encabezado del proyecto se muestra la información correspondiente al proyecto creado. Además, incluye un indicador Gateway, el cual señala si el proyecto se encuentra activo o desactivado. También dispone de dos botones principales: Devolver, que permite regresar a la interfaz principal, y Dashboard, que redirige a otra interfaz con herramientas adicionales.

Al darle clic en el Dashboard ingresamos a la interfaz de Dashboard, además de visualizar las variables globales que ya han sido creadas, también podemos crear una nueva variable global utilizando el botón + Nueva variable. Una vez creada, esta variable puede ser utilizada desde cualquier controlador.

Además, contamos con el botón Limpiar dashboard, que nos permite eliminar las representaciones gráficas creadas previamente, facilitando así la organización y visualización de los elementos activos.

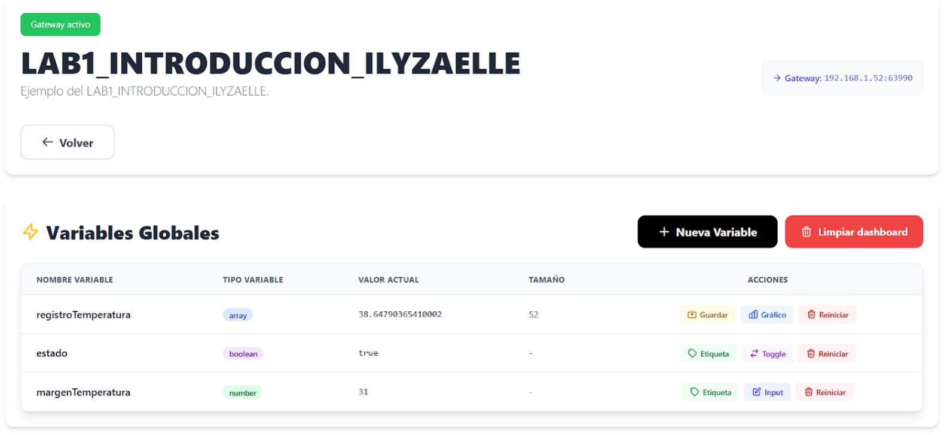
[picture p118: figure]

Por otro lado el dashboard también permite ver gráficamente las variables esto con un apartado de HMI, donde podremos agregar elementos para ver las variables globales.

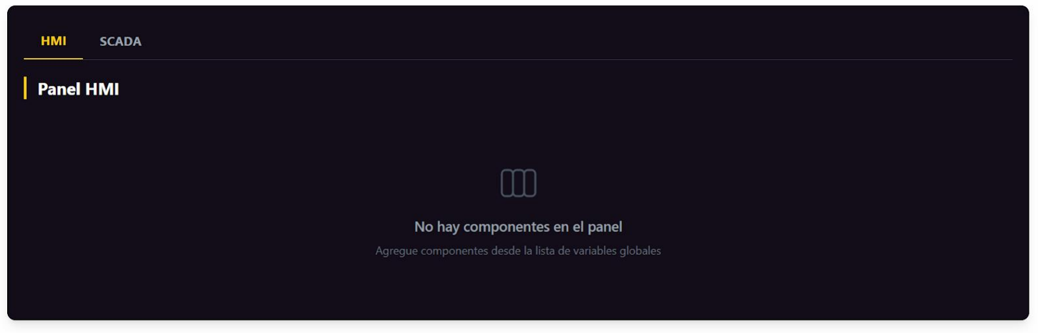
[picture p119: figure]
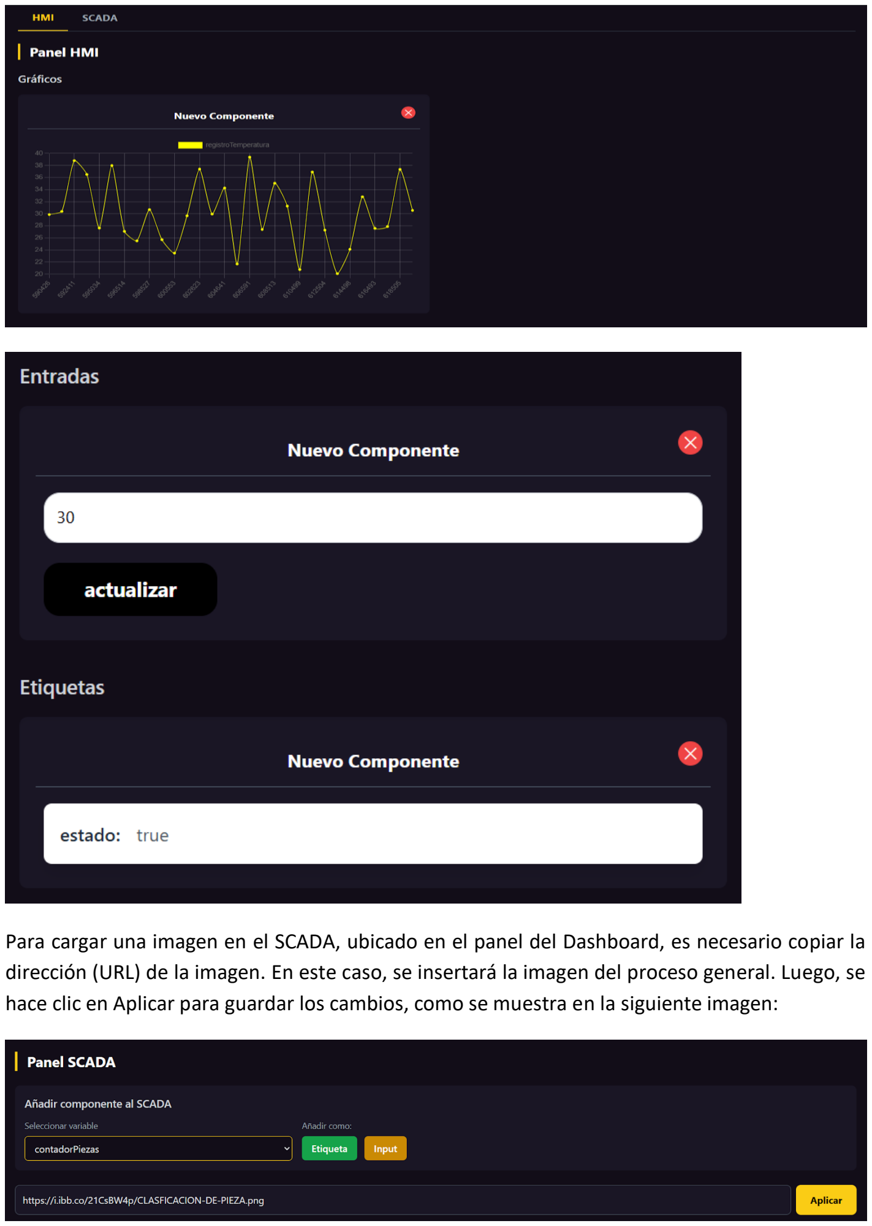
[picture p120: page 7]

Para cargar una imagen en el SCADA, ubicado en el panel del Dashboard, es necesario copiar la dirección (URL) de la imagen. En este caso, se insertará la imagen del proceso general. Luego, se hace clic en Aplicar para guardar los cambios, como se muestra en la siguiente imagen:

Para configurar la visualización en el sistema SCADA, nos dirigimos al panel ubicado en el Dashboard. Allí seleccionamos las variables que deseamos mostrar; en este caso, se eligió la variable rtReleAspirar, la cual indica el estado del relé encargado del sistema de aspiración.

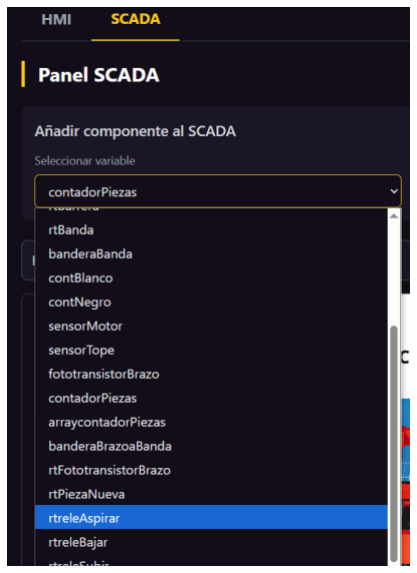
[picture p121: figure]

Dependiendo del tipo de variable seleccionada, aparecerán diferentes opciones para añadirla al SCADA. En este caso, utilizaremos la opción "Añadir como Toggle", que permite ver si esta activa
o | desactiva | una | variable.

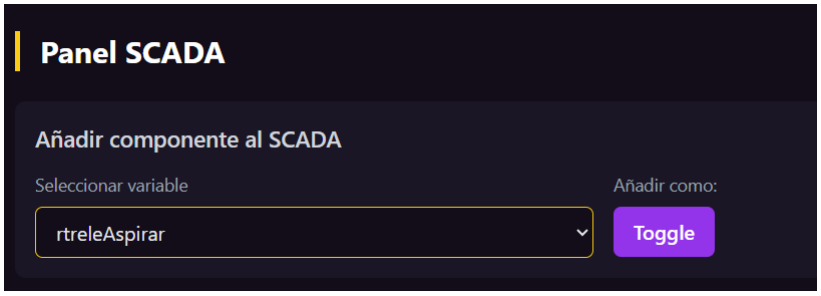
[picture p122: figure]

Al añadirlo como Toggle, este aparecerá en el panel del SCADA, donde podremos ajustar su tamaño, moverlo libremente o eliminarlo según sea necesario para organizar la interfaz de manera clara y funcional.

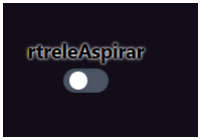
[picture p123: figure]

El Área de controlador cuenta con un botón para añadir el controlador que se desea utilizar, junto con una interfaz donde se listan los diferentes controladores creados.

Al dar clic en +nuevo controlador, tendremos un menú para crear el controlador que deseamos.

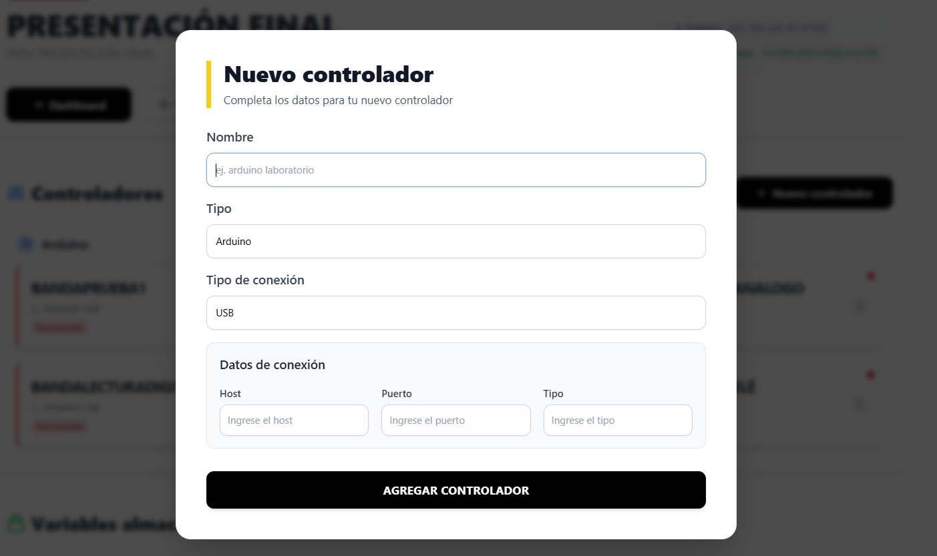
[picture p124: figure]

Así mismo, en este apartado se podrán definir aspectos clave como el nombre, el tipo de controlador, el tipo de conexión y los datos de conexión. Esta información depende directamente del controlador seleccionado y del método de conexión que se utilice.

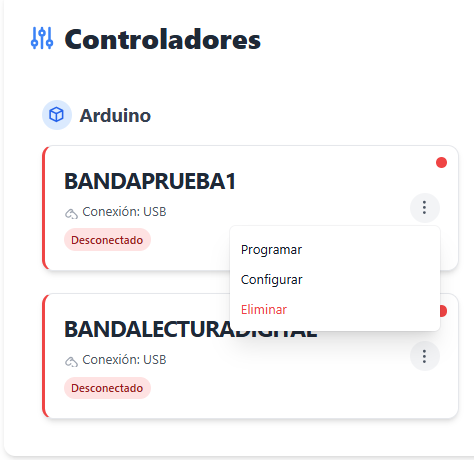
[picture p125: figure]

También es importante tener en cuenta que, al crear un controlador y acceder a su menú, se presentan diferentes acciones disponibles:

- Programar: redirige a una interfaz específica donde es posible comenzar a programar el controlador.
- Configurar: permite editar la información definida durante la creación del controlador, en caso de requerir ajustes o cambios.
- Eliminar: borra el controlador del área correspondiente. Es importante señalar que, al eliminarlo, se pierde de forma permanente el código que contiene.

Al dar clic en Programar entraremos a la interfaz de programación del controlador:

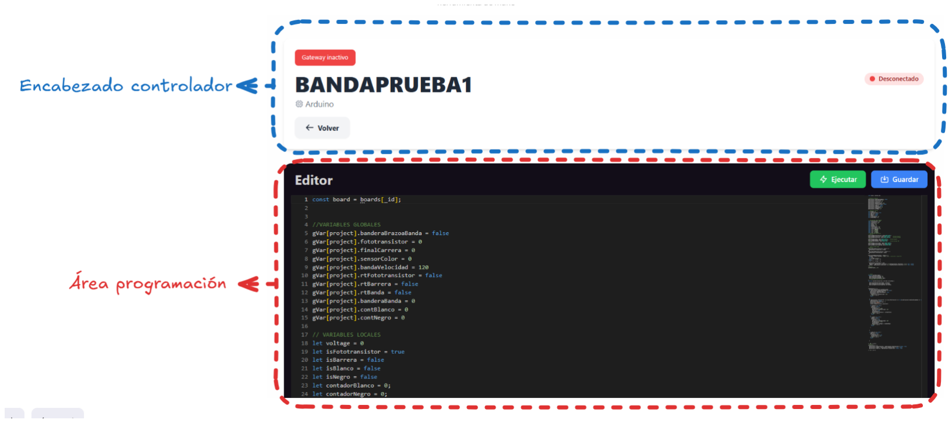
[picture p126: figure]

La interfaz de programación está dividida en dos apartados principales:

- Encabezado: en esta sección se muestra nuevamente el indicador Gateway, la información del controlador, un botón Volver que permite regresar a la interfaz del proyecto, y un indicador de estado que señala si el controlador está activado.
- Área de programación: corresponde al editor de código, el cual funciona con el lenguaje JavaScript. Incluye además los botones Ejecutar y Guardar, que permiten cargar el código programado en el controlador y almacenarlo para su posterior uso.

El Área de variables almacenadas presenta las distintas variables guardadas dentro del proyecto, mostrando su información relevante y los gráficos asociados para su análisis.

Por último, en esta área es posible exportar los datos almacenados para utilizarlos en diferentes aplicaciones. Al hacer clic en la opción Ver gráfico, se accede a un menú con diversas funciones, que incluyen tanto opciones de visualización de la información como herramientas para exportar los datos de manera sencilla y práctica.

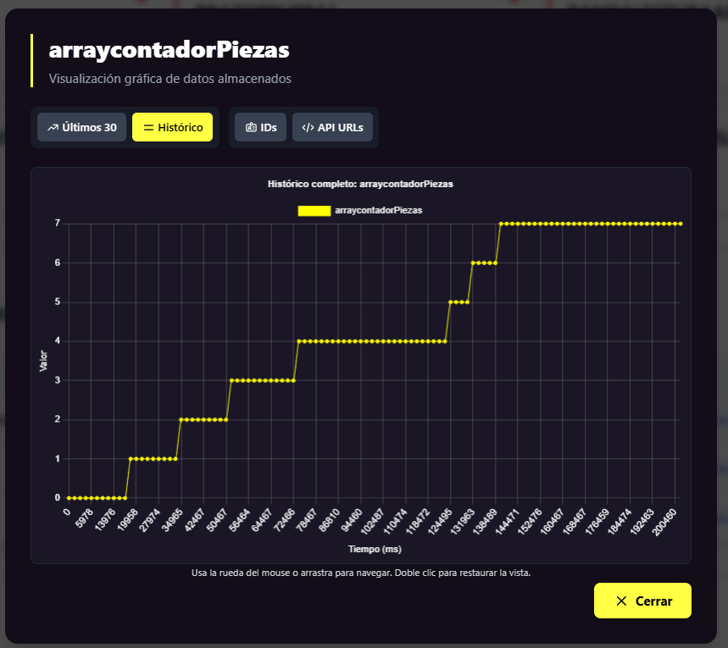
[picture p127: figure]

En cuanto a la visualización de datos, la plataforma ofrece dos modos principales:

- Últimos 30: muestra únicamente los últimos 30 registros almacenados.
- Histórico: permite acceder a la totalidad de los datos guardados.

Respecto a la opción de exportar, se dispone de diferentes alternativas como API URLs e IDs, cuya selección dependerá de la comodidad y necesidades del usuario.
