nxvxr14/control-celda-fts-mecatronica-UNAB/Electronica/Esquematicos finales PDF/schematicPowerSourcePLC_V0.1.pdf

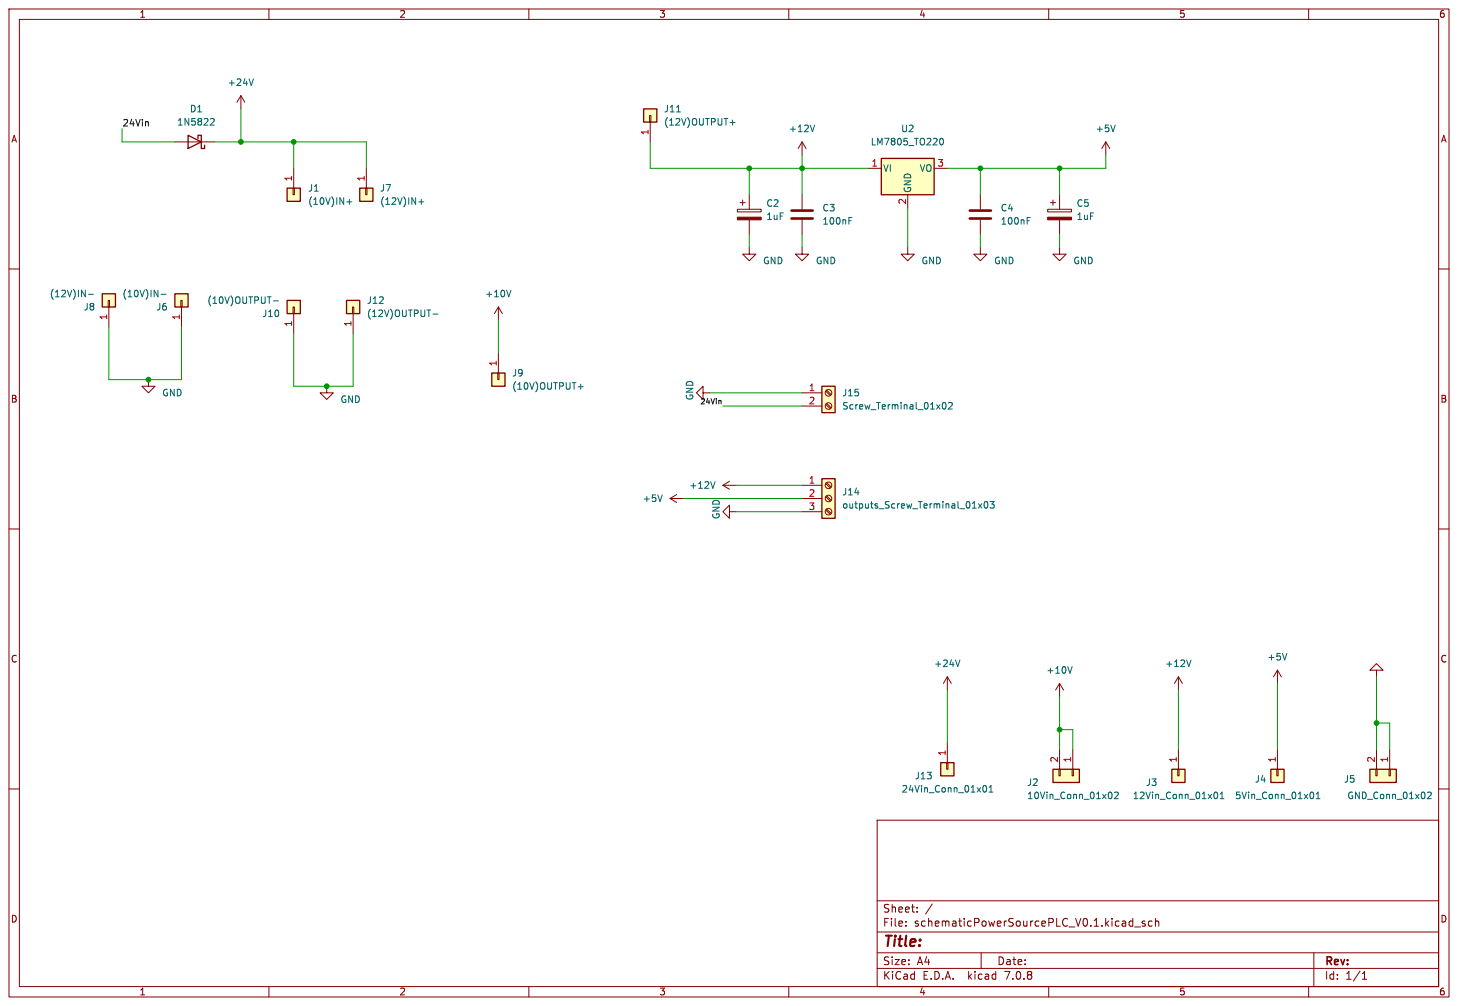
[picture p128: page 1]

Id: 1/1 Title: File: schematicPowerSourcePLC_V0.1.kicad_sch Sheet: /
