nxvxr14/control-celda-fts-mecatronica-UNAB/Electronica/Esquematicos finales PDF/schematicFisher_V0.1.pdf

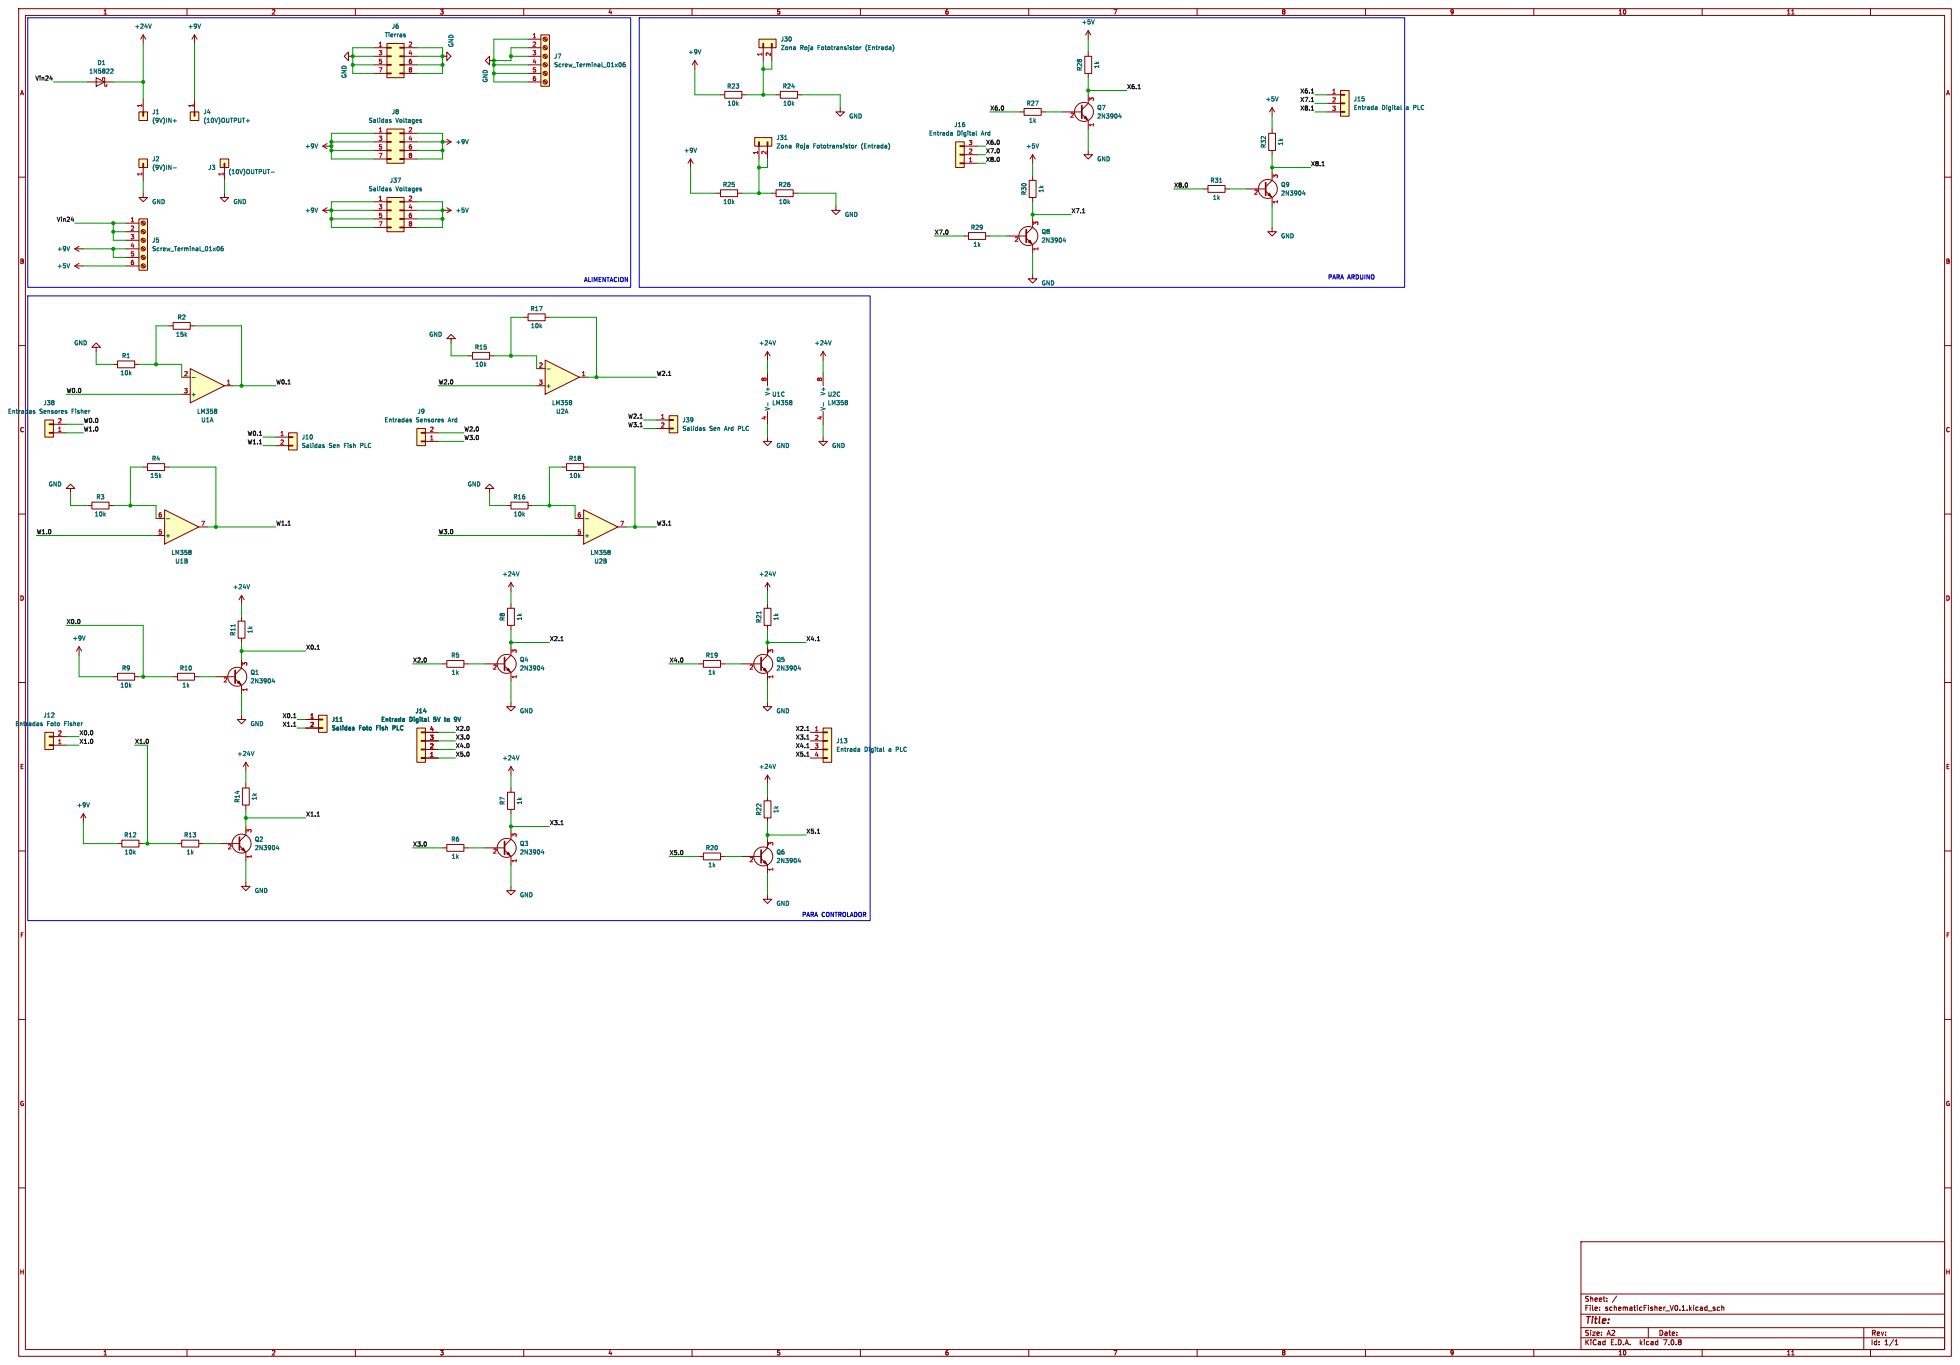
[picture p129: page 1]

J11 Salidas Foto Fish PLC
