nxvxr14/control-celda-fts-mecatronica-UNAB/Electronica/Esquematicos finales PDF/schematicPLC_V0.1.pdf

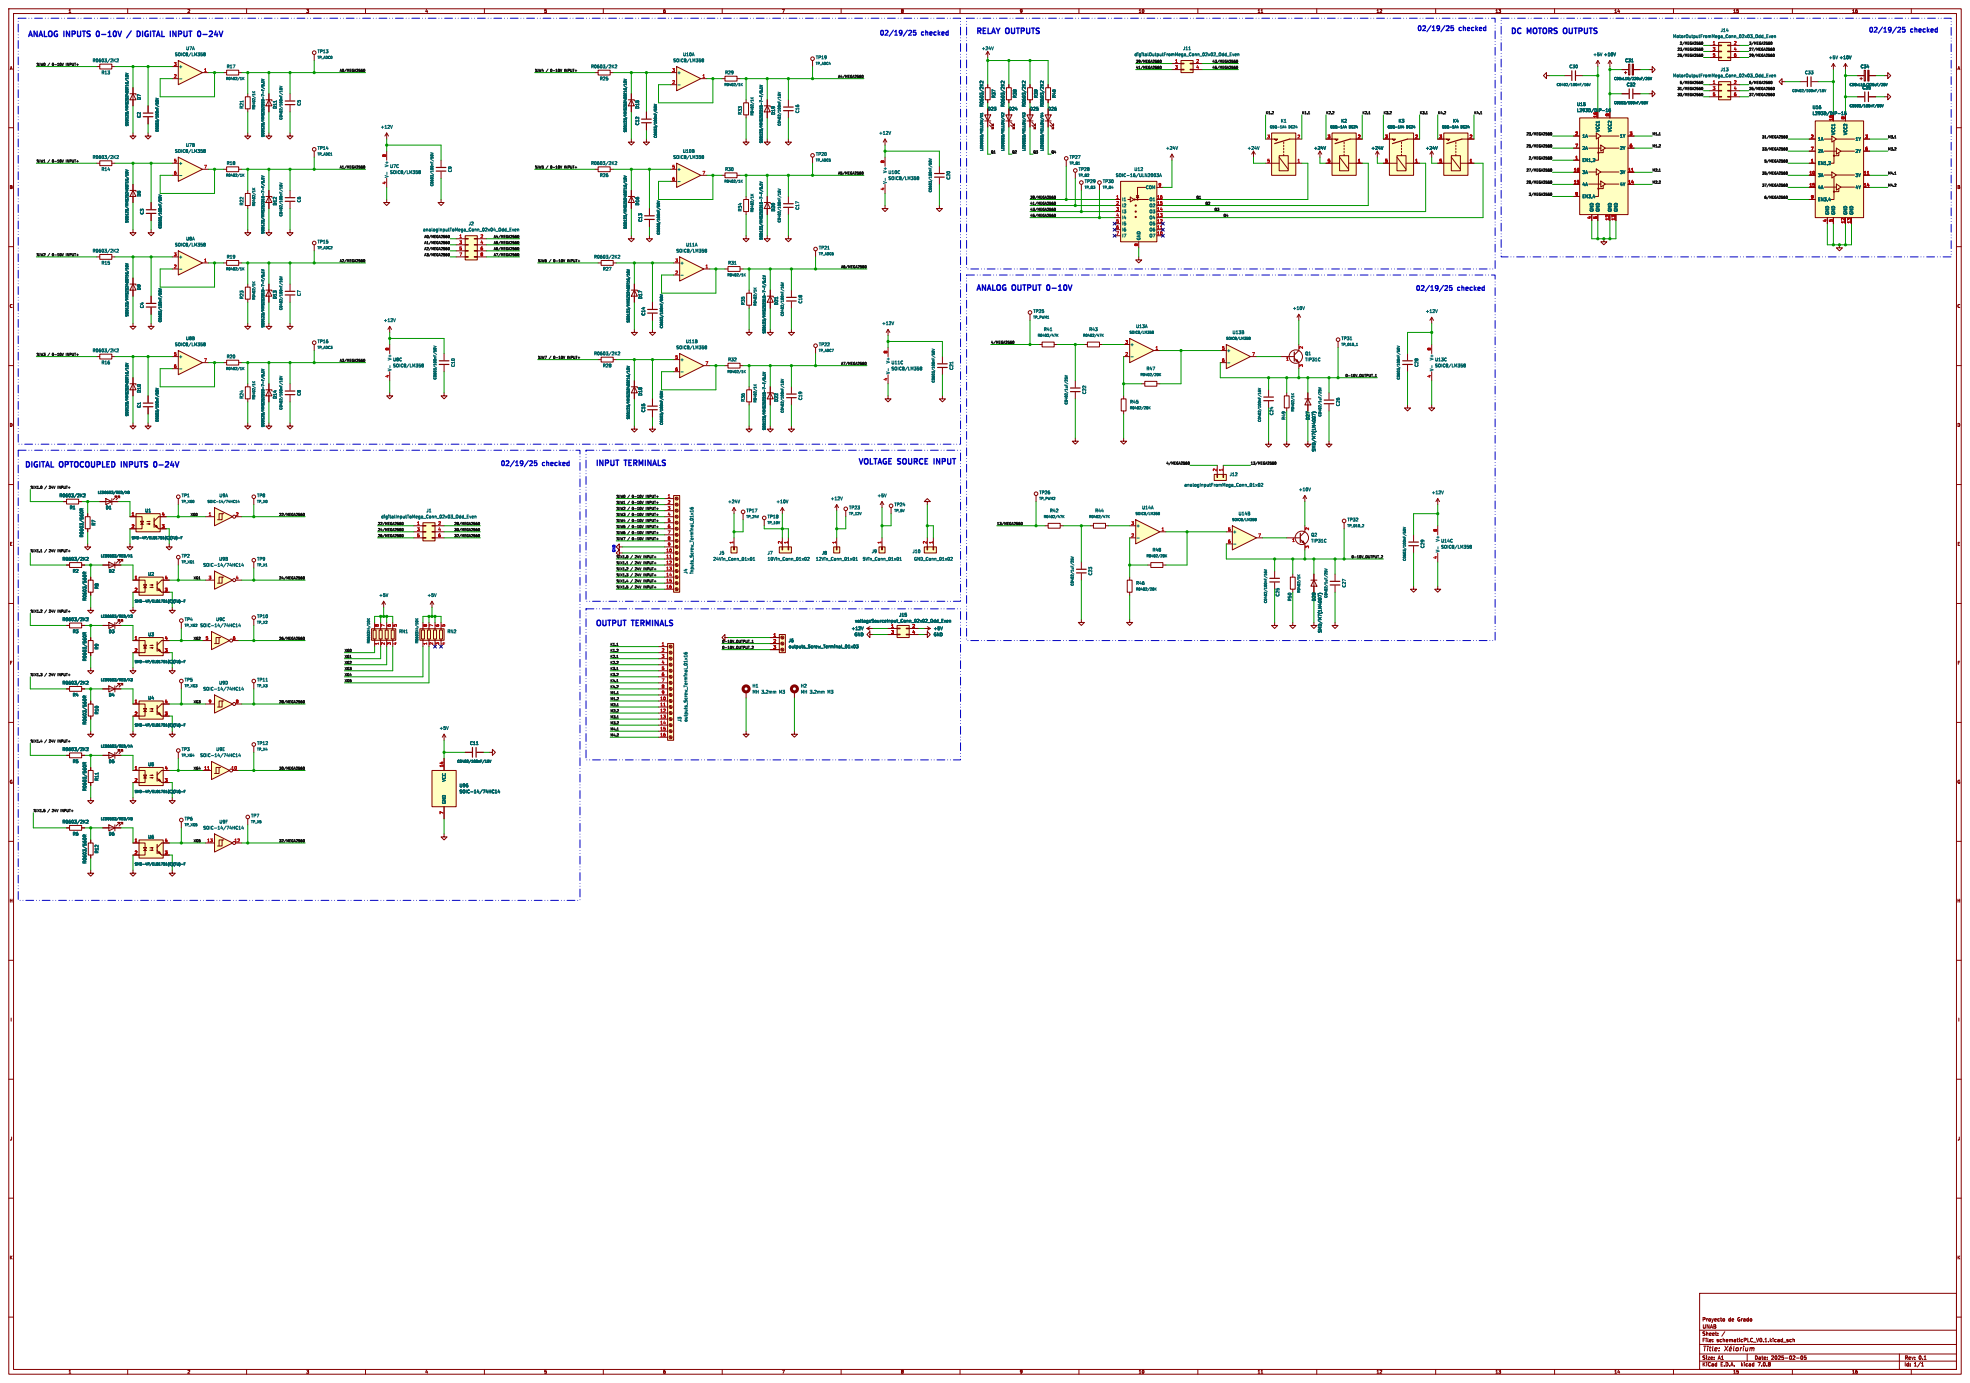
[picture p130: page 1]
