nxvxr14/control-celda-fts-mecatronica-UNAB/Electronica/Esquematicos finales PDF/schematicShieldPLC_V0.3.pdf

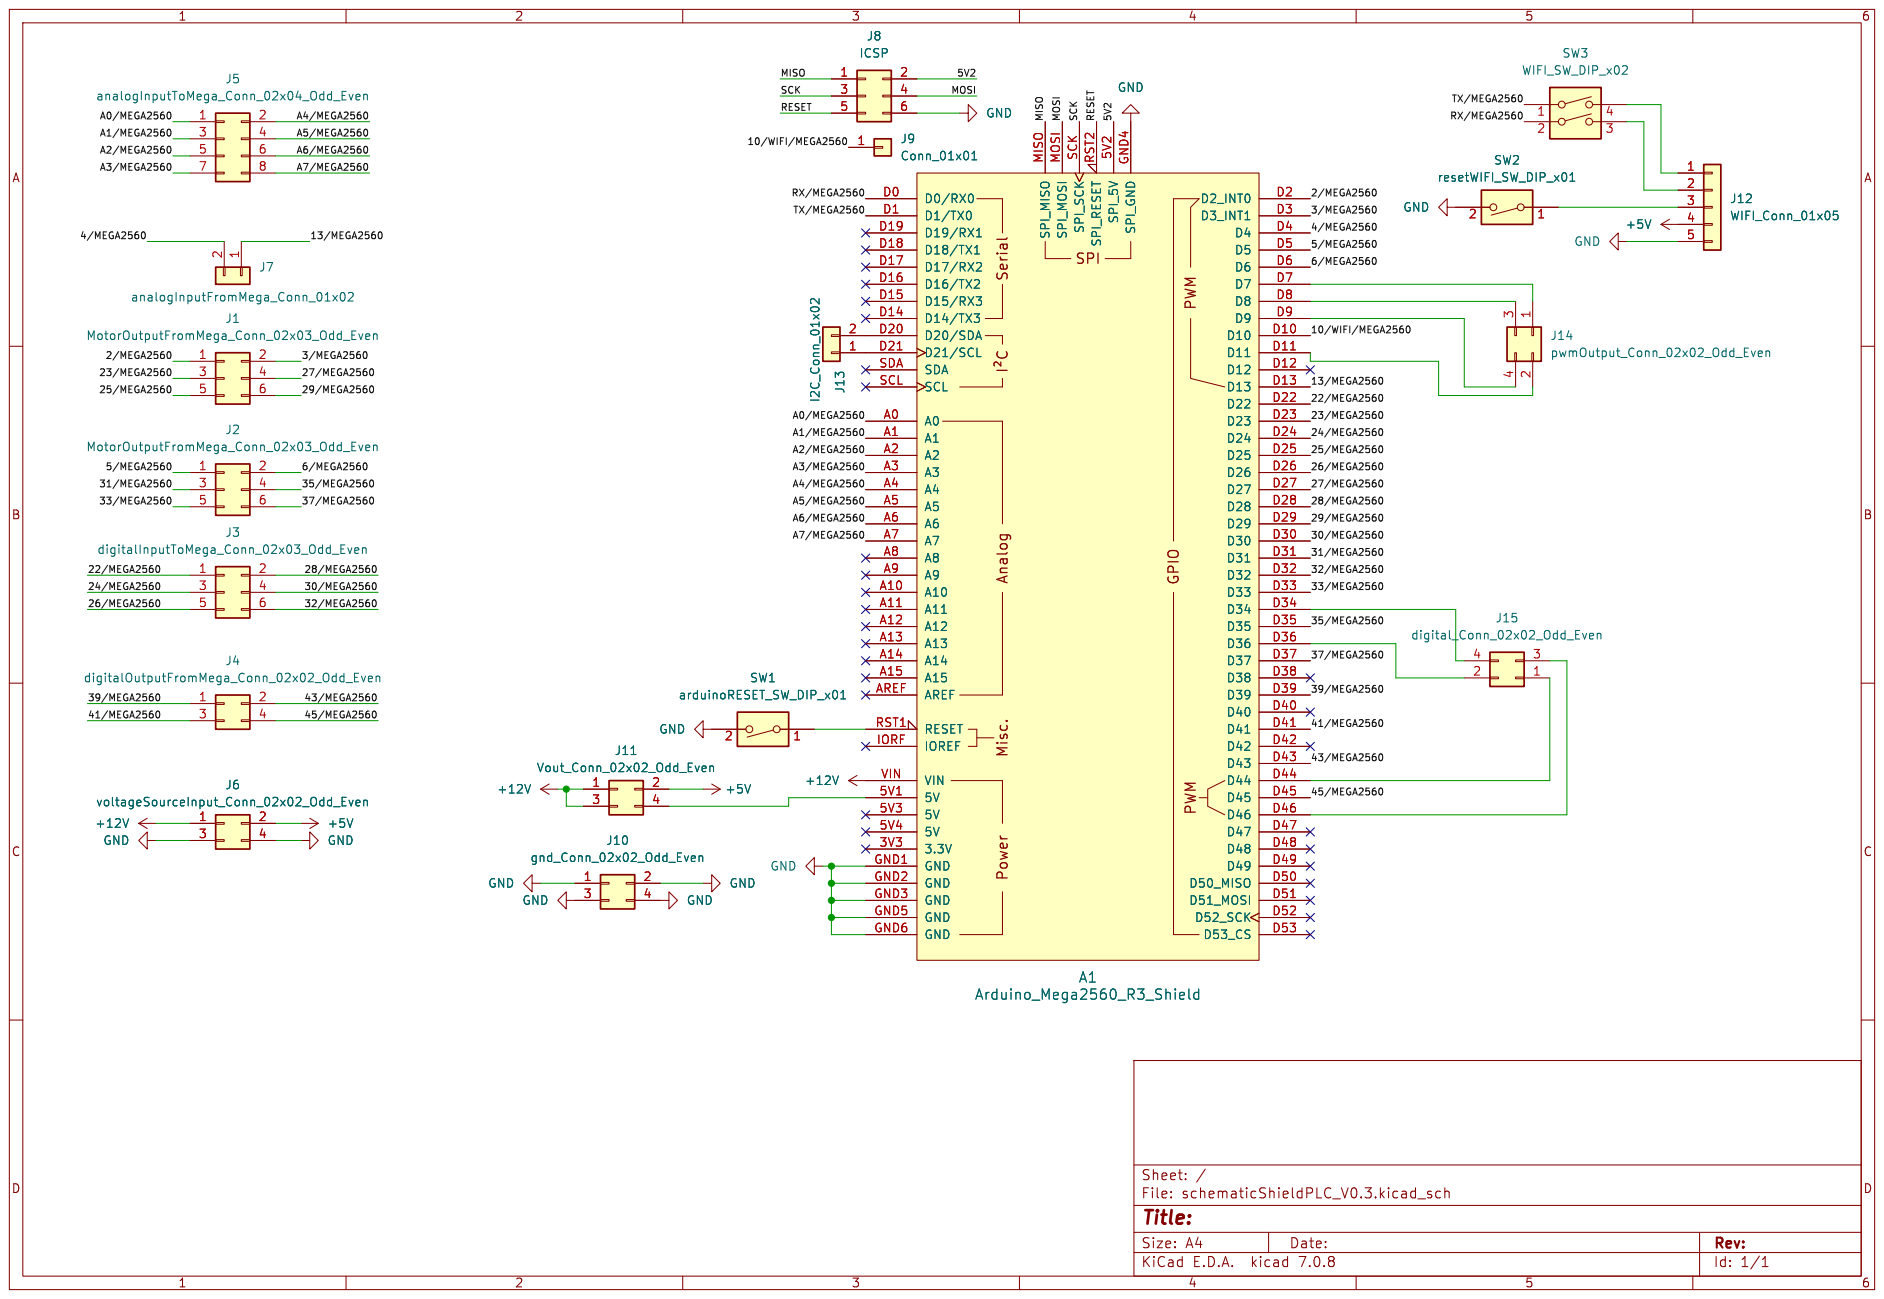
[picture p131: page 1]
