nxvxr14/control-celda-fts-mecatronica-UNAB/Modelos 3D/Carcasa/CarcasaControlador.pdf

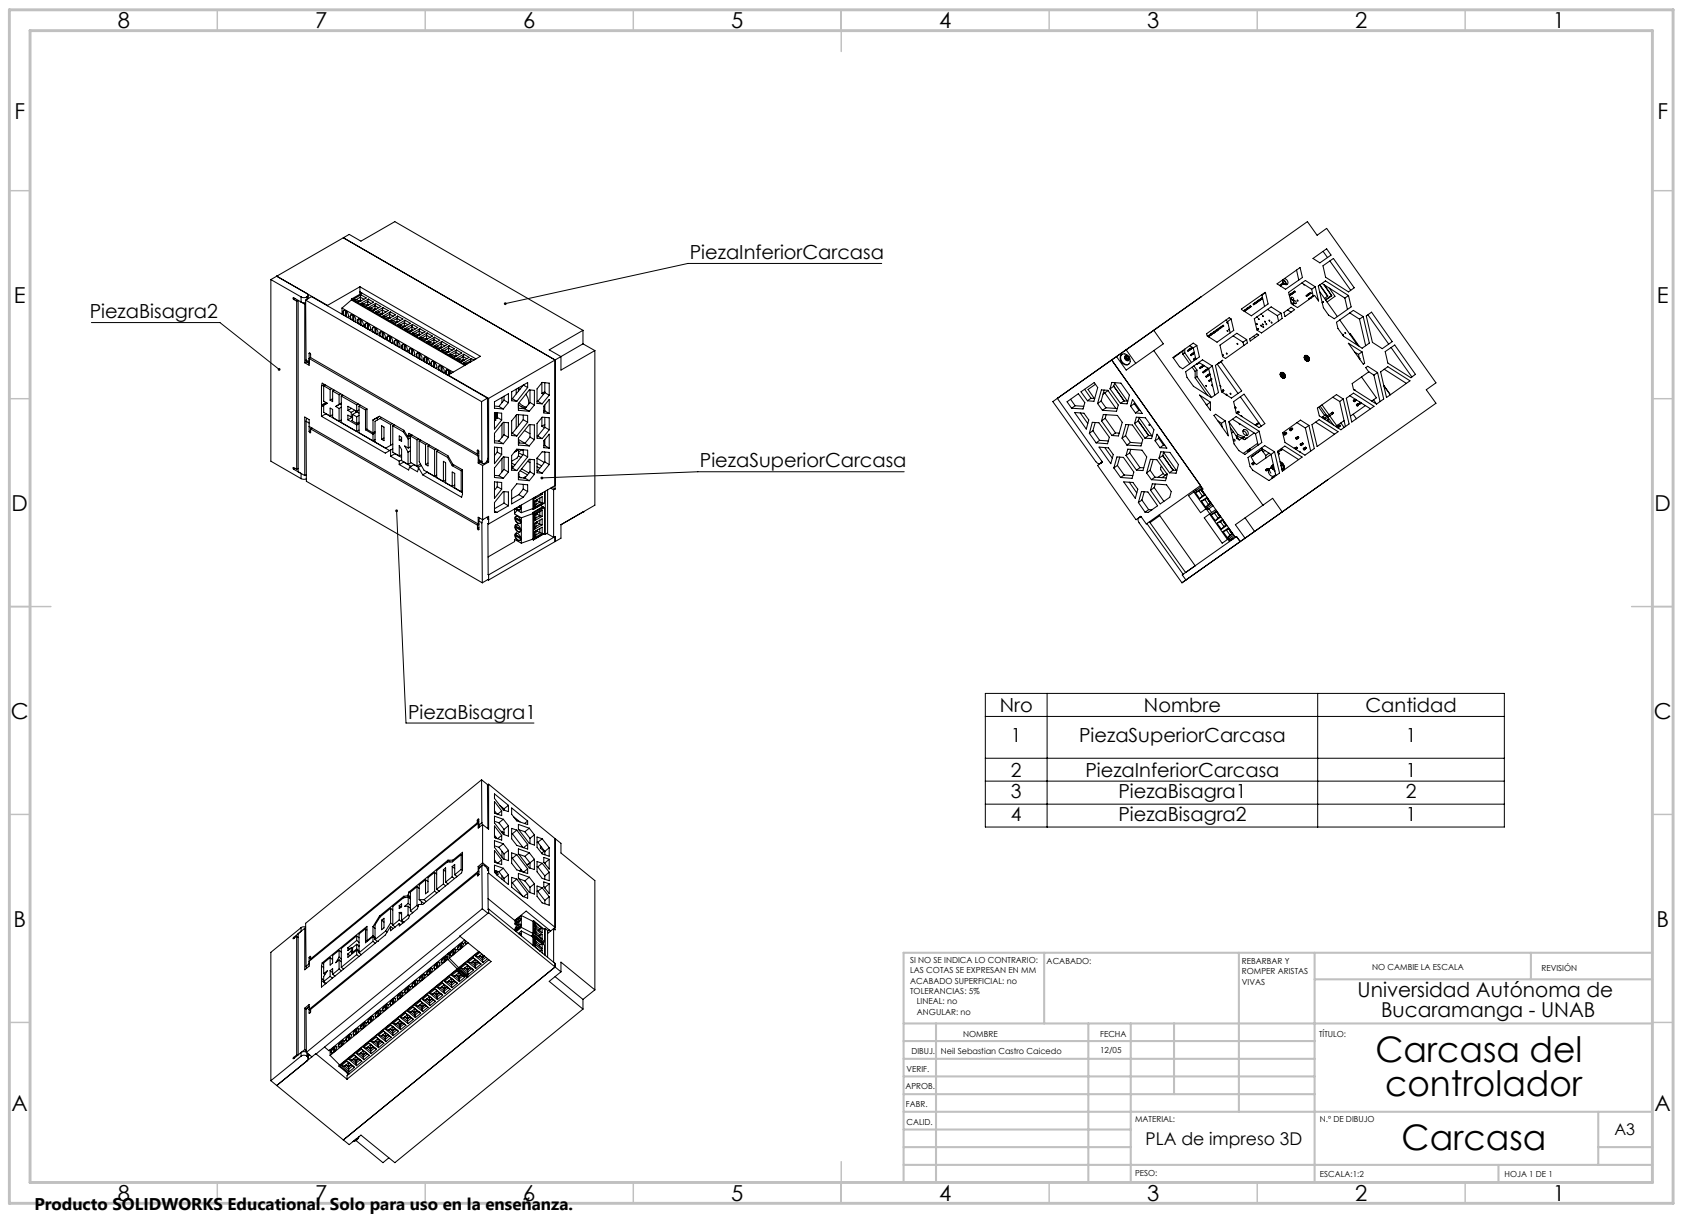
[picture p132: page 1]
ACABADO:; REBARBAR Y; ROMPER ARISTAS; NO CAMBIE LA ESCALA; REVISIÓN; ESCALA:1:2; HOJA 1 DE 1

Nro | Nombre | Cantidad
1 | PiezaSuperiorCarcasa | 1
2 | PiezaInferiorCarcasa | 1
3 | PiezaBisagra1 | 2
4 | PiezaBisagra2 | 1

SI NO SE INDICA LO CONTRARIO:
LAS COTAS SE EXPRESAN EN MM
ACABADO SUPERFICIAL: no
TOLERANCIAS: 5%
LINEAL: no
ANGULAR: no

Universidad Autónoma de
Bucaramanga - UNAB

NOMBRE | FECHA | | | | Carcasa del TÍTULO: controlador

DIBUJ. | Neil Sebastian Castro Caicedo | 12/05
VERIF.
APROB.
FABR.
CALID. | | | MATERIAL: PLA de impreso 3D | N.º DE DIBUJO Carcasa | A3

Producto SOLIDWORKS Educational. Solo para uso en la enseñanza.
