nxvxr14/control-celda-fts-mecatronica-UNAB/Modelos 3D/Carcasa/PiezaBisagra2.pdf

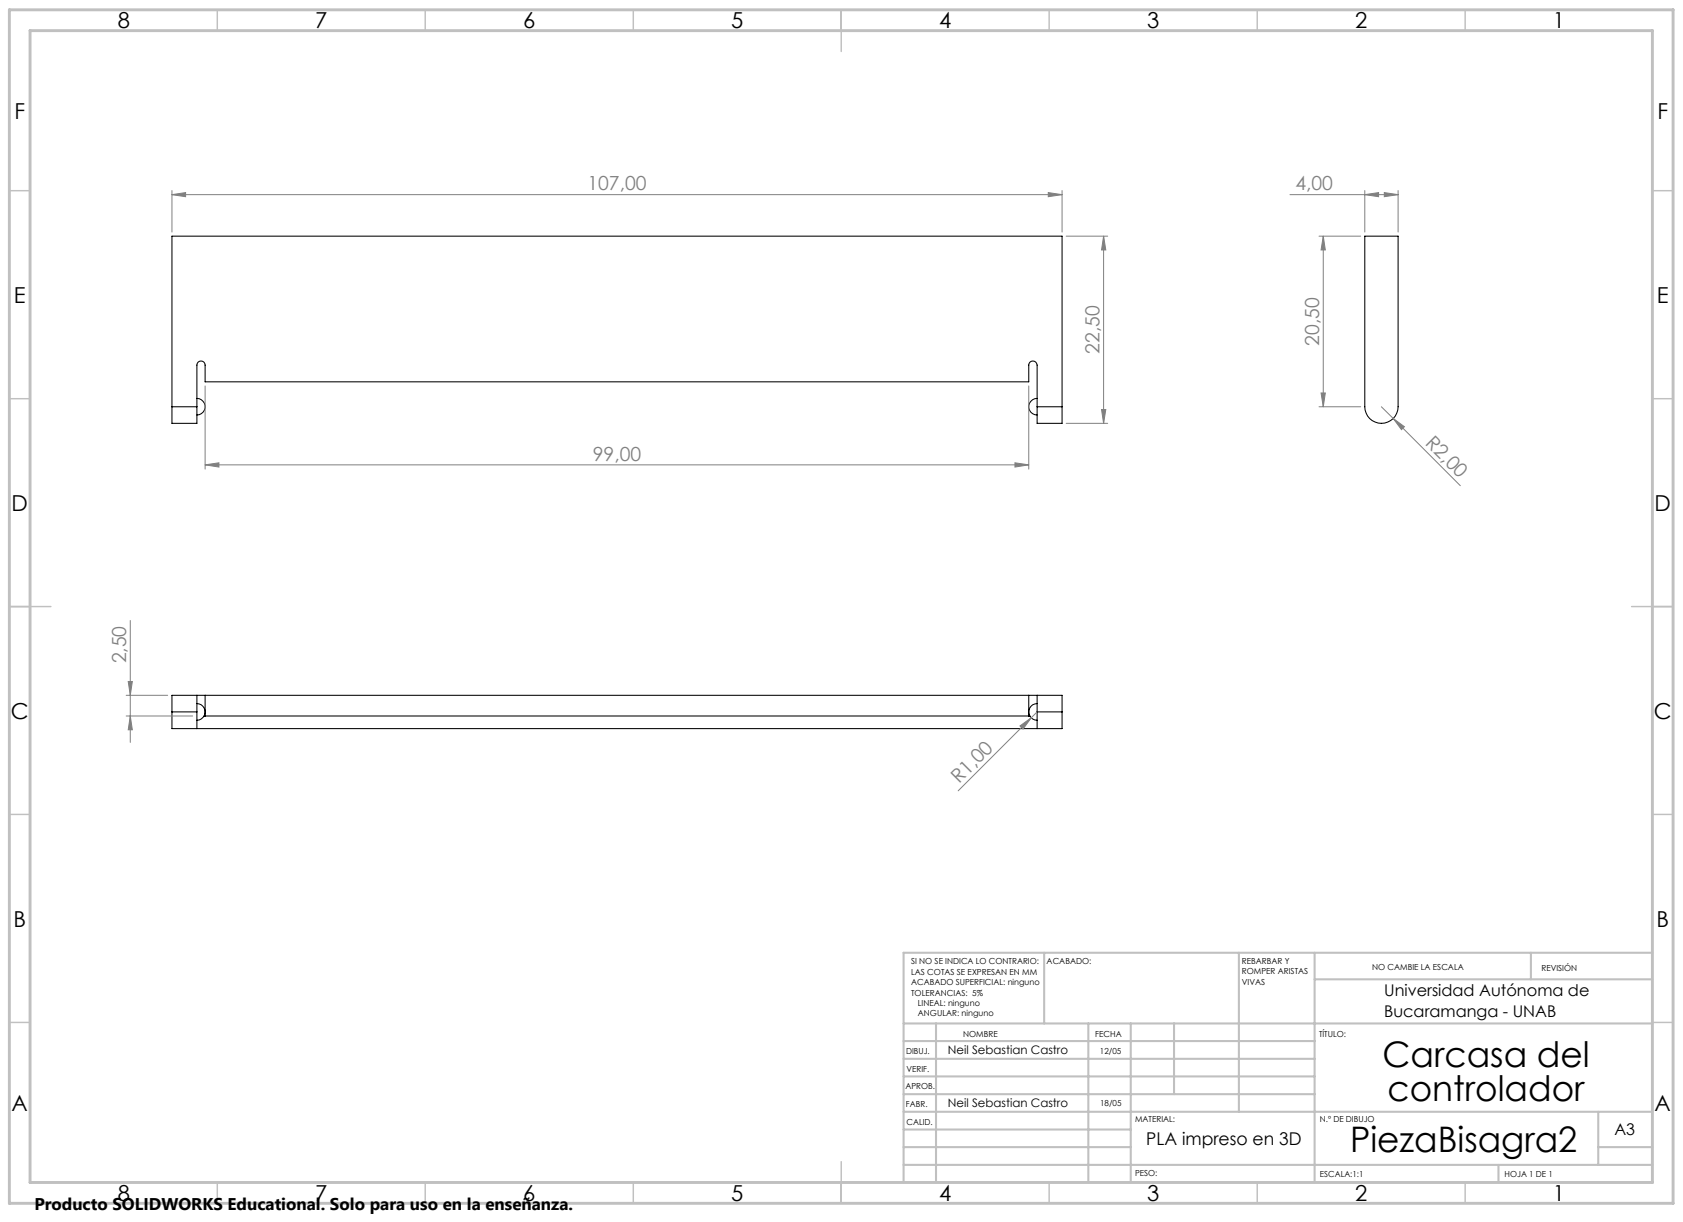
[picture p133: page 1]
ACABADO:; REBARBAR Y; ROMPER ARISTAS; NO CAMBIE LA ESCALA; REVISIÓN; ESCALA:1:1; HOJA 1 DE 1

SI NO SE INDICA LO CONTRARIO:
LAS COTAS SE EXPRESAN EN MM
ACABADO SUPERFICIAL: ninguno
TOLERANCIAS: 5%
LINEAL: ninguno
ANGULAR: ninguno

Universidad Autónoma de
Bucaramanga - UNAB

NOMBRE | FECHA | | | | TÍTULO: Carcasa del controlador

DIBUJ. | Neil Sebastian Castro | 12/05

VERIF.
APROB.
FABR. | Neil Sebastian Castro | 18/05
CALID. | | | MATERIAL: PLA impreso en 3D | N.º DE DIBUJO PiezaBisagra2 | A3

Producto SOLIDWORKS Educational. Solo para uso en la enseñanza.
