nxvxr14/control-celda-fts-mecatronica-UNAB/Modelos 3D/Carcasa/PiezaSuperiorCarcasa.pdf

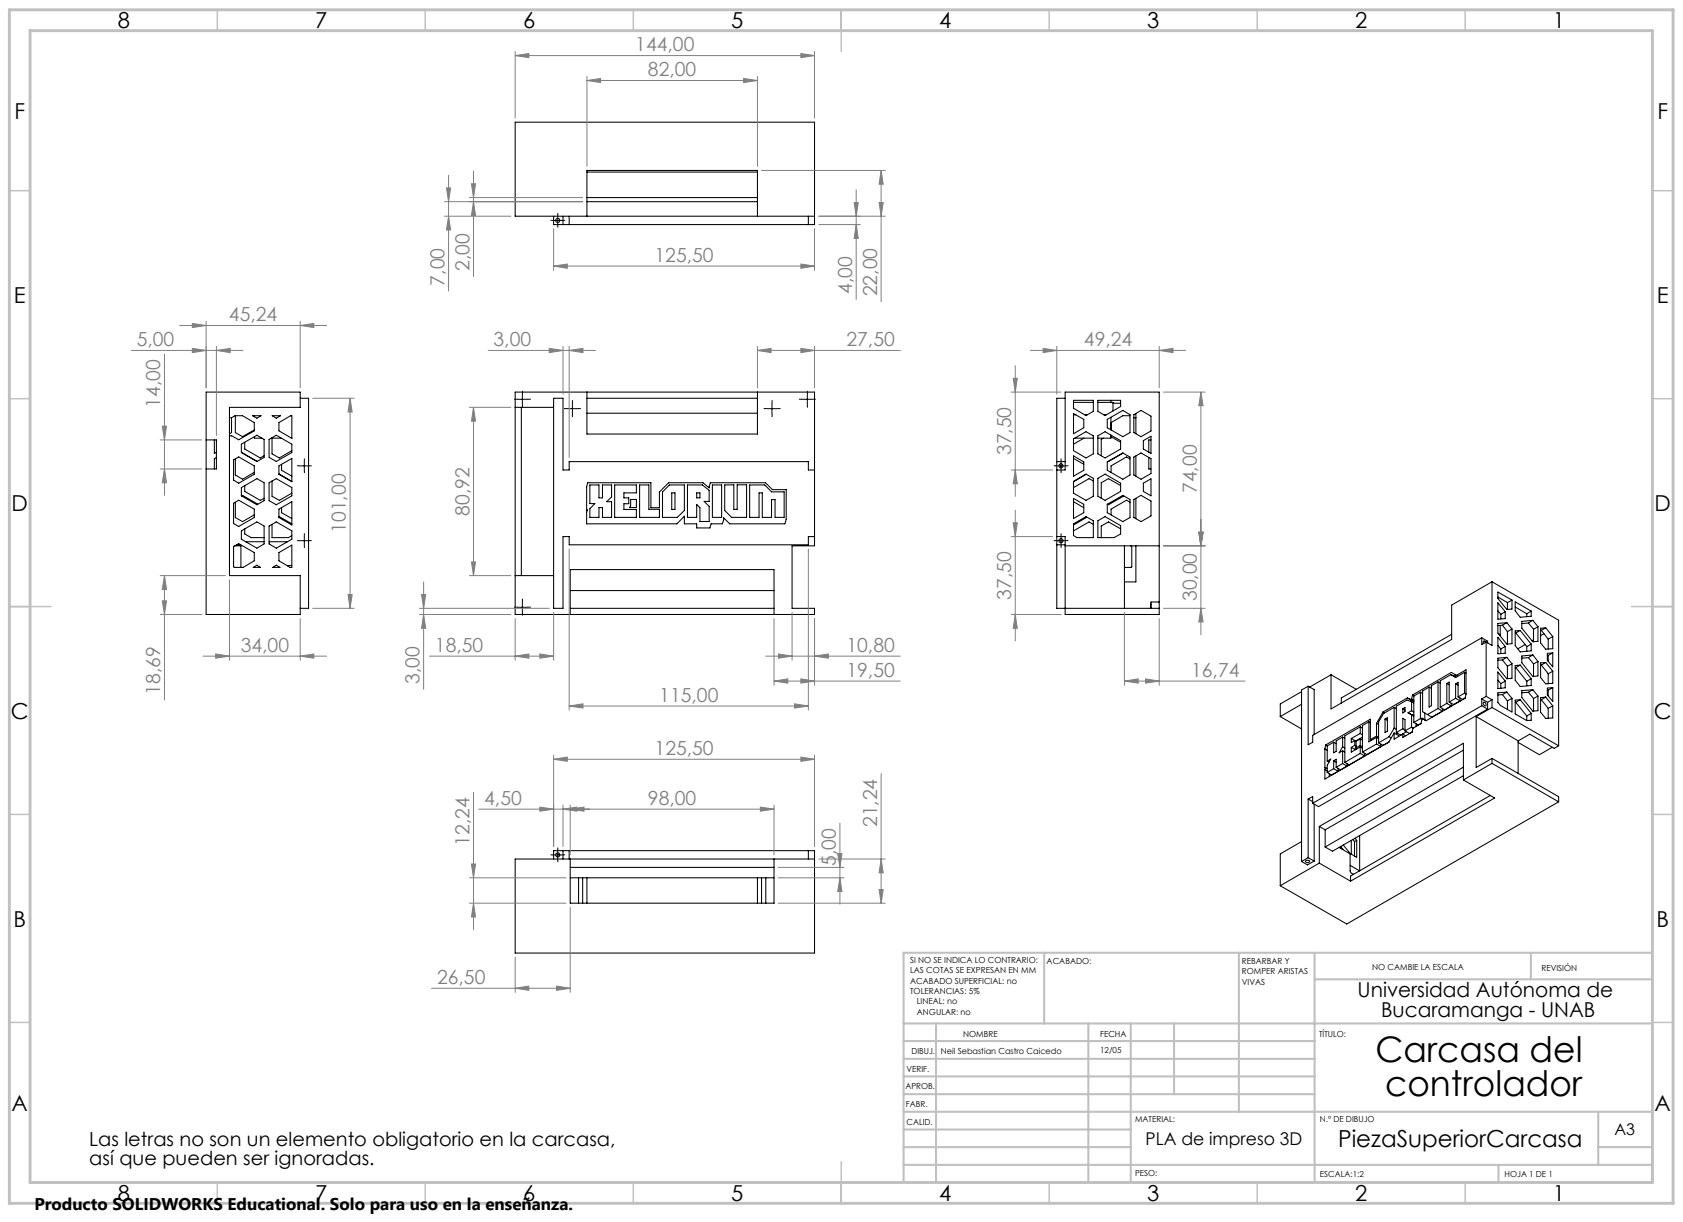
[picture p134: page 1]
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

Universidad Autónoma de
Bucaramanga - UNAB

NOMBRE | FECHA | | | | Carcasa del TÍTULO: controlador

DIBUJ. | Neil Sebastian Castro Caicedo | 12/05
VERIF.
APROB.
FABR.
CALID. | | | MATERIAL: PLA de impreso 3D | N.º DE DIBUJO PiezaSuperiorCarcasa | A3

Las letras no son un elemento obligatorio en la carcasa,
así que pueden ser ignoradas.
Producto SOLIDWORKS Educational. Solo para uso en la enseñanza.
