nxvxr14/control-celda-fts-mecatronica-UNAB/(list of files, drawings)

Other design files:
Electronica/Simulaciones/analogIN.pdsprj
Electronica/Simulaciones/analogINmA.pdsprj
Electronica/Simulaciones/analogINv2.pdsprj
Electronica/Simulaciones/analogOUTPUT.pdsprj
Electronica/Simulaciones/digitalIN.pdsprj
Electronica/Simulaciones/digitalOUTPUT.pdsprj
Electronica/Simulaciones/motorOUTPUT.pdsprj
Electronica/Simulaciones/powerSource.pdsprj
Electronica/Simulaciones/powerSource_v2.pdsprj
Electronica/Simulaciones/Project Backups/analogIN [20241002, 14-39-13].pdsprj
Electronica/Simulaciones/Project Backups/analogIN [20241002, 16-19-46].pdsprj
Electronica/Simulaciones/Project Backups/analogINmA [20241002, 16-24-02].pdsprj
Electronica/Simulaciones/Project Backups/analogINmA [20241002, 16-24-09].pdsprj
Electronica/Simulaciones/Project Backups/analogINmA [20241002, 16-32-03].pdsprj
Electronica/Simulaciones/Project Backups/analogINv2 [20250124, 13-36-45].pdsprj
Electronica/Simulaciones/Project Backups/analogINv2 [20250124, 13-56-32].pdsprj
Electronica/Simulaciones/Project Backups/analogINv2 [20250124, 22-00-08].pdsprj
Electronica/Simulaciones/Project Backups/analogINv2 [20250205, 13-58-50].pdsprj
Electronica/Simulaciones/Project Backups/analogINv2 [20250205, 13-59-09].pdsprj
Electronica/Simulaciones/Project Backups/analogINv2 [20250209, 11-52-01].pdsprj
Electronica/Simulaciones/Project Backups/analogINv2 [20250209, 12-56-39].pdsprj
Electronica/Simulaciones/Project Backups/analogINv2 [20250210, 20-33-38].pdsprj
Electronica/Simulaciones/Project Backups/analogINv2 [20250211, 10-23-00].pdsprj
Electronica/Simulaciones/Project Backups/analogINv2 [20250211, 16-20-28].pdsprj
Electronica/Simulaciones/Project Backups/analogOUTPUT [20241003, 10-50-43].pdsprj
Electronica/Simulaciones/Project Backups/analogOUTPUT [20250206, 15-38-28].pdsprj
Electronica/Simulaciones/Project Backups/analogOUTPUT [20250206, 15-41-55].pdsprj
Electronica/Simulaciones/Project Backups/analogOUTPUT [20250206, 17-24-27].pdsprj
Electronica/Simulaciones/Project Backups/analogOUTPUT [20250206, 17-25-14].pdsprj
Electronica/Simulaciones/Project Backups/analogOUTPUT [20250208, 18-38-43].pdsprj
Electronica/Simulaciones/Project Backups/analogOUTPUT [20250208, 21-35-13].pdsprj
Electronica/Simulaciones/Project Backups/analogOUTPUT [20250210, 22-13-21].pdsprj
Electronica/Simulaciones/Project Backups/analogOUTPUT [20250210, 22-13-38].pdsprj
Electronica/Simulaciones/Project Backups/analogOUTPUT [20250210, 22-20-01].pdsprj
Electronica/Simulaciones/Project Backups/digitalIN [20241002, 13-13-34].pdsprj
Electronica/Simulaciones/Project Backups/digitalIN [20241002, 13-18-22].pdsprj
Electronica/Simulaciones/Project Backups/digitalIN [20241002, 13-19-09].pdsprj
Electronica/Simulaciones/Project Backups/digitalIN [20241002, 13-20-42].pdsprj
Electronica/Simulaciones/Project Backups/digitalIN [20241105, 11-35-38].pdsprj
Electronica/Simulaciones/Project Backups/digitalIN [20250209, 13-15-35].pdsprj
Electronica/Simulaciones/Project Backups/digitalOUTPUT [20241002, 23-52-37].pdsprj
Electronica/Simulaciones/Project Backups/digitalOUTPUT [20250207, 21-47-32].pdsprj
Electronica/Simulaciones/Project Backups/digitalOUTPUT [20250207, 21-49-24].pdsprj
Electronica/Simulaciones/Project Backups/digitalOUTPUT [20250207, 21-49-28].pdsprj
Electronica/Simulaciones/Project Backups/digitalOUTPUT [20250603, 10-46-57].pdsprj
Electronica/Simulaciones/Project Backups/motorOUTPUT [20250129, 09-49-48].pdsprj
Electronica/Simulaciones/Project Backups/motorOUTPUT [20250129, 13-37-52].pdsprj
Electronica/Simulaciones/Project Backups/motorOUTPUT [20250131, 18-44-54].pdsprj
Electronica/Simulaciones/Project Backups/motorOUTPUT [20250207, 21-55-12].pdsprj
Electronica/Simulaciones/Project Backups/motorOUTPUT [20250208, 22-18-03].pdsprj
Electronica/Simulaciones/Project Backups/powerSource [20241006, 21-30-06].pdsprj
Electronica/Simulaciones/Project Backups/powerSource [20241006, 21-30-07].pdsprj
Electronica/Simulaciones/Project Backups/pwmOUTPUT [20241021, 21-46-09].pdsprj
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
