nxvxr14/control-celda-fts-mecatronica-UNAB/Electronica/PCB Desings/schematicFisher_V0.1/schematicFisher_V0.1.kicad_pcb

## KiCad design Electronica/PCB Desings/schematicFisher_V0.1/schematicFisher_V0.1.kicad_pcb (2025-11-04)

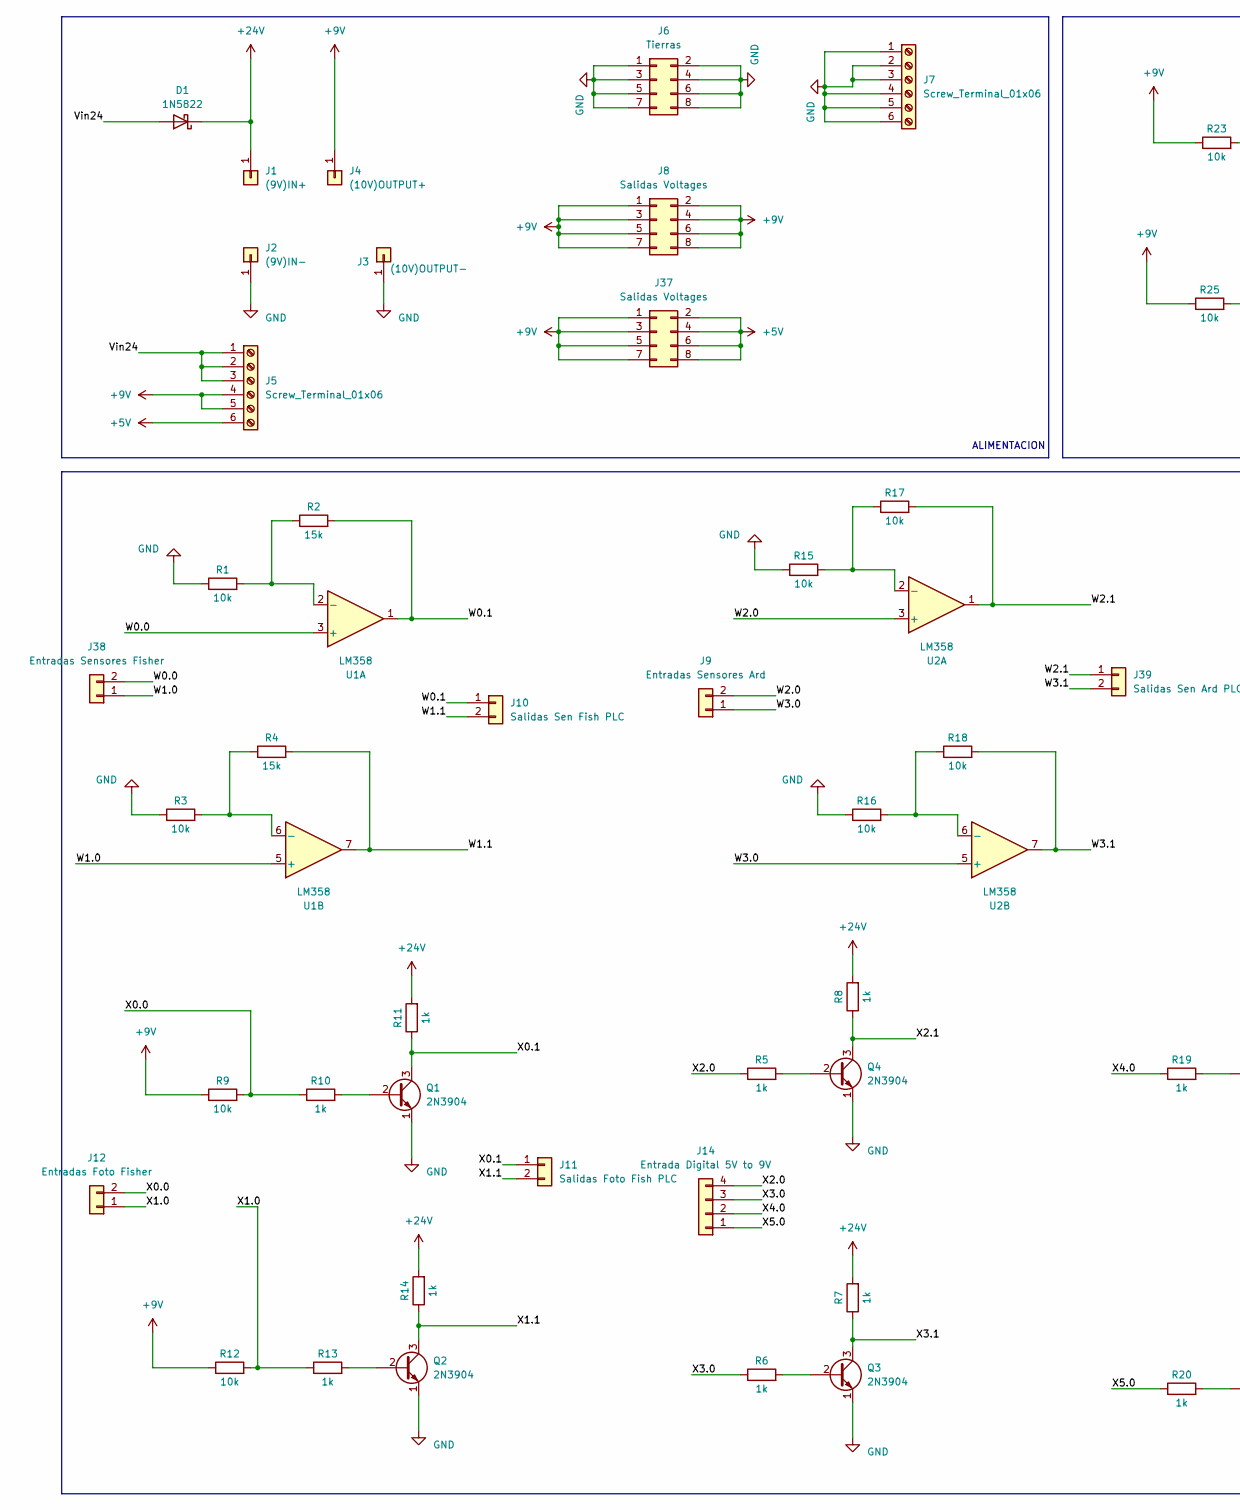
[picture p135: schematic schematicFisher_V0.1.kicad_sch, part in row 1, column 1]

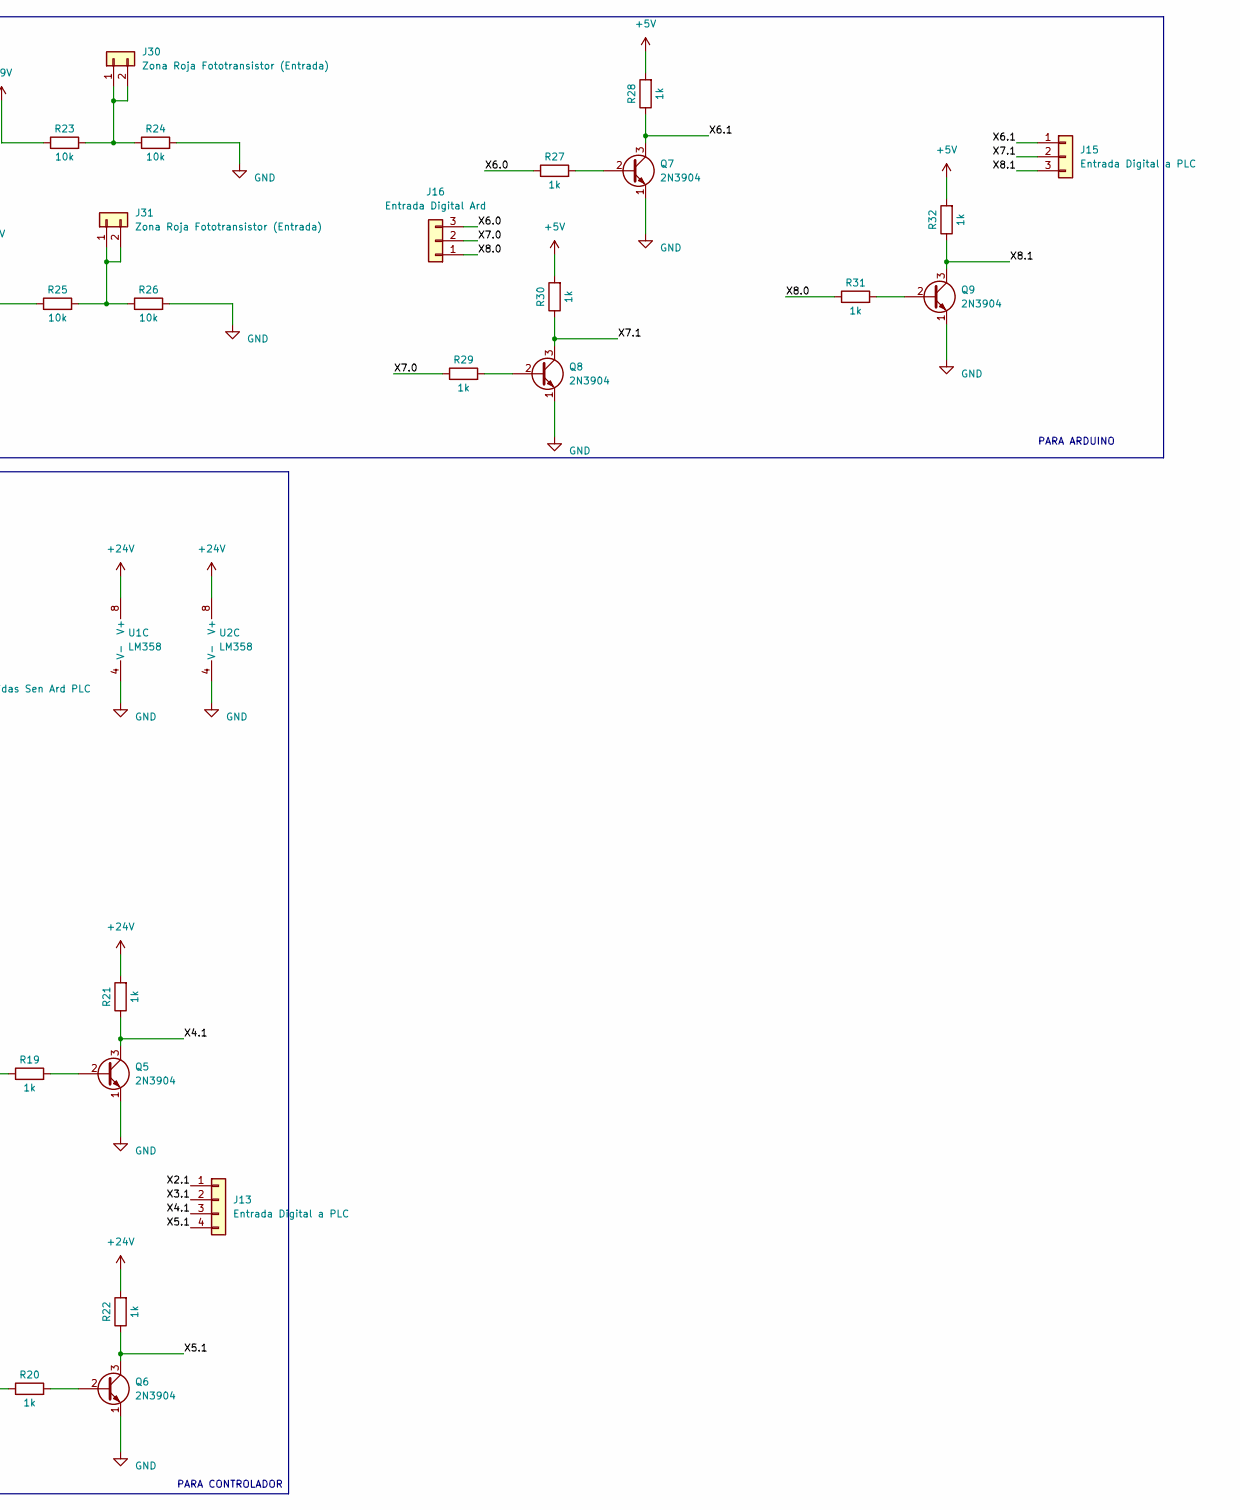
[picture p136: schematic schematicFisher_V0.1.kicad_sch, part in row 1, column 2]

Parts:
D1: 1N5822; D_DO-201AD_P15.24mm_Horizontal
J1: (9V)IN+; PinSocket_1x01_P2.54mm_Vertical
J2: (9V)IN-; PinSocket_1x01_P2.54mm_Vertical
J3: (10V)OUTPUT-; PinSocket_1x01_P2.54mm_Vertical
J4: (10V)OUTPUT+; PinSocket_1x01_P2.54mm_Vertical
J5, J7: Screw_Terminal_01x06; TerminalBlock_Phoenix_MKDS-1,5-6_1x06_P5.00mm_Horizontal
J6: Tierras; PinHeader_2x04_P2.54mm_Vertical
J8, J37: Salidas Voltages; PinSocket_2x04_P2.54mm_Vertical
J9: Entradas Sensores Ard; PinHeader_1x02_P2.54mm_Vertical
J10: Salidas Sen Fish PLC; PinHeader_1x02_P2.54mm_Vertical
J11: Salidas Foto Fish PLC; PinHeader_1x02_P2.54mm_Vertical
J12: Entradas Foto Fisher; PinHeader_1x02_P2.54mm_Vertical
J13: Entrada Digital a PLC; PinHeader_1x04_P2.54mm_Vertical
J14: Entrada Digital 5V to 9V; PinHeader_1x04_P2.54mm_Vertical
J15: Entrada Digital a PLC; PinHeader_1x03_P2.54mm_Vertical
J16: Entrada Digital Ard; PinHeader_1x03_P2.54mm_Vertical
J30, J31: Zona Roja Fototransistor (Entrada); PinHeader_1x02_P2.54mm_Vertical
J38: Entradas Sensores Fisher; PinHeader_1x02_P2.54mm_Vertical
J39: Salidas Sen Ard PLC; PinHeader_1x02_P2.54mm_Vertical
Q1, Q2, Q3, Q4, Q5, Q6, Q7, Q8, Q9: 2N3904; TO-92_Inline
R1, R3, R9, R12, R15, R16, R17, R18, R23, R24, R25, R26: 10k; R_Axial_DIN0204_L3.6mm_D1.6mm_P5.08mm_Horizontal
R2, R4: 15k; R_Axial_DIN0204_L3.6mm_D1.6mm_P5.08mm_Horizontal
R5, R6, R7, R8, R10, R11, R13, R14, R19, R20, R21, R22, R27, R28, R29, R30, R31, R32: 1k; R_Axial_DIN0204_L3.6mm_D1.6mm_P5.08mm_Horizontal
U1, U2: LM358; DIP-8_W7.62mm_LongPads

Connections:
+5V: J5.6, J37.2, J37.4, J37.6, J37.8, R28.2, R30.2, R32.2
+9V: J4.1, J5.4, J5.5, J8.1, J8.2, J8.3, J8.4, J8.5, J8.6, J8.7, J8.8, J37.1, J37.3, J37.5, J37.7, R9.1, R12.1, R23.1, R25.1
+24V: D1.1 (K), J1.1, R7.2, R8.2, R11.2, R14.2, R21.2, R22.2, U1.8 (V+), U2.8 (V+)
/Vin24: D1.2 (A), J5.1, J5.2, J5.3
/W0.0: J38.2, U1.3 (+)
/W0.1: J10.1, R2.2, U1.1
/W1.0: J38.1, U1.5 (+)
/W1.1: J10.2, R4.2, U1.7
/W2.0: J9.2, U2.3 (+)
/W2.1: J39.1, R17.2, U2.1
/W3.0: J9.1, U2.5 (+)
/W3.1: J39.2, R18.2, U2.7
/X0.0: J12.2, R9.2, R10.1
/X0.1: J11.1, Q1.3 (C), R11.1
/X1.0: J12.1, R12.2, R13.1
/X1.1: J11.2, Q2.3 (C), R14.1
/X2.0: J14.4, R5.1
/X2.1: J13.1, Q4.3 (C), R8.1
/X3.0: J14.3, R6.1
/X3.1: J13.2, Q3.3 (C), R7.1
/X4.0: J14.2, R19.1
/X4.1: J13.3, Q5.3 (C), R21.1
/X5.0: J14.1, R20.1
/X5.1: J13.4, Q6.3 (C), R22.1
/X6.0: J16.3, R27.1
/X6.1: J15.1, Q7.3 (C), R28.1
/X7.0: J16.2, R29.1
/X7.1: J15.2, Q8.3 (C), R30.1
/X8.0: J16.1, R31.1
/X8.1: J15.3, Q9.3 (C), R32.1
GND: J2.1, J3.1, J6.1, J6.2, J6.3, J6.4, J6.5, J6.6, J6.7, J6.8, J7.1, J7.2, J7.3, J7.4, J7.5, J7.6, Q1.1 (E), Q2.1 (E), Q3.1 (E), Q4.1 (E), Q5.1 (E), Q6.1 (E), Q7.1 (E), Q8.1 (E), Q9.1 (E), R1.1, R3.1, R15.1, R16.1, R24.2, R26.2, U1.4 (V-), U2.4 (V-)
unnamed: J30.1, J30.2, R23.2, R24.1
unnamed: J31.1, J31.2, R25.2, R26.1
unnamed: Q1.2 (B), R10.2
unnamed: Q2.2 (B), R13.2
unnamed: Q3.2 (B), R6.2
unnamed: Q4.2 (B), R5.2
unnamed: Q5.2 (B), R19.2
unnamed: Q6.2 (B), R20.2
unnamed: Q7.2 (B), R27.2
unnamed: Q8.2 (B), R29.2
unnamed: Q9.2 (B), R31.2
unnamed: R1.2, R2.1, U1.2 (-)
unnamed: R3.2, R4.1, U1.6 (-)
unnamed: R15.2, R17.1, U2.2 (-)
unnamed: R16.2, R18.1, U2.6 (-)

Notes on the sheet:
PARA CONTROLADOR
PARA ARDUINO
ALIMENTACION

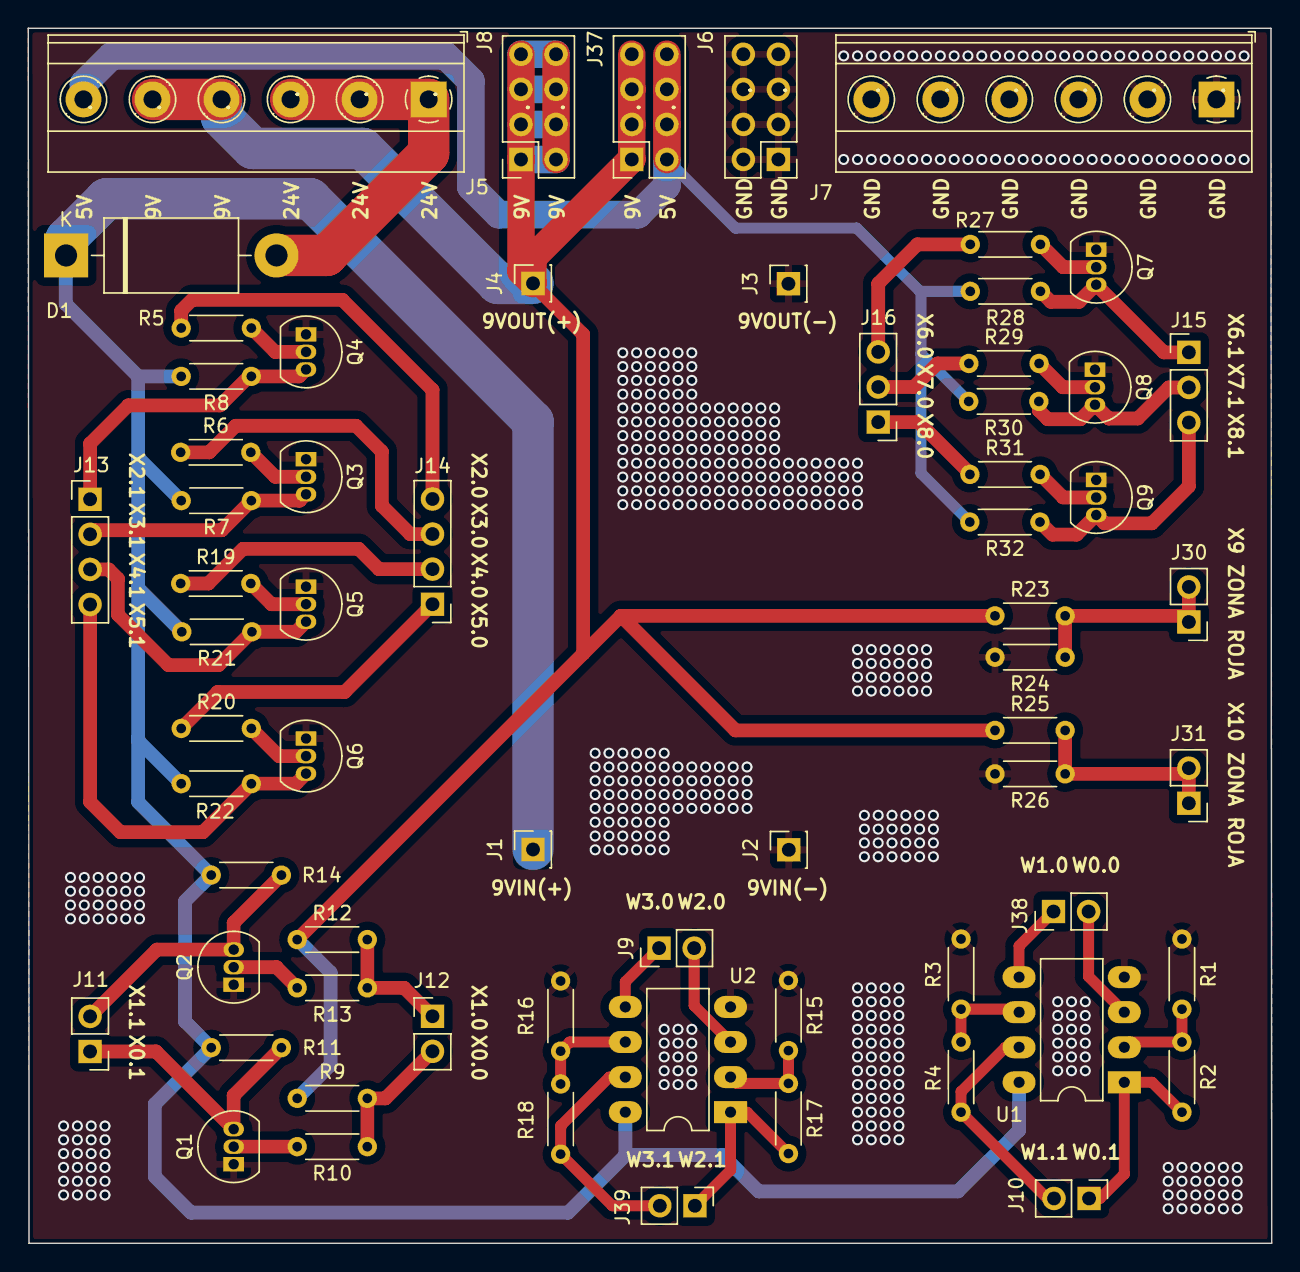
[picture p137: board schematicFisher_V0.1.kicad_pcb from above]

Board: 2 copper layers, 90.1 x 88.0 mm, 65 parts (0 on the bottom side), 46 nets.
