nxvxr14/control-celda-fts-mecatronica-UNAB/Electronica/PCB Desings/schematicShieldPLC_V0.3/schematicShieldPLC_V0.3.kicad_pcb

## KiCad design Electronica/PCB Desings/schematicShieldPLC_V0.3/schematicShieldPLC_V0.3.kicad_pcb (2025-11-04)

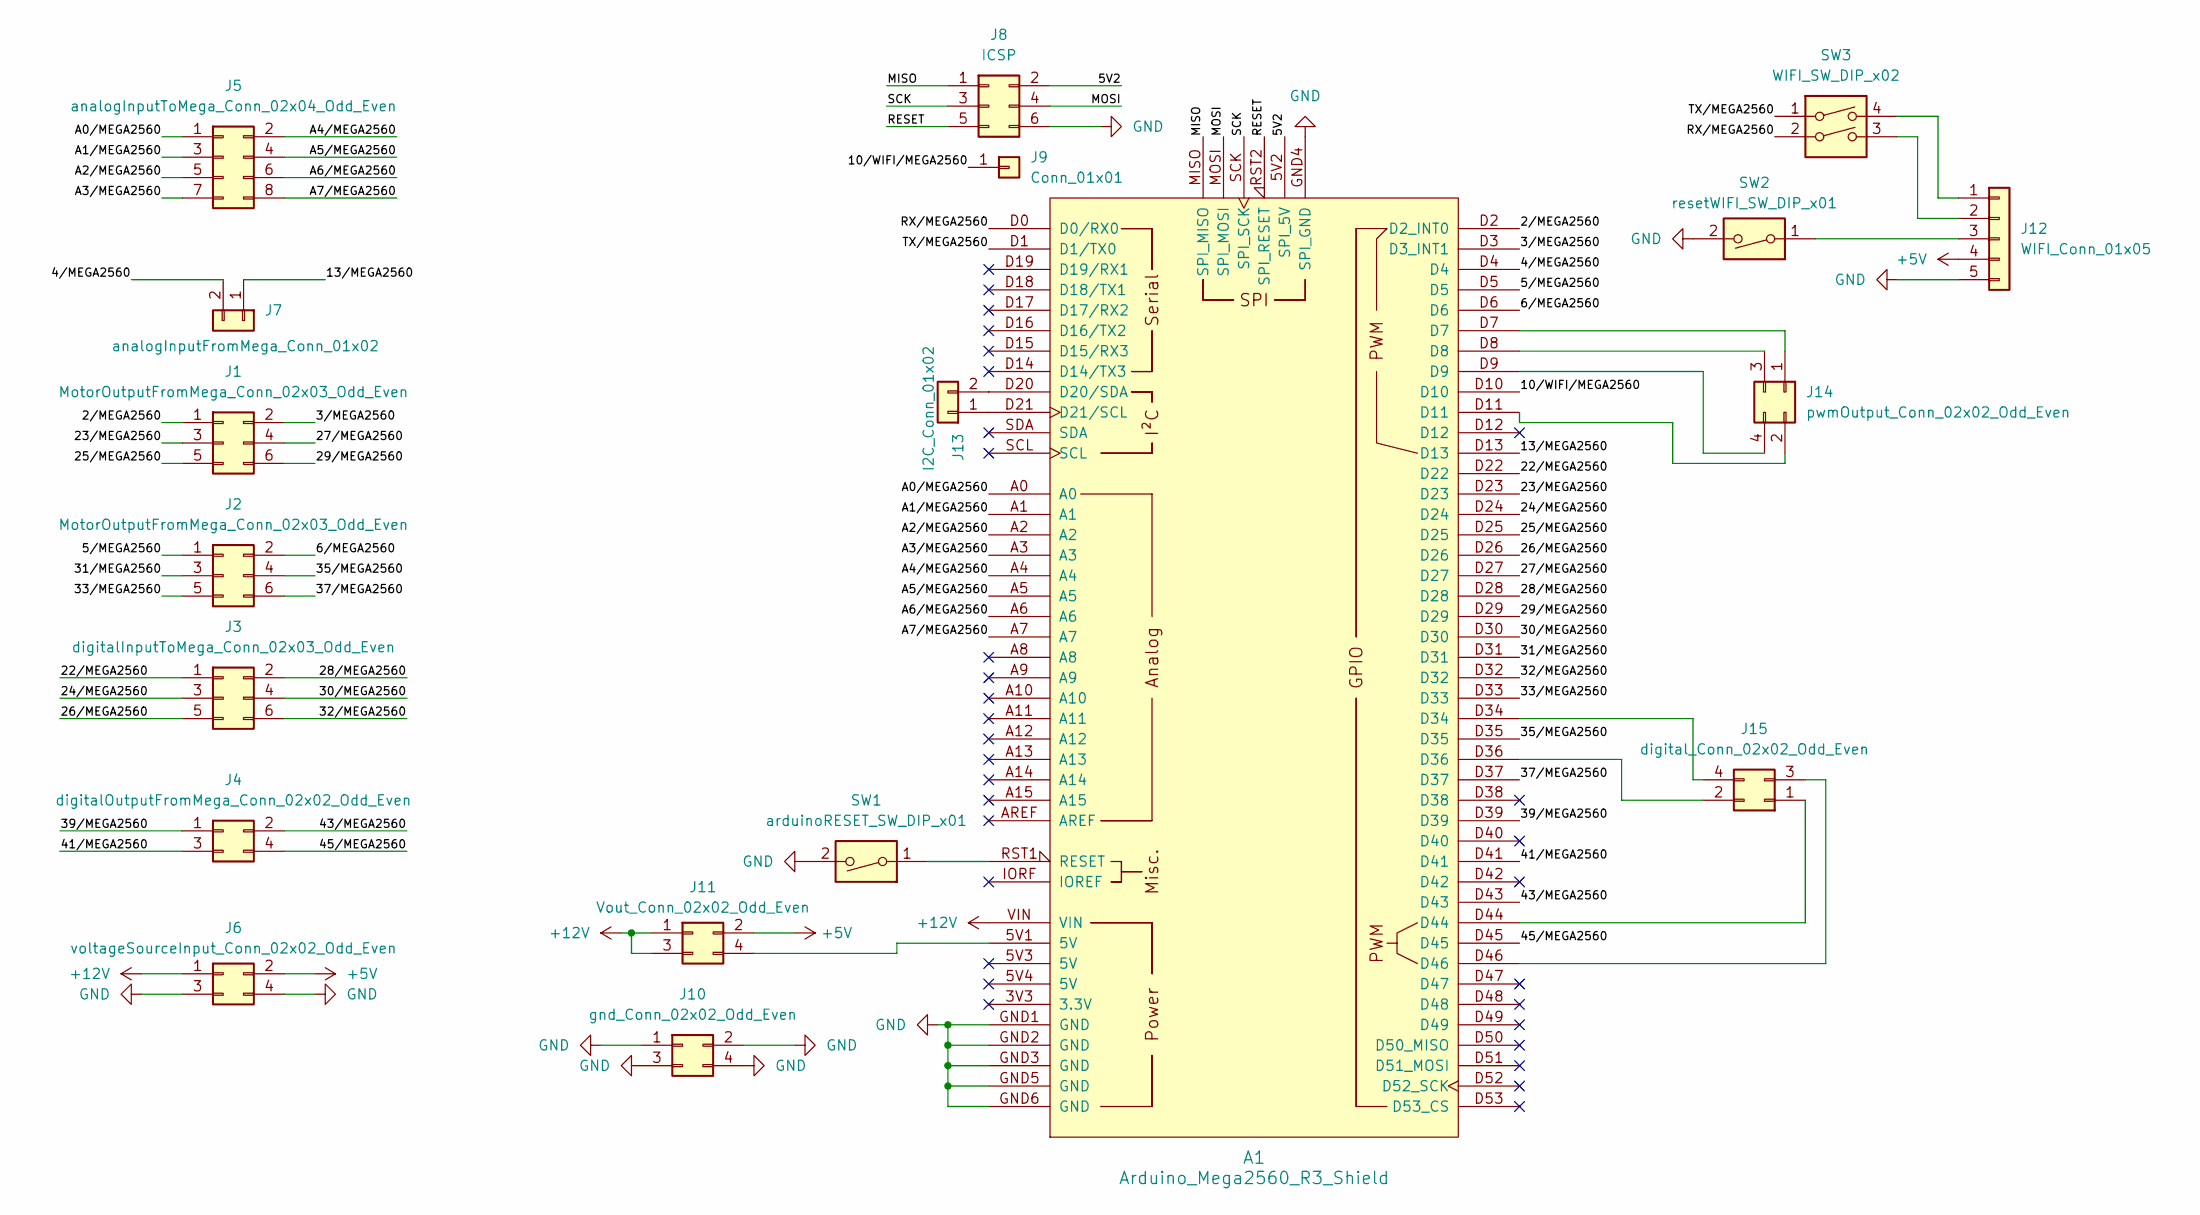
[picture p138: schematic schematicShieldPLC_V0.3.kicad_sch]

Parts:
A1: Arduino_Mega2560_R3_Shield
J1, J2: MotorOutputFromMega_Conn_02x03_Odd_Even; PinSocket_2x03_P2.54mm_Vertical
J3: digitalInputToMega_Conn_02x03_Odd_Even; PinSocket_2x03_P2.54mm_Vertical
J4: digitalOutputFromMega_Conn_02x02_Odd_Even; PinSocket_2x02_P2.54mm_Vertical
J5: analogInputToMega_Conn_02x04_Odd_Even; PinSocket_2x04_P2.54mm_Vertical
J6: voltageSourceInput_Conn_02x02_Odd_Even; PinSocket_2x02_P2.54mm_Vertical
J7: analogInputFromMega_Conn_01x02; PinSocket_1x02_P2.54mm_Vertical
J8: ICSP; PinSocket_2x03_P2.54mm_Vertical
J9: Conn_01x01; PinSocket_1x01_P2.54mm_Vertical
J10: gnd_Conn_02x02_Odd_Even; PinSocket_2x02_P2.54mm_Vertical
J11: Vout_Conn_02x02_Odd_Even; PinSocket_2x02_P2.54mm_Vertical
J12: WIFI_Conn_01x05; PinSocket_1x05_P2.54mm_Vertical
J13: I2C_Conn_01x02; PinSocket_1x02_P2.54mm_Horizontal
J14: pwmOutput_Conn_02x02_Odd_Even; PinSocket_2x02_P2.54mm_Vertical
J15: digital_Conn_02x02_Odd_Even; PinSocket_2x02_P2.54mm_Horizontal
SW1: arduinoRESET_SW_DIP_x01; SW_DIP_SPSTx01_Slide_9.78x4.72mm_W7.62mm_P2.54mm
SW2: resetWIFI_SW_DIP_x01; SW_DIP_SPSTx01_Slide_9.78x4.72mm_W7.62mm_P2.54mm
SW3: WIFI_SW_DIP_x02; SW_DIP_SPSTx02_Slide_9.78x7.26mm_W7.62mm_P2.54mm

Connections:
+5V: J6.2, J11.2, J12.4
+12V: A1.VIN, J6.1, J11.1, J11.3
/2/MEGA2560: A1.D2 (D2_INT0), J1.1
/3/MEGA2560: A1.D3 (D3_INT1), J1.2
/4/MEGA2560: A1.D4, J7.2
/5V2: A1.5V2 (SPI_5V), J8.2
/5/MEGA2560: A1.D5, J2.1
/6/MEGA2560: A1.D6, J2.2
/10/WIFI/MEGA2560: A1.D10, J9.1
/13/MEGA2560: A1.D13, J7.1
/22/MEGA2560: A1.D22, J3.1
/23/MEGA2560: A1.D23, J1.3
/24/MEGA2560: A1.D24, J3.3
/25/MEGA2560: A1.D25, J1.5
/26/MEGA2560: A1.D26, J3.5
/27/MEGA2560: A1.D27, J1.4
/28/MEGA2560: A1.D28, J3.2
/29/MEGA2560: A1.D29, J1.6
/30/MEGA2560: A1.D30, J3.4
/31/MEGA2560: A1.D31, J2.3
/32/MEGA2560: A1.D32, J3.6
/33/MEGA2560: A1.D33, J2.5
/35/MEGA2560: A1.D35, J2.4
/37/MEGA2560: A1.D37, J2.6
/39/MEGA2560: A1.D39, J4.1
/41/MEGA2560: A1.D41, J4.3
/43/MEGA2560: A1.D43, J4.2
/45/MEGA2560: A1.D45, J4.4
/A0/MEGA2560: A1.A0, J5.1
/A1/MEGA2560: A1.A1, J5.3
/A2/MEGA2560: A1.A2, J5.5
/A3/MEGA2560: A1.A3, J5.7
/A4/MEGA2560: A1.A4, J5.2
/A5/MEGA2560: A1.A5, J5.4
/A6/MEGA2560: A1.A6, J5.6
/A7/MEGA2560: A1.A7, J5.8
/MISO: A1.MISO (SPI_MISO), J8.1
/MOSI: A1.MOSI (SPI_MOSI), J8.4
/RESET: A1.RST2 (SPI_RESET), J8.5
/RX/MEGA2560: A1.D0 (D0/RX0), SW3.2
/SCK: A1.SCK (SPI_SCK), J8.3
/TX/MEGA2560: A1.D1 (D1/TX0), SW3.1
GND: A1.GND1 (GND), A1.GND2 (GND), A1.GND3 (GND), A1.GND4 (SPI_GND), A1.GND5 (GND), A1.GND6 (GND), J6.3, J6.4, J8.6, J10.1, J10.2, J10.3, J10.4, J12.5, SW1.2, SW2.2
unnamed: A1.D20 (D20/SDA), J13.2
unnamed: A1.D21 (D21/SCL), J13.1
unnamed: A1.RST1 (RESET), SW1.1
unnamed: A1.5V1 (5V), J11.4
unnamed: J12.1, SW3.4
unnamed: J12.2, SW3.3
unnamed: J12.3, SW2.1
unnamed: A1.D7, J14.1
unnamed: A1.D11, J14.2
unnamed: A1.D8, J14.3
unnamed: A1.D9, J14.4
unnamed: A1.D44, J15.1
unnamed: A1.D36, J15.2
unnamed: A1.D46, J15.3
unnamed: A1.D34, J15.4

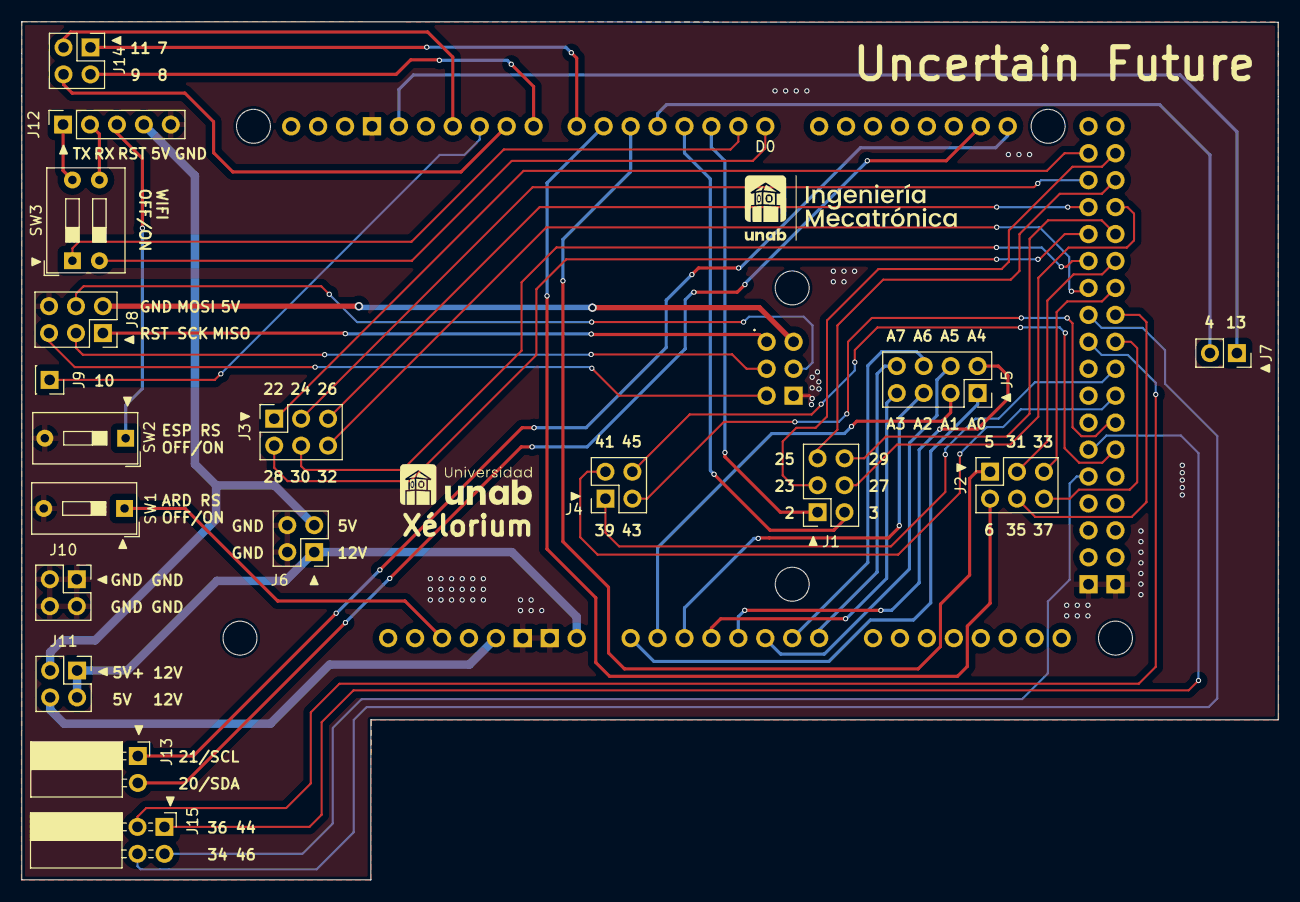
[picture p139: board schematicShieldPLC_V0.3.kicad_pcb from above]

Board: 2 copper layers, 118.5 x 80.9 mm, 19 parts (0 on the bottom side), 58 nets.
