nxvxr14/control-celda-fts-mecatronica-UNAB/Electronica/PCB Desings/schematicPLC_V0.1/schematicPLC_V0.1.kicad_pcb

## KiCad design Electronica/PCB Desings/schematicPLC_V0.1/schematicPLC_V0.1.kicad_pcb (2025-11-04)

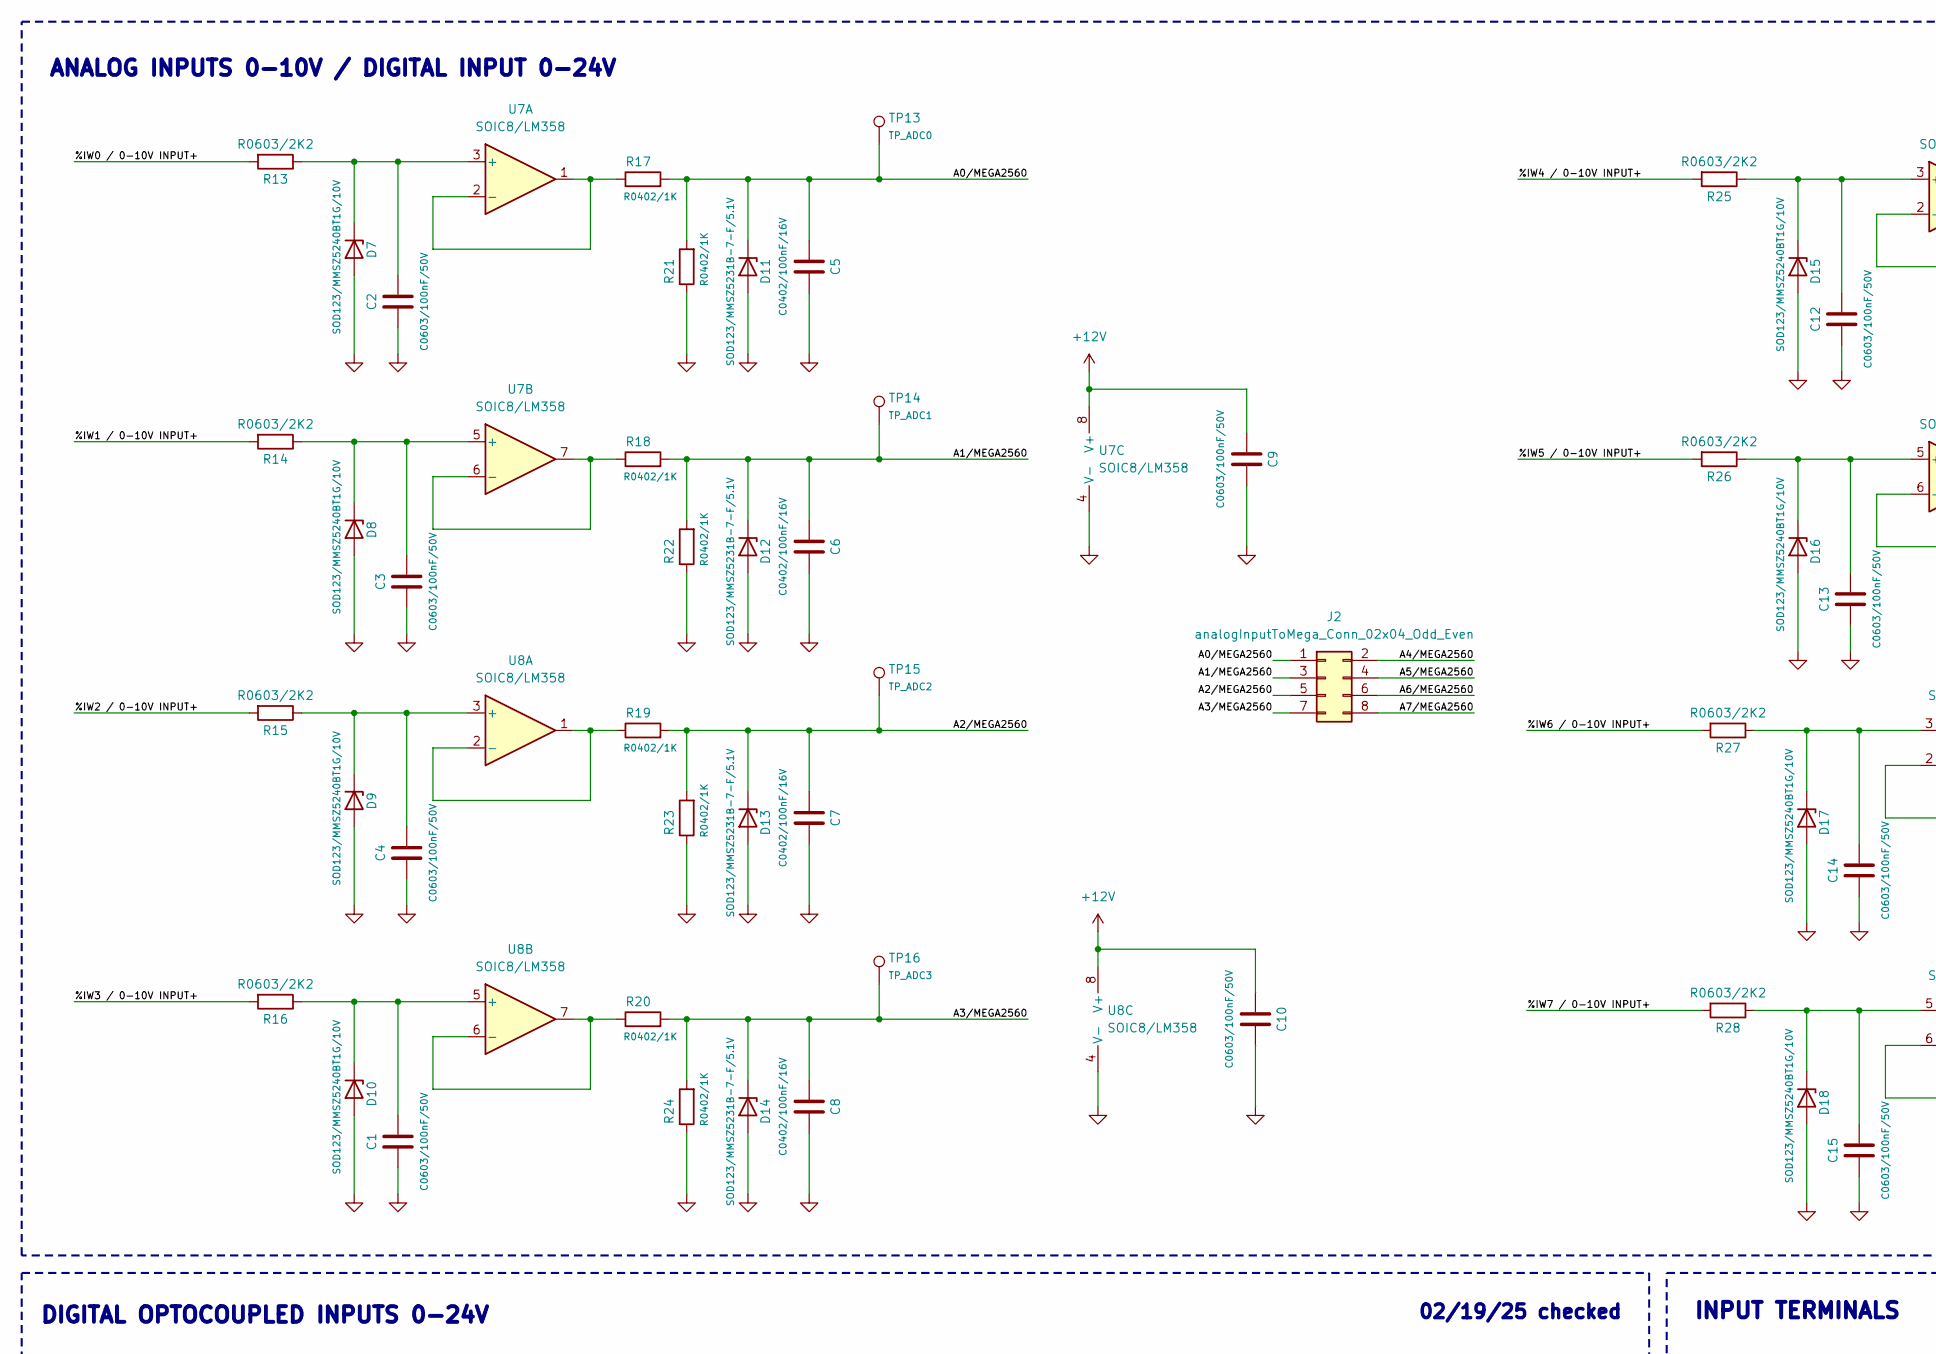
[picture p140: schematic schematicPLC_V0.1.kicad_sch, Xélorium, part in row 1, column 1]

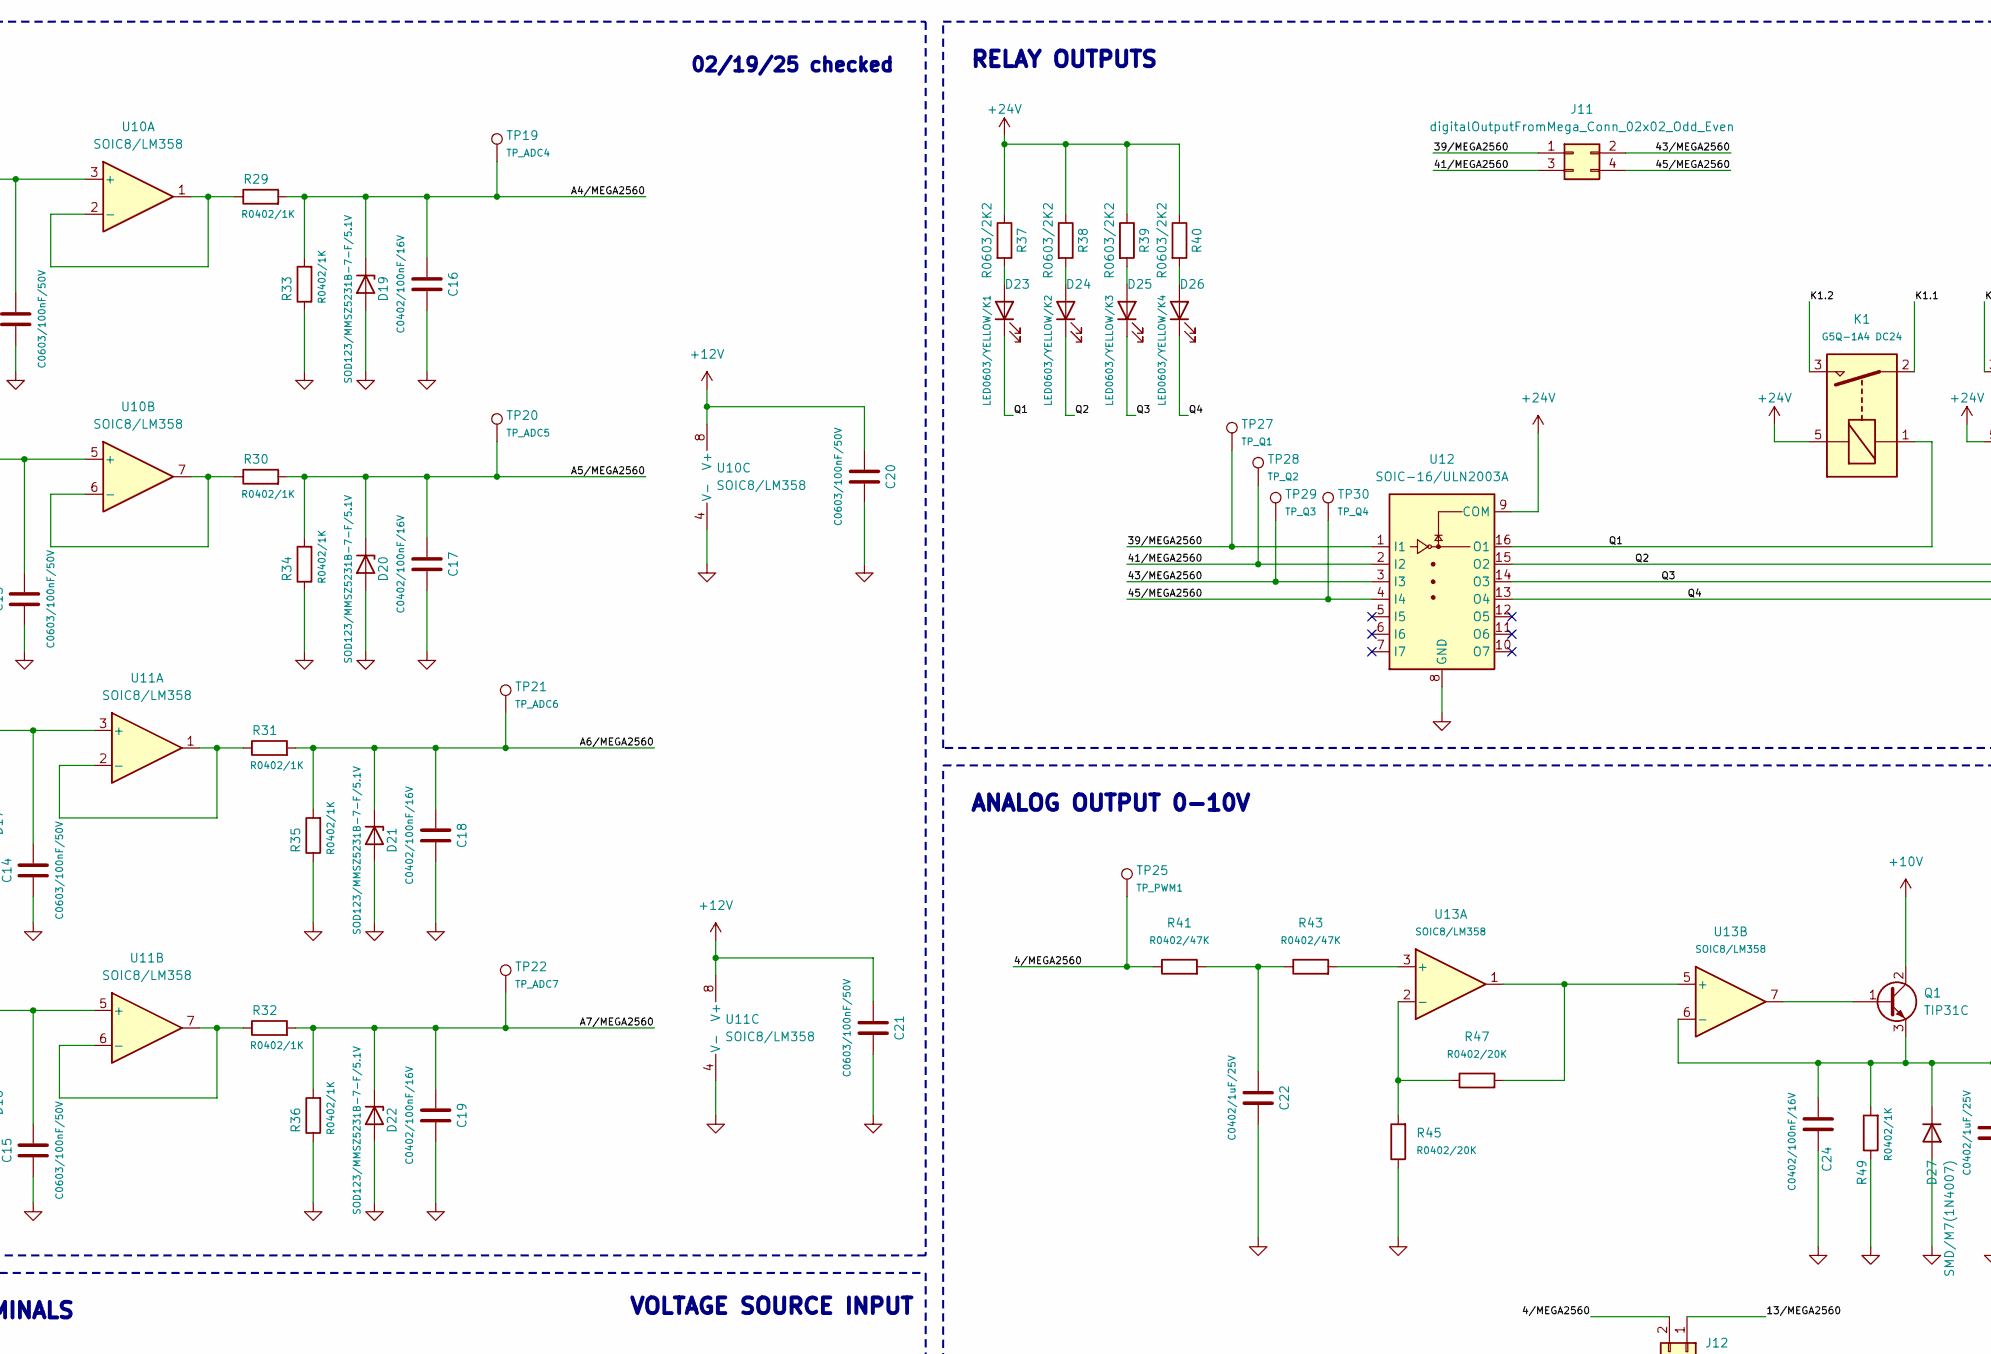
[picture p141: schematic schematicPLC_V0.1.kicad_sch, Xélorium, part in row 1, column 2]

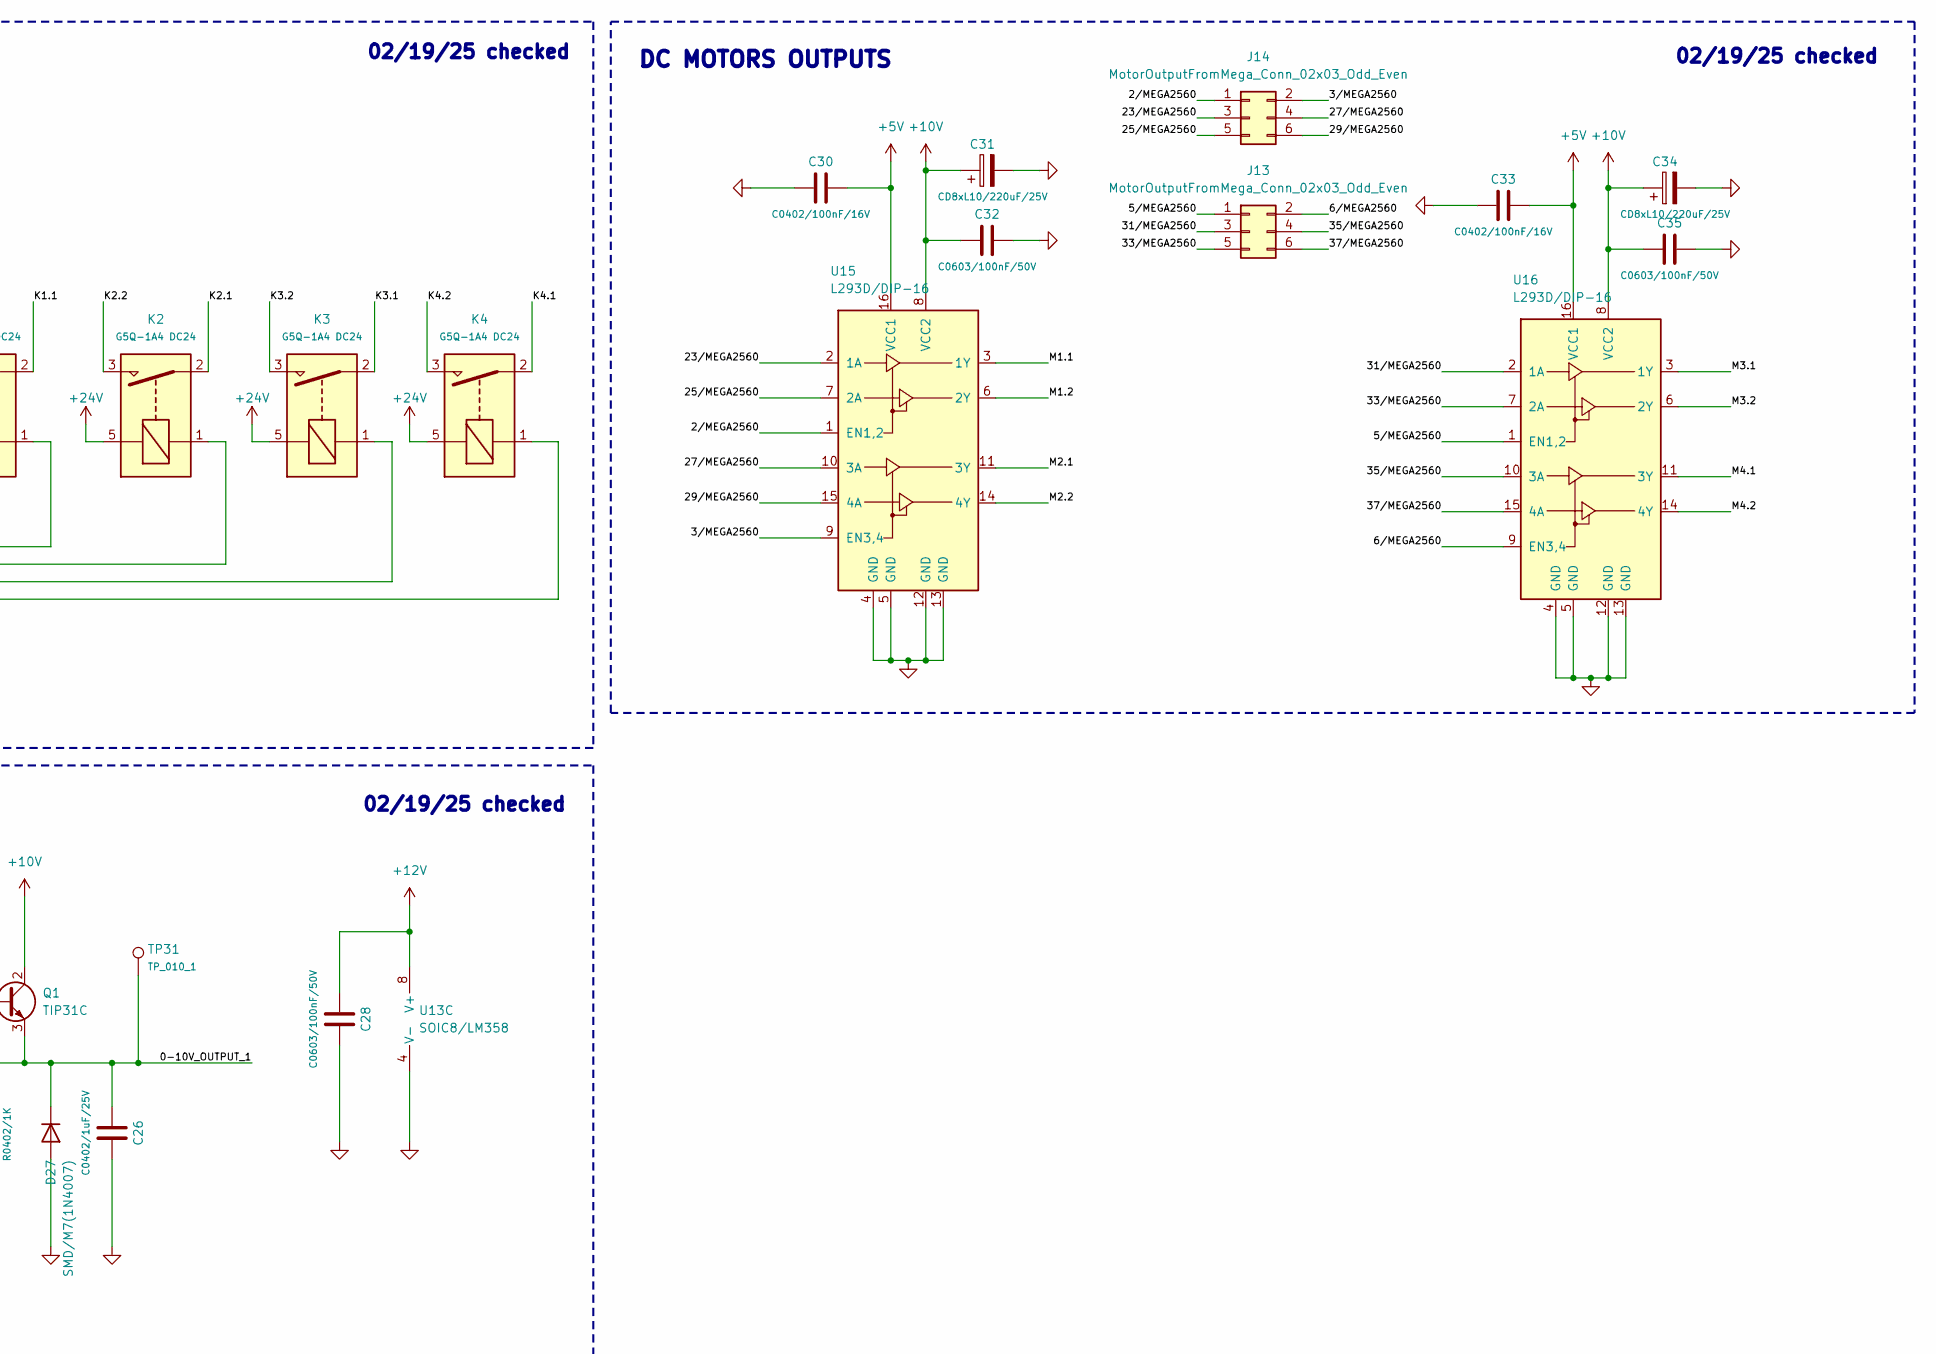
[picture p142: schematic schematicPLC_V0.1.kicad_sch, Xélorium, part in row 1, column 3]

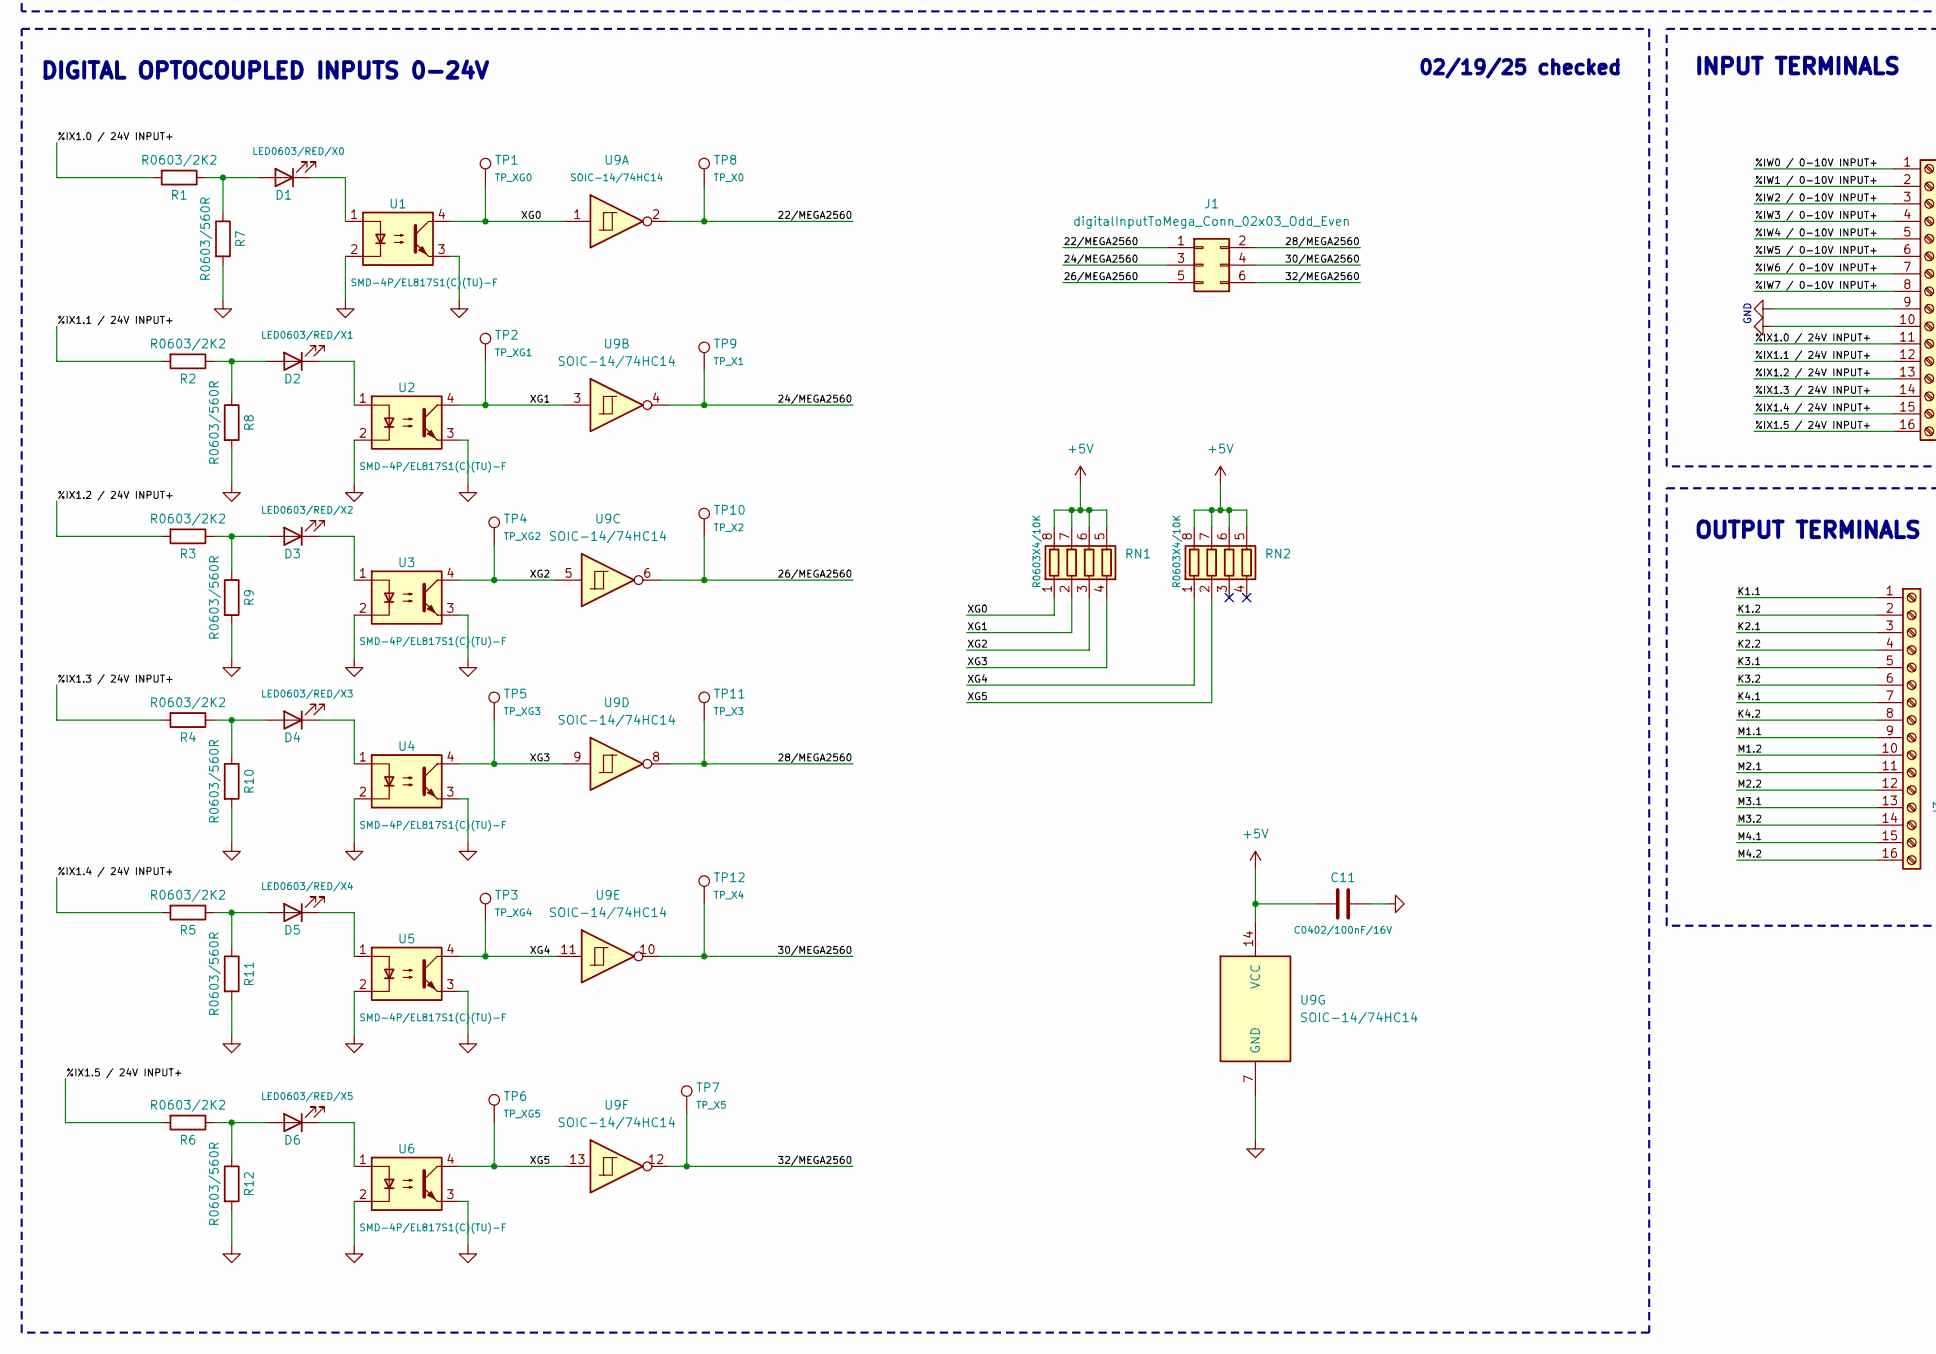
[picture p143: schematic schematicPLC_V0.1.kicad_sch, Xélorium, part in row 2, column 1]

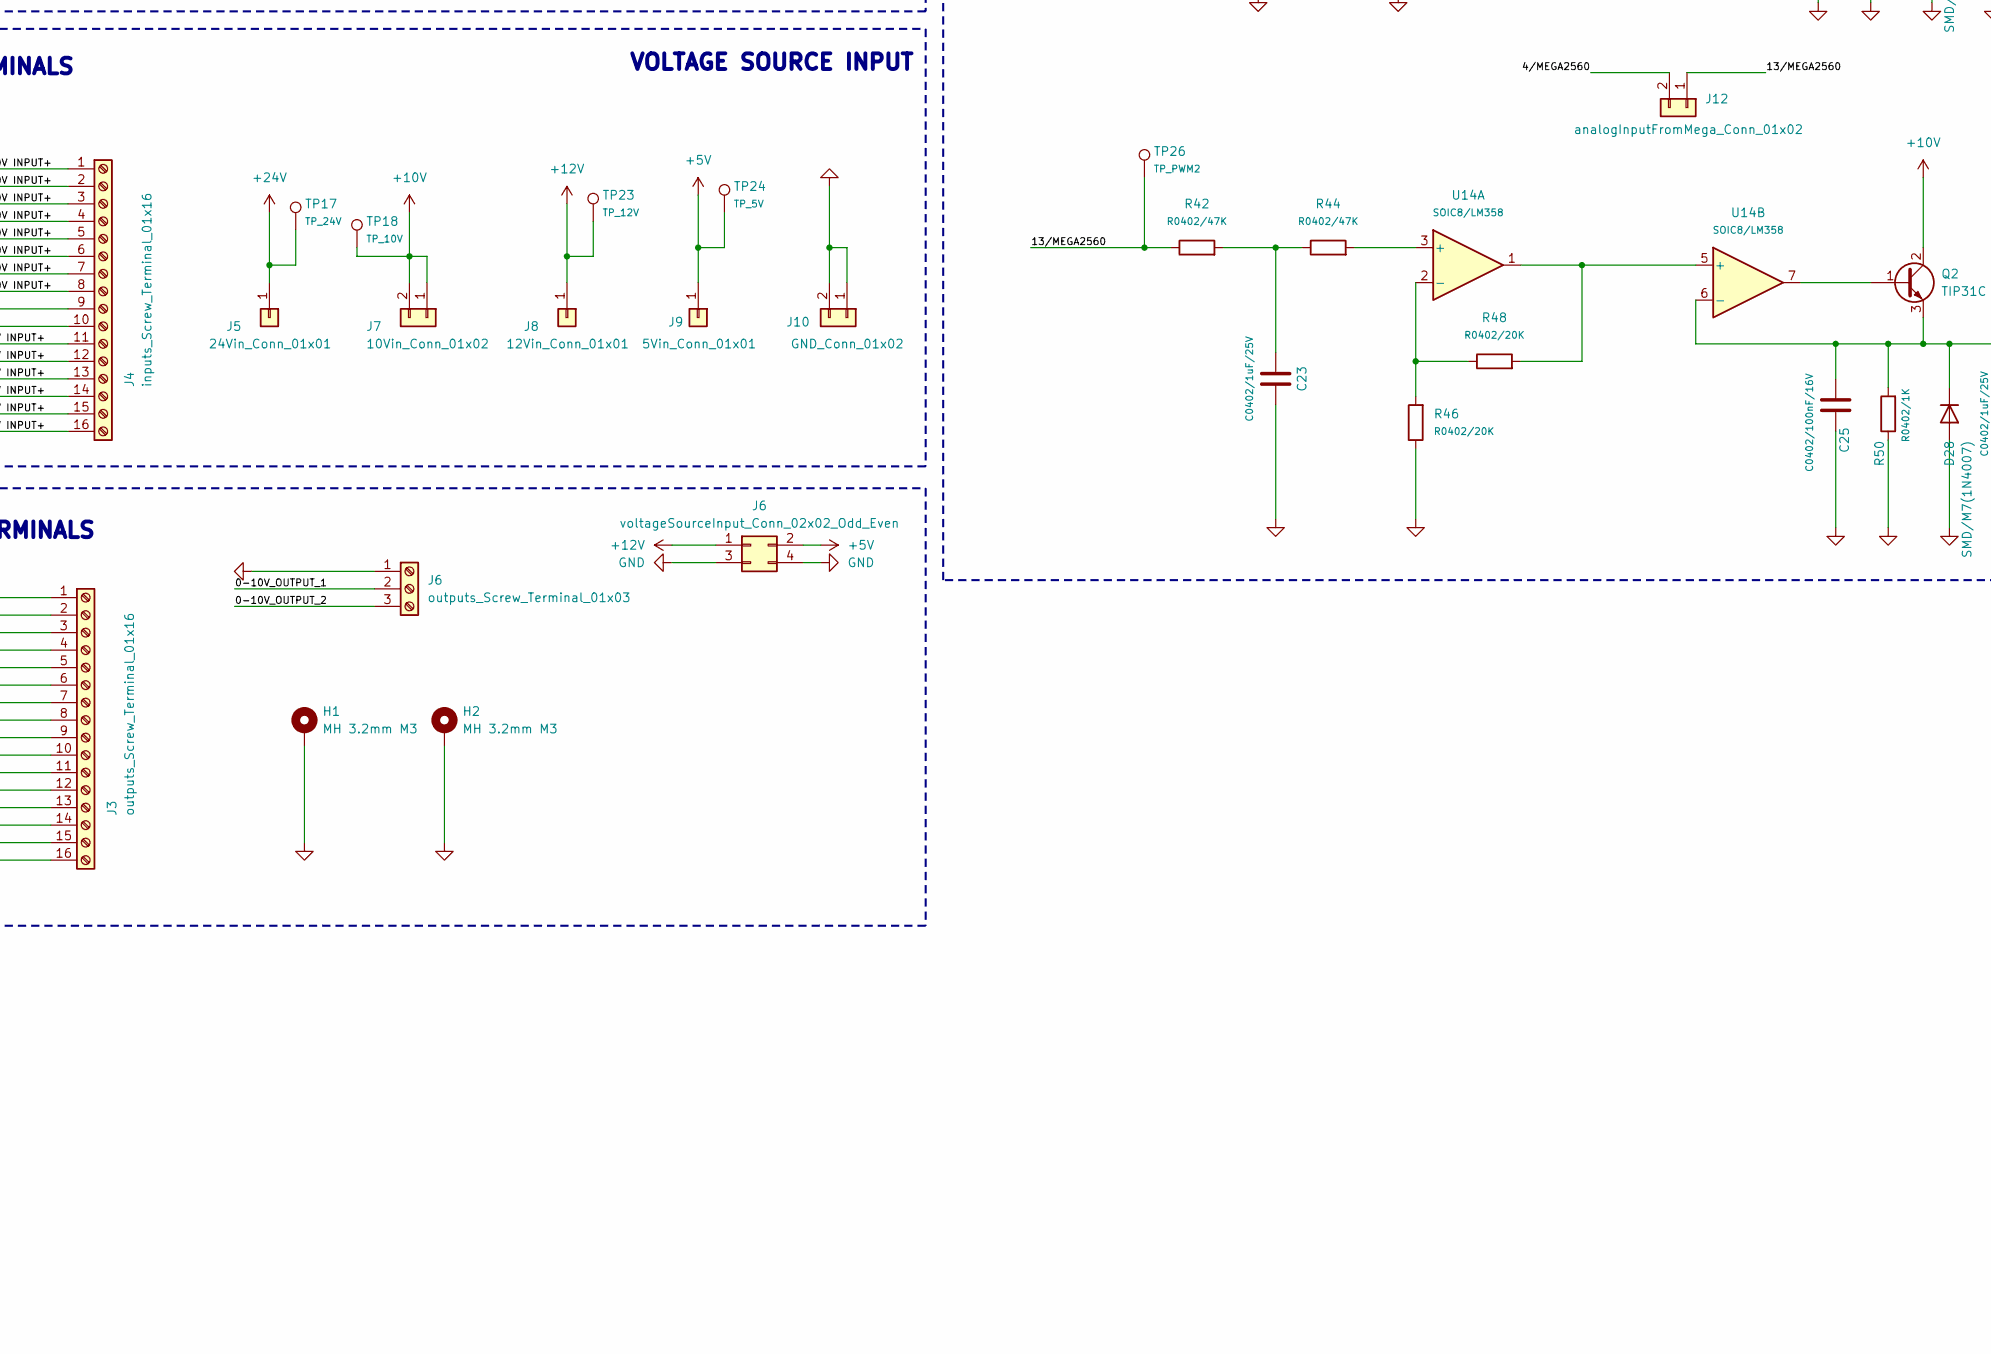
[picture p144: schematic schematicPLC_V0.1.kicad_sch, Xélorium, part in row 2, column 2]

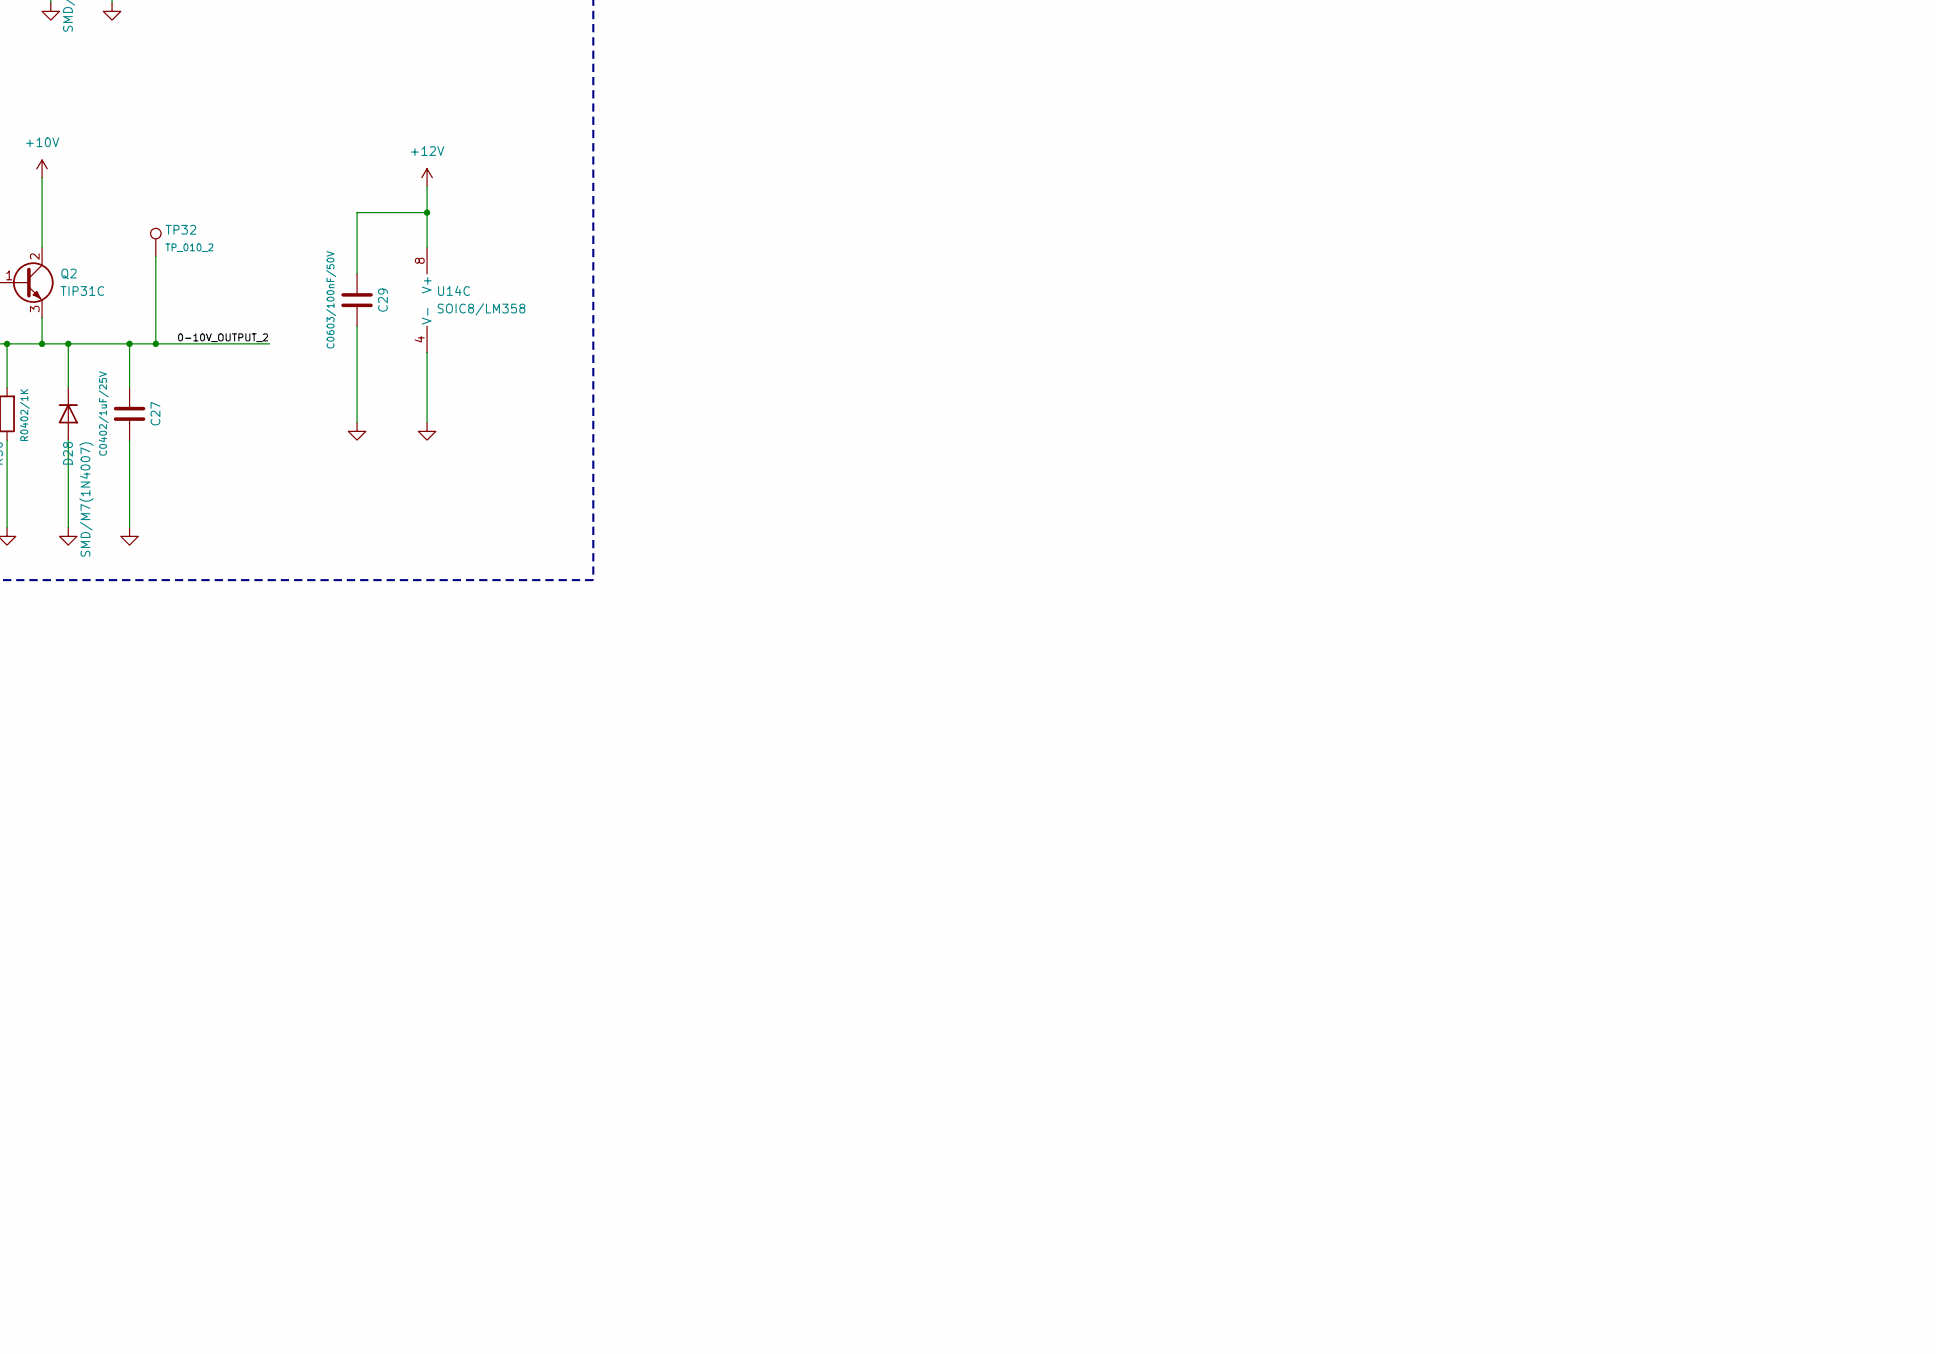
[picture p145: schematic schematicPLC_V0.1.kicad_sch, Xélorium, part in row 2, column 3]

Parts:
C1, C2, C3, C4, C9, C10, C12, C13, C14, C15, C20, C21, C28, C29, C32, C35: C0603/100nF/50V; C_0603_1608Metric; LCSC C14663
C5, C6, C7, C8, C11, C16, C17, C18, C19, C24, C25, C30, C33: C0402/100nF/16V; C_0402_1005Metric; LCSC C1525
C22, C23, C26, C27: C0402/1uF/25V; C_0402_1005Metric; LCSC C52923
C31, C34: CD8xL10/220uF/25V; CP_Elec_8x10; LCSC C178279
D1: LED0603/RED/X0; LED_0603_1608Metric; LCSC C2286
D2: LED0603/RED/X1; LED_0603_1608Metric; LCSC C2286
D3: LED0603/RED/X2; LED_0603_1608Metric; LCSC C2286
D4: LED0603/RED/X3; LED_0603_1608Metric; LCSC C2286
D5: LED0603/RED/X4; LED_0603_1608Metric; LCSC C2286
D6: LED0603/RED/X5; LED_0603_1608Metric; LCSC C2286
D7, D8, D9, D10, D15, D16, D17, D18: SOD123/MMSZ5240BT1G/10V; D_SOD-123; LCSC C82084
D11, D12, D13, D14, D19, D20, D21, D22: SOD123/MMSZ5231B-7-F/5.1V; D_SOD-123; LCSC C85181
D23: LED0603/YELLOW/K1; LED_0603_1608Metric; LCSC C72038
D24: LED0603/YELLOW/K2; LED_0603_1608Metric; LCSC C72038
D25: LED0603/YELLOW/K3; LED_0603_1608Metric; LCSC C72038
D26: LED0603/YELLOW/K4; LED_0603_1608Metric; LCSC C72038
D27, D28: SMD/M7(1N4007); D_SMA; LCSC C95872
H1, H2: MH 3.2mm M3; MountingHole_3.2mm_M3_Pad_Via
J1: digitalInputToMega_Conn_02x03_Odd_Even; PinHeader_2x03_P2.54mm_Vertical
J2: analogInputToMega_Conn_02x04_Odd_Even; PinHeader_2x04_P2.54mm_Vertical
J3: outputs_Screw_Terminal_01x16; TerminalBlock_Phoenix_MKDS-1,5-16_1x16_P5.00mm_Horizontal
J4: inputs_Screw_Terminal_01x16; TerminalBlock_Phoenix_MKDS-1,5-16_1x16_P5.00mm_Horizontal
J5: 24Vin_Conn_01x01; PinSocket_1x01_P2.54mm_Vertical
J6: voltageSourceInput_Conn_02x02_Odd_Even; PinHeader_2x02_P2.54mm_Vertical
J7: 10Vin_Conn_01x02; PinSocket_1x02_P2.54mm_Vertical
J8: 12Vin_Conn_01x01; PinSocket_1x01_P2.54mm_Vertical
J9: 5Vin_Conn_01x01; PinSocket_1x01_P2.54mm_Vertical
J10: GND_Conn_01x02; PinSocket_1x02_P2.54mm_Vertical
J11: digitalOutputFromMega_Conn_02x02_Odd_Even; PinHeader_2x02_P2.54mm_Vertical
J12: analogInputFromMega_Conn_01x02; PinHeader_1x02_P2.54mm_Vertical
J13, J14: MotorOutputFromMega_Conn_02x03_Odd_Even; PinHeader_2x03_P2.54mm_Vertical
K1, K2, K3, K4: G5Q-1A4 DC24; Relay_SPST_Omron-G5Q-1A; LCSC C89311
Q1, Q2: TIP31C; TO-220-3_Vertical; LCSC C963401
R1, R2, R3, R4, R5, R6, R13, R14, R15, R16, R25, R26, R27, R28, R37, R38, R39, R40: R0603/2K2; R_0603_1608Metric; LCSC C4190
R7, R8, R9, R10, R11, R12: R0603/560R; R_0603_1608Metric; LCSC C23204
R17, R18, R19, R20, R21, R22, R23, R24, R29, R30, R31, R32, R33, R34, R35, R36, R49, R50: R0402/1K; R_0402_1005Metric; LCSC C11702
R41, R42, R43, R44: R0402/47K; R_0402_1005Metric; LCSC C25792
R45, R46, R47, R48: R0402/20K; R_0402_1005Metric; LCSC C25765
RN1, RN2: R0603X4/10K; R_Array_Concave_4x0603; LCSC C29718
TP1: TP_XG0; TestPoint_THTPad_D1.0mm_Drill0.5mm
TP2: TP_XG1; TestPoint_THTPad_D1.0mm_Drill0.5mm
TP3: TP_XG4; TestPoint_THTPad_D1.0mm_Drill0.5mm
TP4: TP_XG2; TestPoint_THTPad_D1.0mm_Drill0.5mm
TP5: TP_XG3; TestPoint_THTPad_D1.0mm_Drill0.5mm
TP6: TP_XG5; TestPoint_THTPad_D1.0mm_Drill0.5mm
TP7: TP_X5; TestPoint_THTPad_D1.0mm_Drill0.5mm
TP8: TP_X0; TestPoint_THTPad_D1.0mm_Drill0.5mm
TP9: TP_X1; TestPoint_THTPad_D1.0mm_Drill0.5mm
TP10: TP_X2; TestPoint_THTPad_D1.0mm_Drill0.5mm
TP11: TP_X3; TestPoint_THTPad_D1.0mm_Drill0.5mm
TP12: TP_X4; TestPoint_THTPad_D1.0mm_Drill0.5mm
TP13: TP_ADC0; TestPoint_THTPad_D1.0mm_Drill0.5mm
TP14: TP_ADC1; TestPoint_THTPad_D1.0mm_Drill0.5mm
TP15: TP_ADC2; TestPoint_THTPad_D1.0mm_Drill0.5mm
TP16: TP_ADC3; TestPoint_THTPad_D1.0mm_Drill0.5mm
TP17: TP_24V; TestPoint_THTPad_D1.0mm_Drill0.5mm
TP18: TP_10V; TestPoint_THTPad_D1.0mm_Drill0.5mm
TP19: TP_ADC4; TestPoint_THTPad_D1.0mm_Drill0.5mm
TP20: TP_ADC5; TestPoint_THTPad_D1.0mm_Drill0.5mm
TP21: TP_ADC6; TestPoint_THTPad_D1.0mm_Drill0.5mm
TP22: TP_ADC7; TestPoint_THTPad_D1.0mm_Drill0.5mm
TP23: TP_12V; TestPoint_THTPad_D1.0mm_Drill0.5mm
TP24: TP_5V; TestPoint_THTPad_D1.0mm_Drill0.5mm
TP25: TP_PWM1; TestPoint_THTPad_D1.0mm_Drill0.5mm
TP26: TP_PWM2; TestPoint_THTPad_D1.0mm_Drill0.5mm
TP27: TP_Q1; TestPoint_THTPad_D1.0mm_Drill0.5mm
TP28: TP_Q2; TestPoint_THTPad_D1.0mm_Drill0.5mm
TP29: TP_Q3; TestPoint_THTPad_D1.0mm_Drill0.5mm
TP30: TP_Q4; TestPoint_THTPad_D1.0mm_Drill0.5mm
TP31: TP_010_1; TestPoint_THTPad_D1.0mm_Drill0.5mm
TP32: TP_010_2; TestPoint_THTPad_D1.0mm_Drill0.5mm
U1, U2, U3, U4, U5, U6: SMD-4P/EL817S1(C)(TU)-F; SMDIP-4_W9.53mm; LCSC C106900
U7, U8, U10, U11, U13, U14: SOIC8/LM358; SOIC-8_3.9x4.9mm_P1.27mm; LCSC C7950
U9: SOIC-14/74HC14; SOIC-14_3.9x8.7mm_P1.27mm; LCSC C5605
U12: SOIC-16/ULN2003A; SOIC-16_3.9x9.9mm_P1.27mm; LCSC C7512
U15, U16: L293D/DIP-16; DIP-16_W7.62mm; LCSC C12340

Connections:
+10V: C31.1, C32.1, C34.1, C35.1, J7.1, J7.2, Q1.2 (C), Q2.2 (C), TP18.1, U15.8 (VCC2), U16.8 (VCC2)
+24V: J5.1, K1.5, K2.5, K3.5, K4.5, R37.1, R38.1, R39.1, R40.1, TP17.1, U12.9 (COM)
/2/MEGA2560: J14.1, U15.1 (EN1,2)
/3/MEGA2560: J14.2, U15.9 (EN3,4)
/4/MEGA2560: J12.2, R41.1, TP25.1
/5/MEGA2560: J13.1, U16.1 (EN1,2)
/6/MEGA2560: J13.2, U16.9 (EN3,4)
/13/MEGA2560: J12.1, R42.1, TP26.1
/22/MEGA2560: J1.1, TP8.1, U9.2
/23/MEGA2560: J14.3, U15.2 (1A)
/24/MEGA2560: J1.3, TP9.1, U9.4
/25/MEGA2560: J14.5, U15.7 (2A)
/26/MEGA2560: J1.5, TP10.1, U9.6
/27/MEGA2560: J14.4, U15.10 (3A)
/28/MEGA2560: J1.2, TP11.1, U9.8
/29/MEGA2560: J14.6, U15.15 (4A)
/30/MEGA2560: J1.4, TP12.1, U9.10
/31/MEGA2560: J13.3, U16.2 (1A)
/32/MEGA2560: J1.6, TP7.1, U9.12
/33/MEGA2560: J13.5, U16.7 (2A)
/35/MEGA2560: J13.4, U16.10 (3A)
/37/MEGA2560: J13.6, U16.15 (4A)
/39/MEGA2560: J11.1, TP27.1, U12.1 (I1)
/41/MEGA2560: J11.3, TP28.1, U12.2 (I2)
/43/MEGA2560: J11.2, TP29.1, U12.3 (I3)
/45/MEGA2560: J11.4, TP30.1, U12.4 (I4)
/%IW0 / 0-10V INPUT+: J4.1, R13.2
/%IW1 / 0-10V INPUT+: J4.2, R14.2
/%IW2 / 0-10V INPUT+: J4.3, R15.2
/%IW3 / 0-10V INPUT+: J4.4, R16.2
/%IW4 / 0-10V INPUT+: J4.5, R25.2
/%IW5 / 0-10V INPUT+: J4.6, R26.2
/%IW6 / 0-10V INPUT+: J4.7, R27.2
/%IW7 / 0-10V INPUT+: J4.8, R28.2
/%IX1.0 / 24V INPUT+: J4.11, R1.2
/%IX1.1 / 24V INPUT+: J4.12, R2.2
/%IX1.2 / 24V INPUT+: J4.13, R3.2
/%IX1.3 / 24V INPUT+: J4.14, R4.2
/%IX1.4 / 24V INPUT+: J4.15, R5.2
/%IX1.5 / 24V INPUT+: J4.16, R6.2
/A0/MEGA2560: C5.1, D11.1 (K), J2.1, R17.2, R21.2, TP13.1
/A1/MEGA2560: C6.1, D12.1 (K), J2.3, R18.2, R22.2, TP14.1
/A2/MEGA2560: C7.1, D13.1 (K), J2.5, R19.2, R23.2, TP15.1
/A3/MEGA2560: C8.1, D14.1 (K), J2.7, R20.2, R24.2, TP16.1
/A4/MEGA2560: C16.1, D19.1 (K), J2.2, R29.2, R33.2, TP19.1
/A5/MEGA2560: C17.1, D20.1 (K), J2.4, R30.2, R34.2, TP20.1
/A6/MEGA2560: C18.1, D21.1 (K), J2.6, R31.2, R35.2, TP21.1
/A7/MEGA2560: C19.1, D22.1 (K), J2.8, R32.2, R36.2, TP22.1
/K1.1: J3.1, K1.2
/K1.2: J3.2, K1.3
/K2.1: J3.3, K2.2
/K2.2: J3.4, K2.3
/K3.1: J3.5, K3.2
/K3.2: J3.6, K3.3
/K4.1: J3.7, K4.2
/K4.2: J3.8, K4.3
/M1.1: J3.9, U15.3 (1Y)
/M1.2: J3.10, U15.6 (2Y)
/M2.1: J3.11, U15.11 (3Y)
/M2.2: J3.12, U15.14 (4Y)
/M3.1: J3.13, U16.3 (1Y)
/M3.2: J3.14, U16.6 (2Y)
/M4.1: J3.15, U16.11 (3Y)
/M4.2: J3.16, U16.14 (4Y)
/Q1: D23.1 (K), K1.1, U12.16 (O1)
/Q2: D24.1 (K), K2.1, U12.15 (O2)
/Q3: D25.1 (K), K3.1, U12.14 (O3)
/Q4: D26.1 (K), K4.1, U12.13 (O4)
/XG0: RN1.1 (R1.1), TP1.1, U1.4, U9.1
/XG1: RN1.2 (R2.1), TP2.1, U2.4, U9.3
/XG2: RN1.3 (R3.1), TP4.1, U3.4, U9.5
/XG3: RN1.4 (R4.1), TP5.1, U4.4, U9.9
/XG4: RN2.1 (R1.1), TP3.1, U5.4, U9.11
/XG5: RN2.2 (R2.1), TP6.1, U6.4, U9.13
unnamed: C22.1, R41.2, R43.1
unnamed: C23.1, R42.2, R44.1
unnamed: D1.2 (A), R1.1, R7.1
unnamed: D1.1 (K), U1.1
unnamed: D2.2 (A), R2.1, R8.1
unnamed: D2.1 (K), U2.1
unnamed: D3.2 (A), R3.1, R9.1
unnamed: D3.1 (K), U3.1
unnamed: D4.2 (A), R4.1, R10.1
unnamed: D4.1 (K), U4.1
unnamed: D5.2 (A), R5.1, R11.1
unnamed: D5.1 (K), U5.1
unnamed: D6.2 (A), R6.1, R12.1
unnamed: D6.1 (K), U6.1
unnamed: C2.2, D7.1 (K), R13.1, U7.3 (+)
unnamed: C3.2, D8.1 (K), R14.1, U7.5 (+)
unnamed: C4.2, D9.1 (K), R15.1, U8.3 (+)
unnamed: C1.2, D10.1 (K), R16.1, U8.5 (+)
unnamed: C12.2, D15.1 (K), R25.1, U10.3 (+)
unnamed: C13.2, D16.1 (K), R26.1, U10.5 (+)
unnamed: C14.2, D17.1 (K), R27.1, U11.3 (+)
unnamed: C15.2, D18.1 (K), R28.1, U11.5 (+)
unnamed: D23.2 (A), R37.2
unnamed: D24.2 (A), R38.2
unnamed: D25.2 (A), R39.2
unnamed: D26.2 (A), R40.2
unnamed: Q1.1 (B), U13.7
unnamed: Q2.1 (B), U14.7
unnamed: R17.1, U7.1, U7.2 (-)
unnamed: R18.1, U7.6 (-), U7.7
unnamed: R19.1, U8.1, U8.2 (-)
unnamed: R20.1, U8.6 (-), U8.7
unnamed: R29.1, U10.1, U10.2 (-)
unnamed: R30.1, U10.6 (-), U10.7
unnamed: R31.1, U11.1, U11.2 (-)
unnamed: R32.1, U11.6 (-), U11.7
unnamed: R43.2, U13.3 (+)
unnamed: R45.2, R47.1, U13.2 (-)
unnamed: R47.2, U13.1, U13.5 (+)
unnamed: R44.2, U14.3 (+)
unnamed: R46.2, R48.1, U14.2 (-)
unnamed: R48.2, U14.1, U14.5 (+)

Notes on the sheet:
DIGITAL OPTOCOUPLED INPUTS 0-24V
GND
02/19/25 checked
ANALOG OUTPUT 0-10V
RELAY OUTPUTS
INPUT TERMINALS
ANALOG INPUTS 0-10V / DIGITAL INPUT 0-24V
OUTPUT TERMINALS
DC MOTORS OUTPUTS
VOLTAGE SOURCE INPUT

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
