nxvxr14/control-celda-fts-mecatronica-UNAB/Electronica/PCB Desings/schematicPLC_V0.1/schematicPLC_V0.1.kicad_pcb

## KiCad design Electronica/PCB Desings/schematicPLC_V0.1/schematicPLC_V0.1.kicad_pcb (continued)

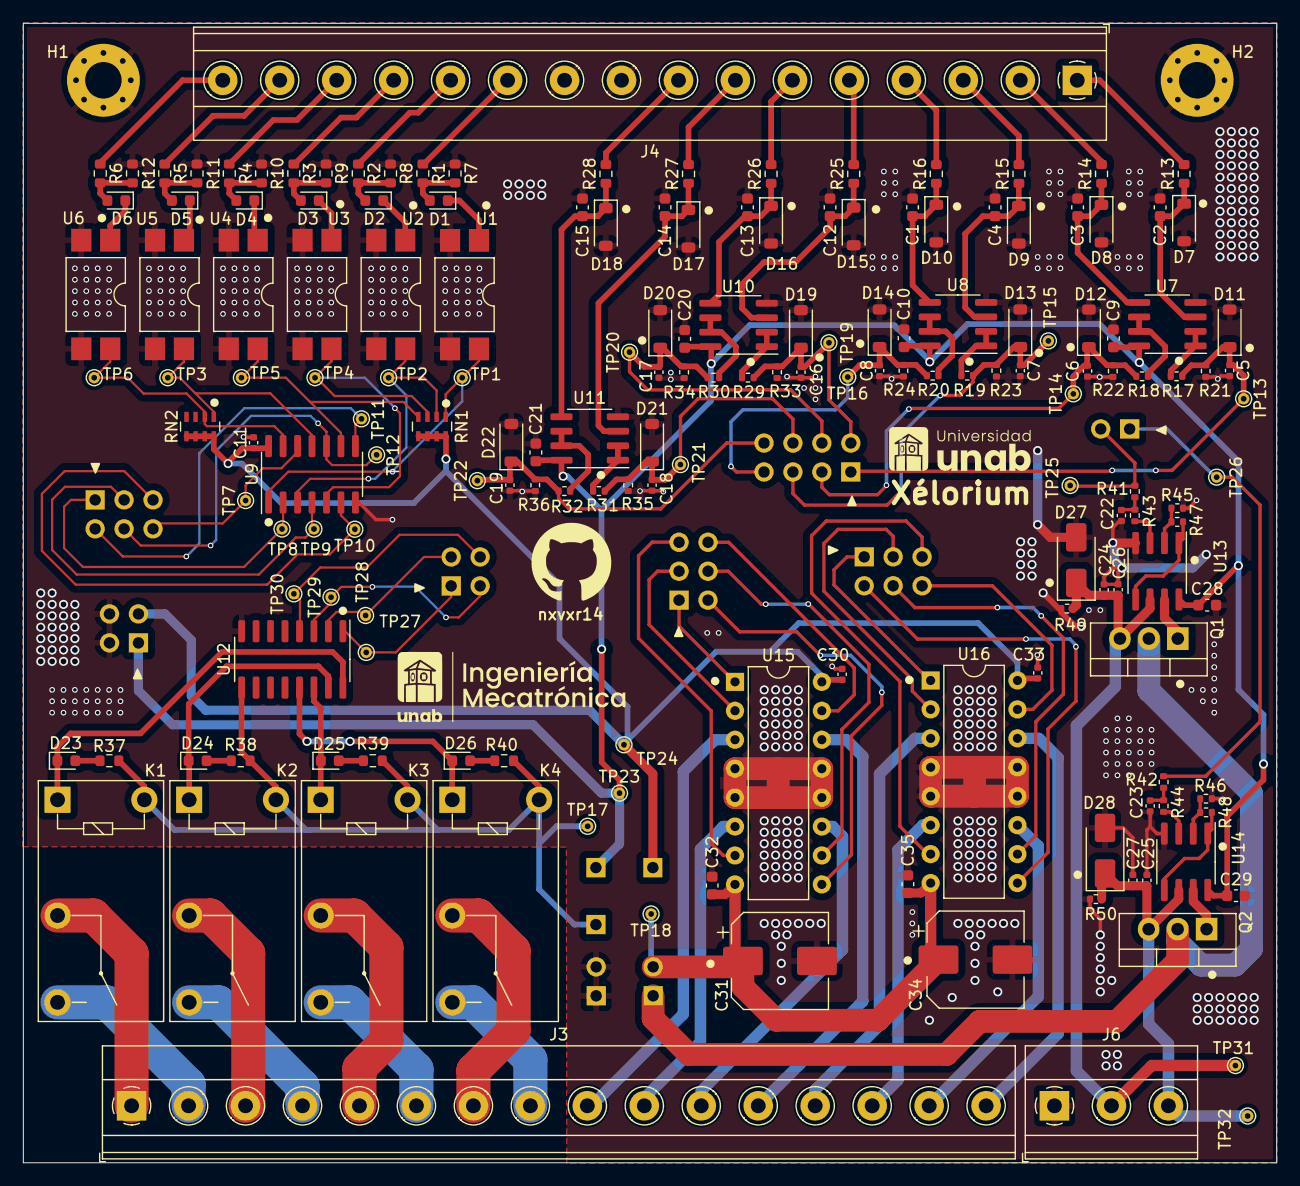
[picture p146: board schematicPLC_V0.1.kicad_pcb from above]

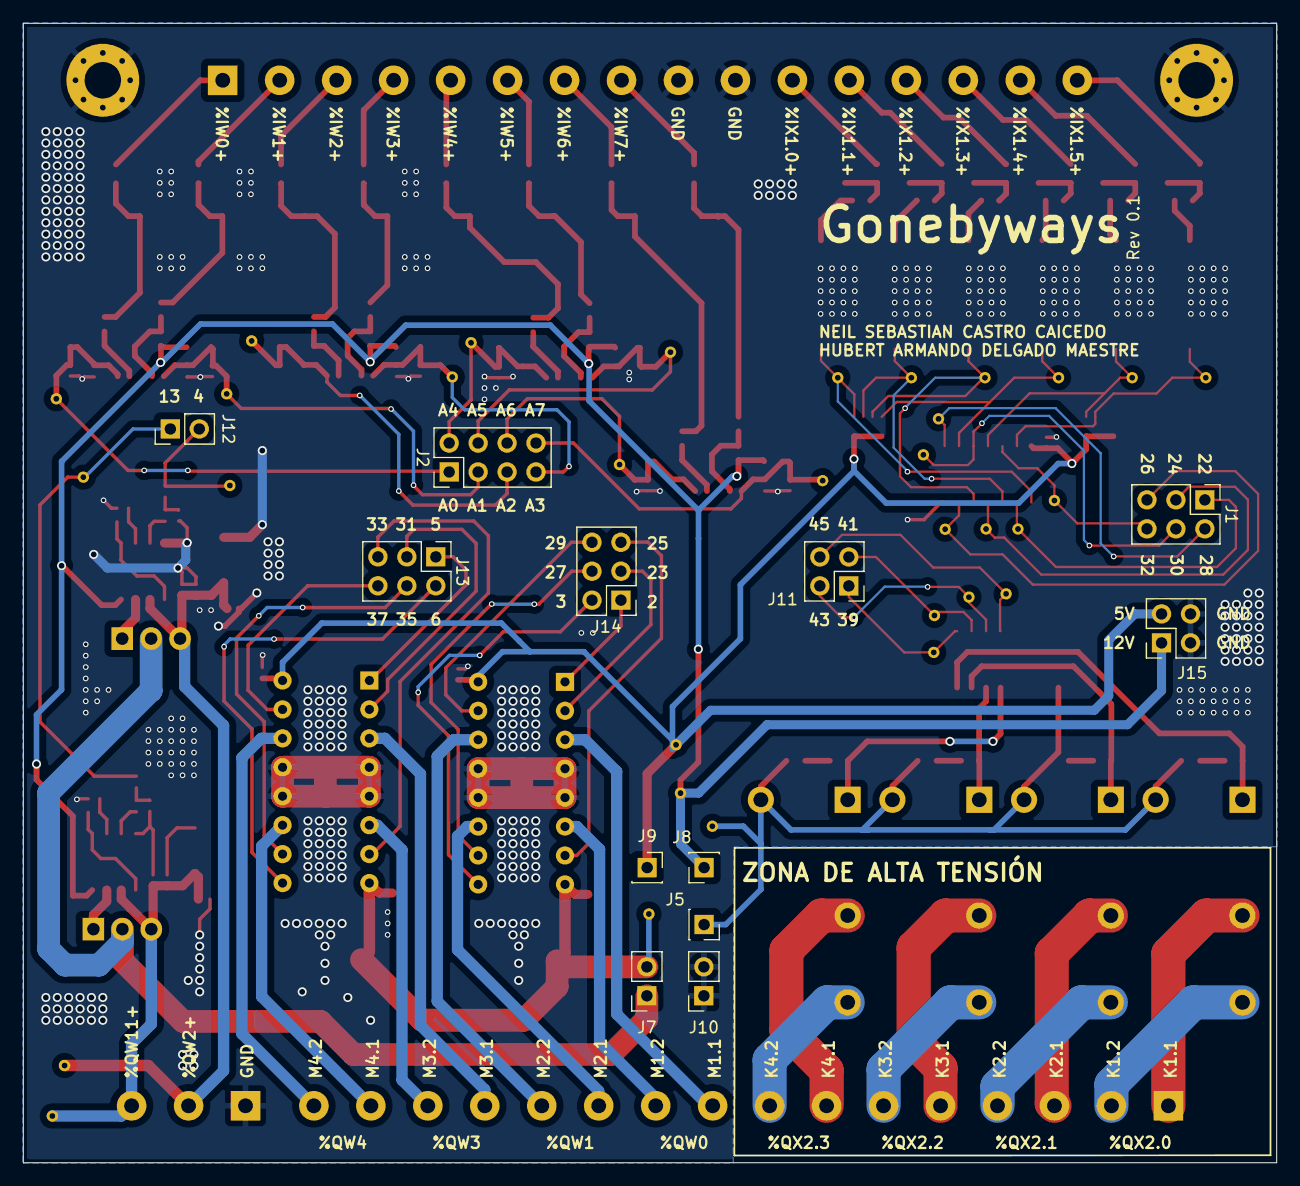
[picture p147: board schematicPLC_V0.1.kicad_pcb from below]

Board: 2 copper layers, 110.0 x 100.0 mm, 186 parts (12 on the bottom side), 121 nets.

Other parts of the board:
J15: voltageSourceInput_Conn_02x02_Odd_Even; PinHeader_2x02_P2.54mm_Vertical
