nxvxr14/control-celda-fts-mecatronica-UNAB/Electronica/PCB Desings/schematicPowerSourcePLC_V0.1/schematicPowerSourcePLC_V0.1.kicad_pcb

## KiCad design Electronica/PCB Desings/schematicPowerSourcePLC_V0.1/schematicPowerSourcePLC_V0.1.kicad_pcb (2025-11-04)

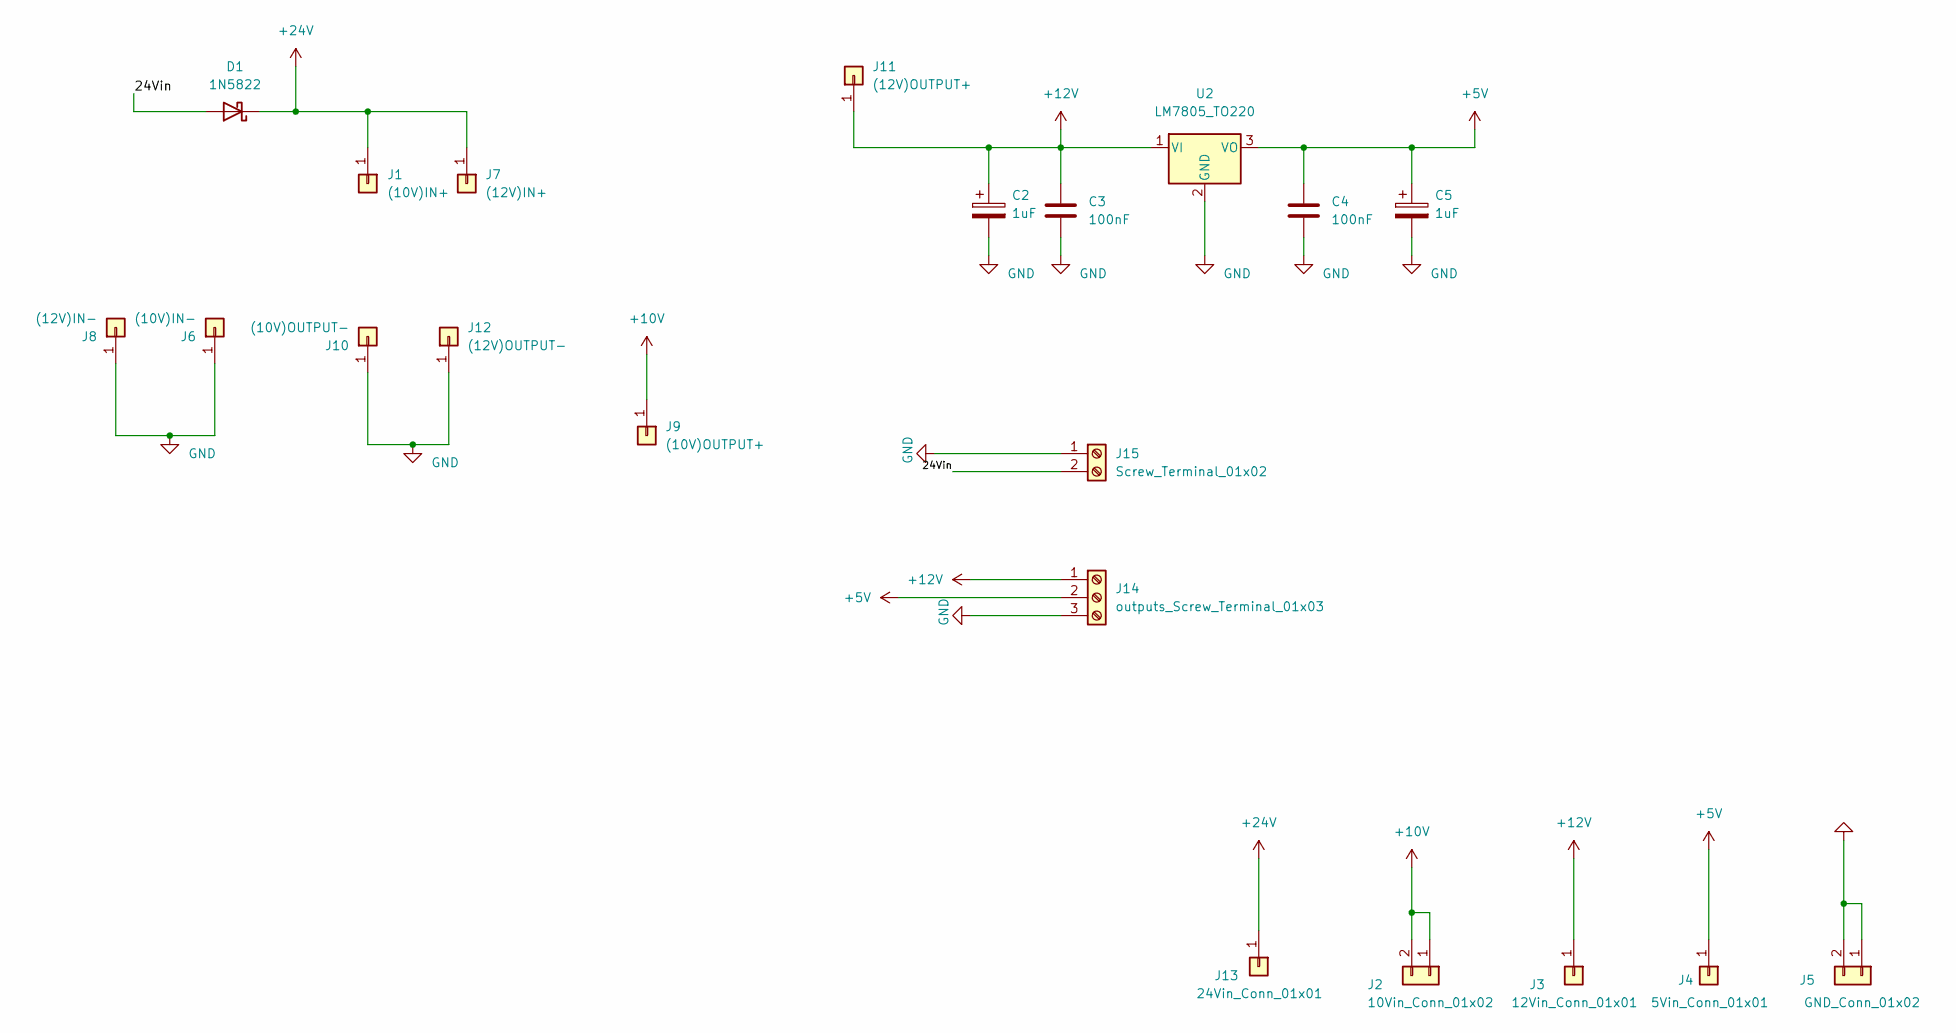
[picture p148: schematic schematicPowerSourcePLC_V0.1.kicad_sch]

Parts:
C2, C5: 1uF; CP_Radial_D5.0mm_P2.00mm
C3, C4: 100nF; C_Disc_D4.3mm_W1.9mm_P5.00mm
D1: 1N5822; D_DO-41_SOD81_P12.70mm_Horizontal
J1: (10V)IN+; PinHeader_1x01_P2.54mm_Vertical
J2: 10Vin_Conn_01x02; PinHeader_1x02_P2.54mm_Vertical
J3: 12Vin_Conn_01x01; PinHeader_1x01_P2.54mm_Vertical
J4: 5Vin_Conn_01x01; PinHeader_1x01_P2.54mm_Vertical
J5: GND_Conn_01x02; PinHeader_1x02_P2.54mm_Vertical
J6: (10V)IN-; PinHeader_1x01_P2.54mm_Vertical
J7: (12V)IN+; PinHeader_1x01_P2.54mm_Vertical
J8: (12V)IN-; PinHeader_1x01_P2.54mm_Vertical
J9: (10V)OUTPUT+; PinHeader_1x01_P2.54mm_Vertical
J10: (10V)OUTPUT-; PinHeader_1x01_P2.54mm_Vertical
J11: (12V)OUTPUT+; PinHeader_1x01_P2.54mm_Vertical
J12: (12V)OUTPUT-; PinHeader_1x01_P2.54mm_Vertical
J13: 24Vin_Conn_01x01; PinHeader_1x01_P2.54mm_Vertical
J14: outputs_Screw_Terminal_01x03; TerminalBlock_Phoenix_MKDS-1,5-3_1x03_P5.00mm_Horizontal
J15: Screw_Terminal_01x02; TerminalBlock_Phoenix_MKDS-1,5-2_1x02_P5.00mm_Horizontal
U2: LM7805_TO220; TO-220-3_Vertical

Connections:
+5V: C4.1, C5.1, J4.1, J14.2, U2.3 (VO)
+10V: J2.1, J2.2, J9.1
+12V: C2.1, C3.1, J3.1, J11.1, J14.1, U2.1 (VI)
+24V: D1.1 (K), J1.1, J7.1, J13.1
/24Vin: D1.2 (A), J15.2
GND: C2.2, C3.2, C4.2, C5.2, J5.1, J5.2, J6.1, J8.1, J10.1, J12.1, J14.3, J15.1, U2.2 (GND)

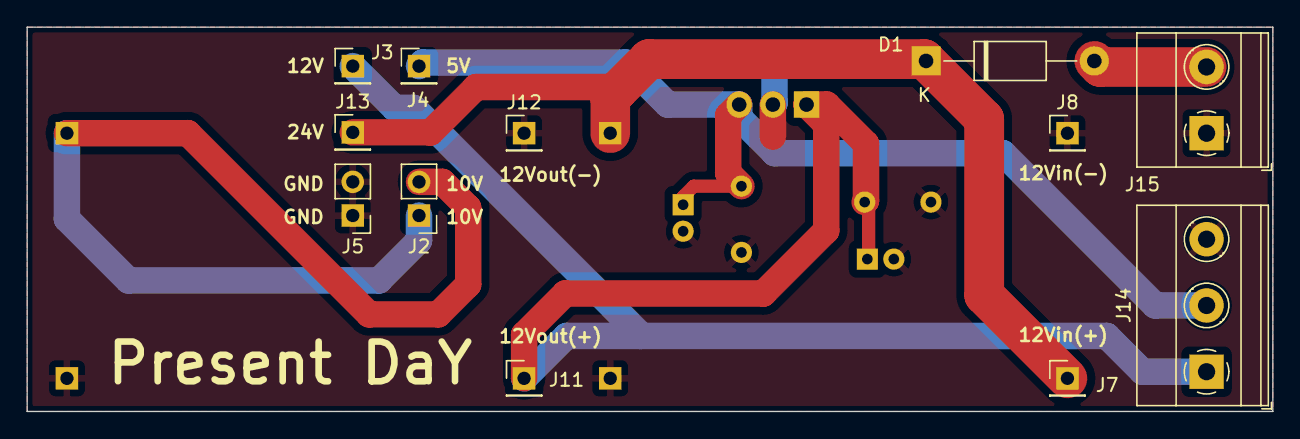
[picture p149: board schematicPowerSourcePLC_V0.1.kicad_pcb from above]

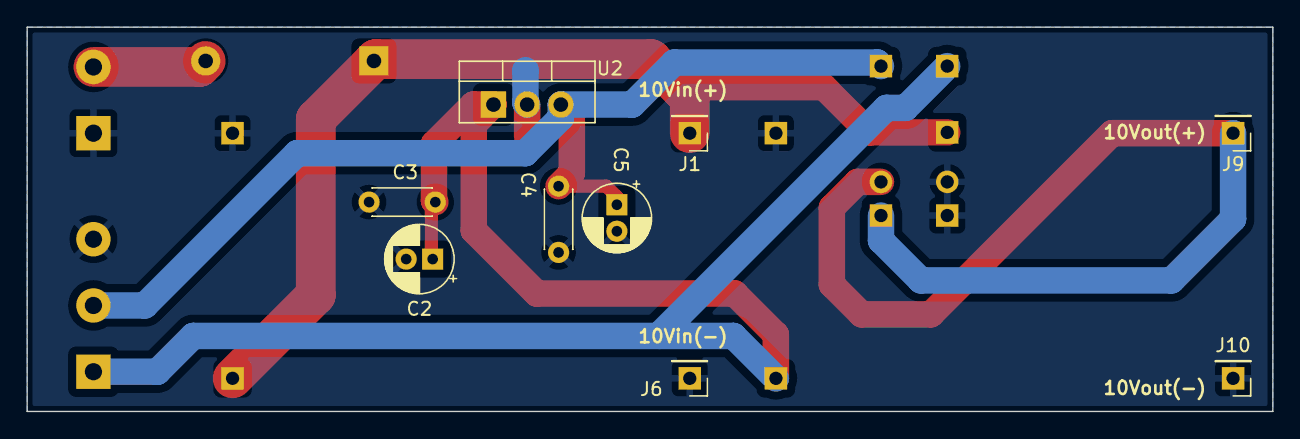
[picture p150: board schematicPowerSourcePLC_V0.1.kicad_pcb from below]

Board: 2 copper layers, 94.0 x 29.0 mm, 21 parts (9 on the bottom side), 6 nets.
